Fmulder007/Karat-3.5/Photo/image002.jpg

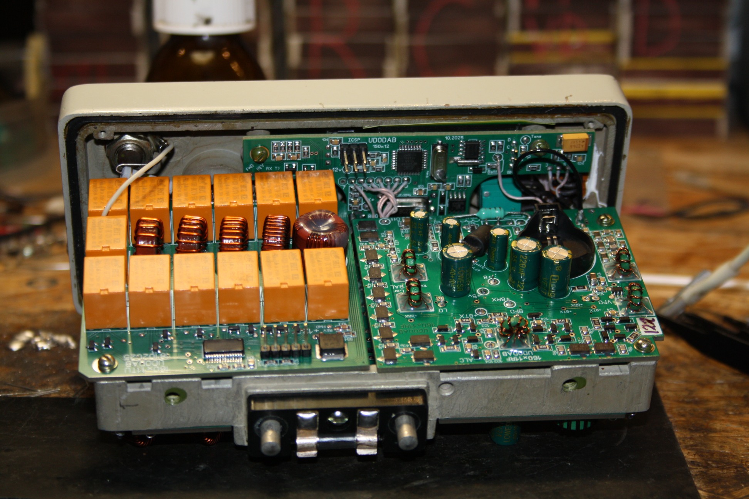
Photo/image002.jpg
