Fmulder007/Karat-3.5/Photo/2025-08-27_00-19-41.jpg

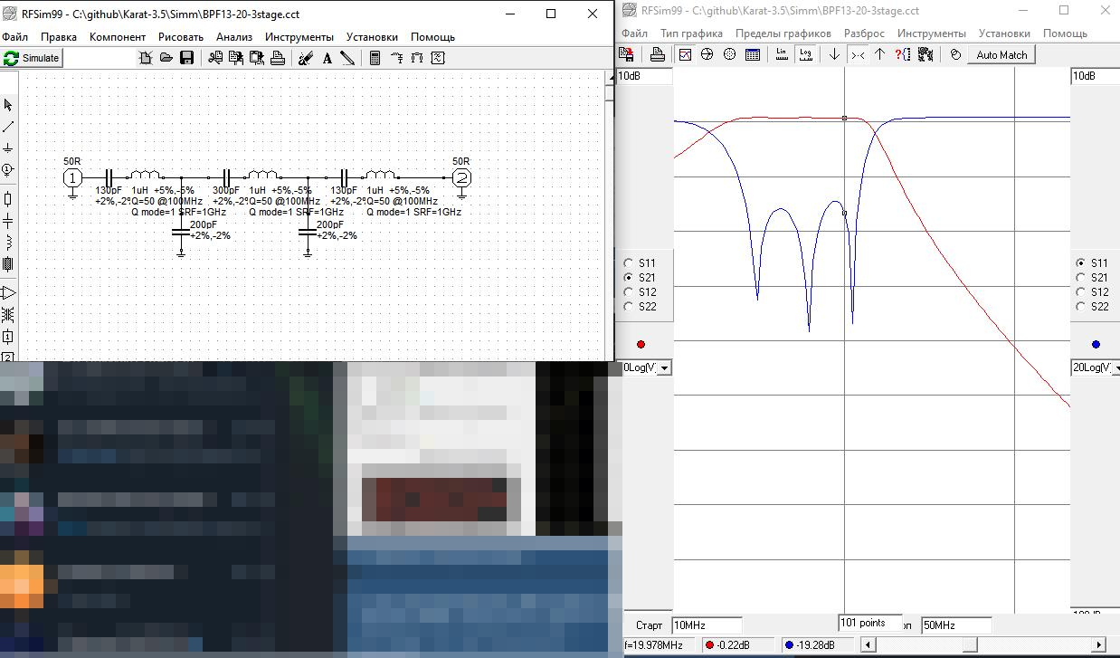
Photo/2025-08-27_00-19-41.jpg
