Fmulder007/Karat-3.5/Man/test.tex

\documentclass[12pt]{article}
% Эта строка — комментарий, она не будет показана в выходном файле
\usepackage{ucs}
\usepackage[utf8x]{inputenc} % Включаем поддержку UTF8
\usepackage[russian]{babel}  % Включаем пакет для поддержки русского языка
\title{\LaTeX}
\date{}
\author{}

\begin{document}
  %\maketitle
  \LaTeX{} "--- это своего рода препроцессор текста для \TeX{} "---
  программы компьютерной вёрстки. \LaTeX{} является программируемым и
  расширяемым, что позволяет автоматизировать большую часть аспектов
  набора, включая нумерацию, перекрёстные ссылки, таблицы и изображения
  (их размещение и подписи к ним), общий вид страницы, библиографию и
  многое-многое другое. \LaTeX{} был первоначально написан Лэсли Лампортом
  в 1984-м году и стал наиболее популярным способом использования \TeX{}а;
  очень мало людей сегодня пишут на оригинальном \TeX{}е. Текущей
  версией является \LaTeXe.
  \newline
  \begin{eqnarray}
    E &=& mc^2\\
    m &=& \frac{m_0}{\sqrt{1-\frac{v^2}{c^2}}}
  \end{eqnarray}
\end{document}
