Fmulder007/Karat-3.5/3D/Front_Panel.pdf

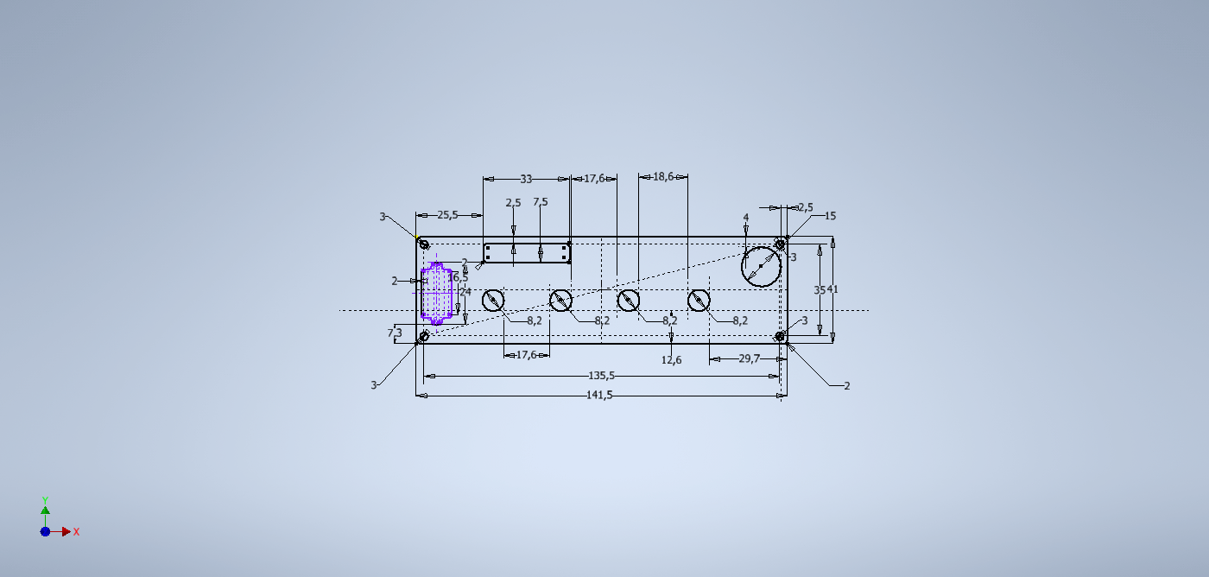
[picture p10: page 1]
