Fmulder007/Karat-3.5/Code/160x03/Карта меню.pdf

0 | Главный экран | Блок, если №100 = "Yes"
Быстрое меню:
1 | Канал | Блок, если №22 = "0"
2 | Шаг настройки | Блок, если №100 = "Yes"
3 | Полоса LSB/USB | Блок, если №100 = "Yes"
Пользовательское меню:
20 | Нижняя граница настройки(Канала) | Блок, если №100 = "Yes"
21 | Верхняя граница настройки(Канала) | Блок, если №100 = "Yes"
22 | Количество каналов | Блок, если №100 = "Yes"
23 | Часы
24 | Минуты
25 | CW Задержка
26 | CW тон
27 | Делитель энкодера | Блок, если №100 = "Yes"
28 | Реверс энкодера | Блок, если №100 = "Yes"
Инженерное меню | Вход Knob+PWR
100 | Канальный режим вкл/выкл
101 | Калибровка вольтметра
102 | Калибровка термометра
103 | Частота кварца синтезатора
104 | Частота 2пч RX LSB
105 | Частота 2пч TX LSB
106 | Частота 2пч RX USB
107 | Частота 2пч TX USB
108 | Коррекция 1пч
109 | Pulse Mode Yes/No
110 | ФНЧ передатчика
