Fmulder007/Karat-3.5/3D/Front_Panel.tiff

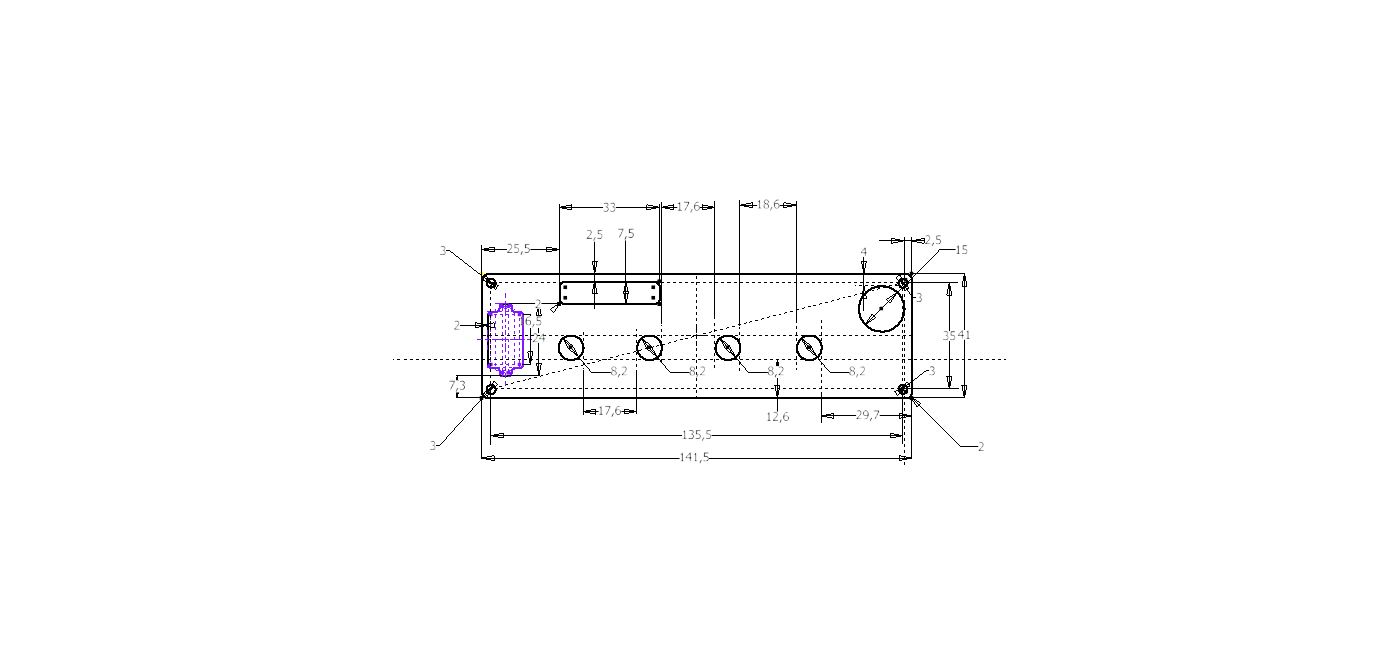
3D/Front_Panel.tiff
