Fmulder007/Karat-3.5/AFC/101-13M.jpg

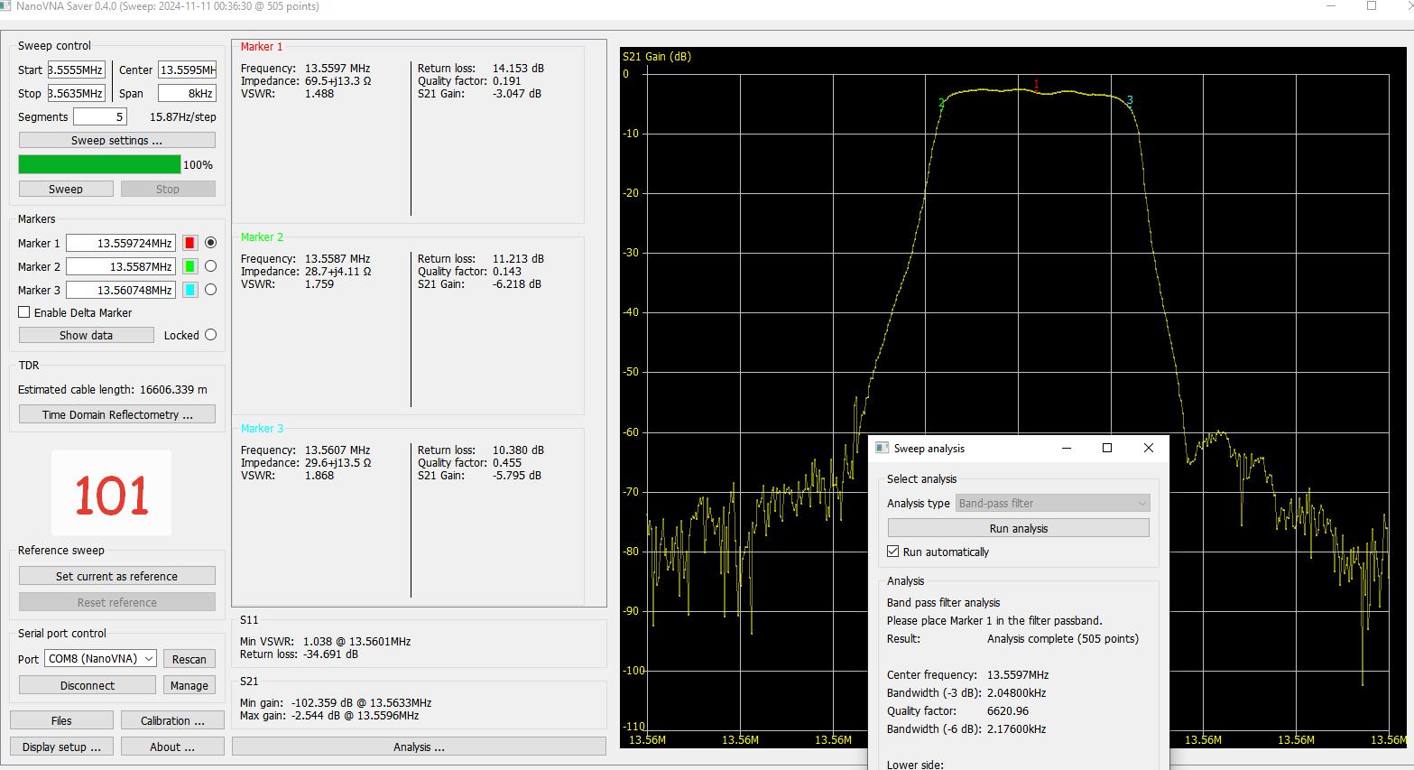
AFC/101-13M.jpg
