Fmulder007/Karat-3.5/AFC/101-48M.jpg

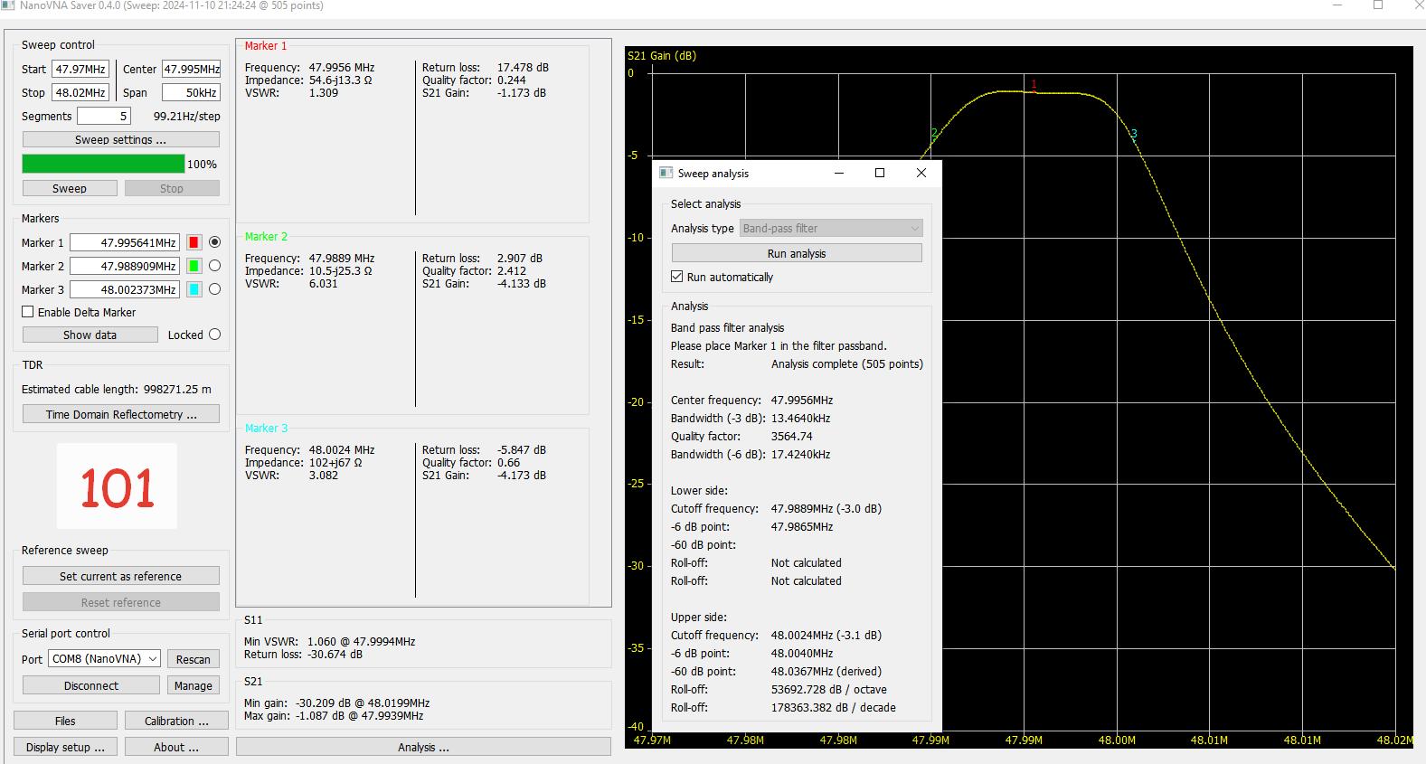
AFC/101-48M.jpg
