Fmulder007/Karat-3.5/AFC/101-LPF.jpg

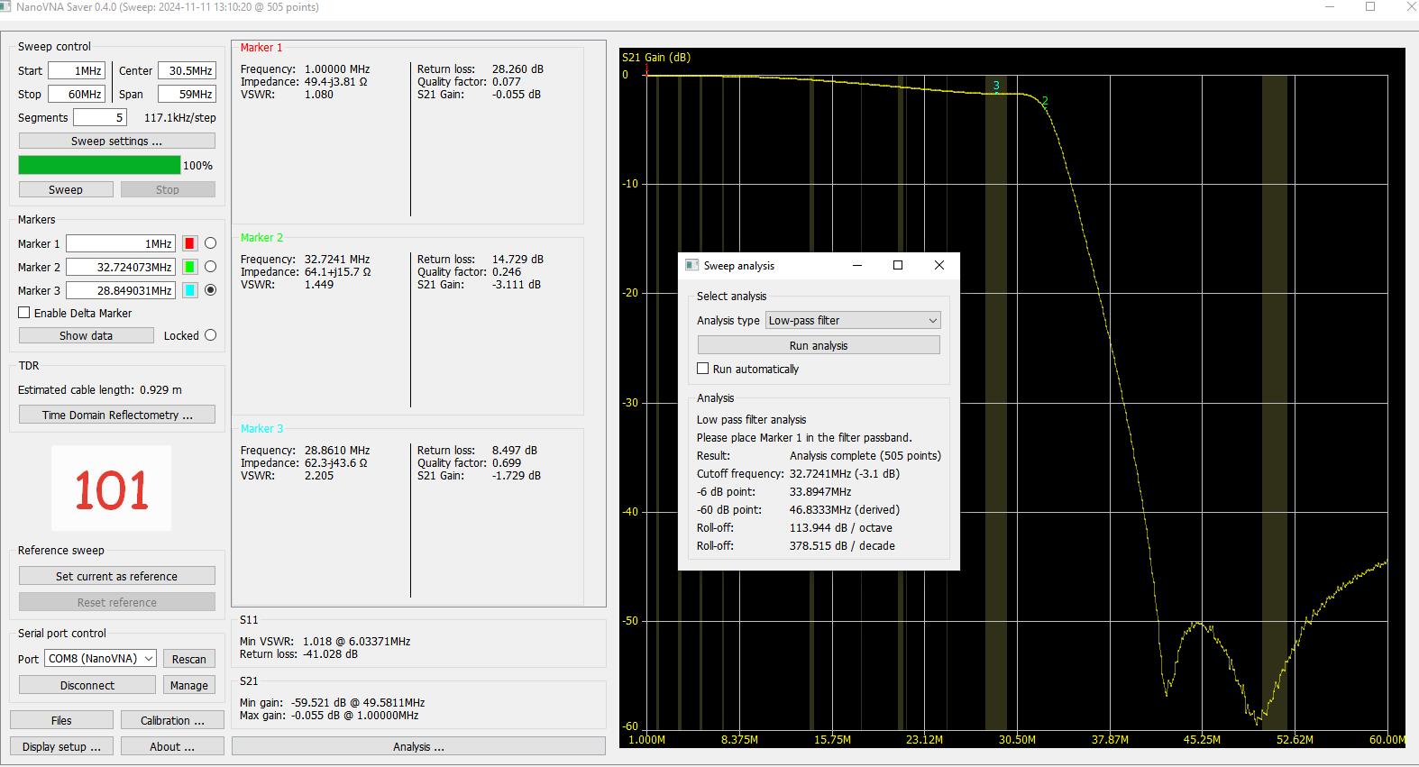
AFC/101-LPF.jpg
