Fmulder007/Karat-3.5/AFC/102-13M.jpg

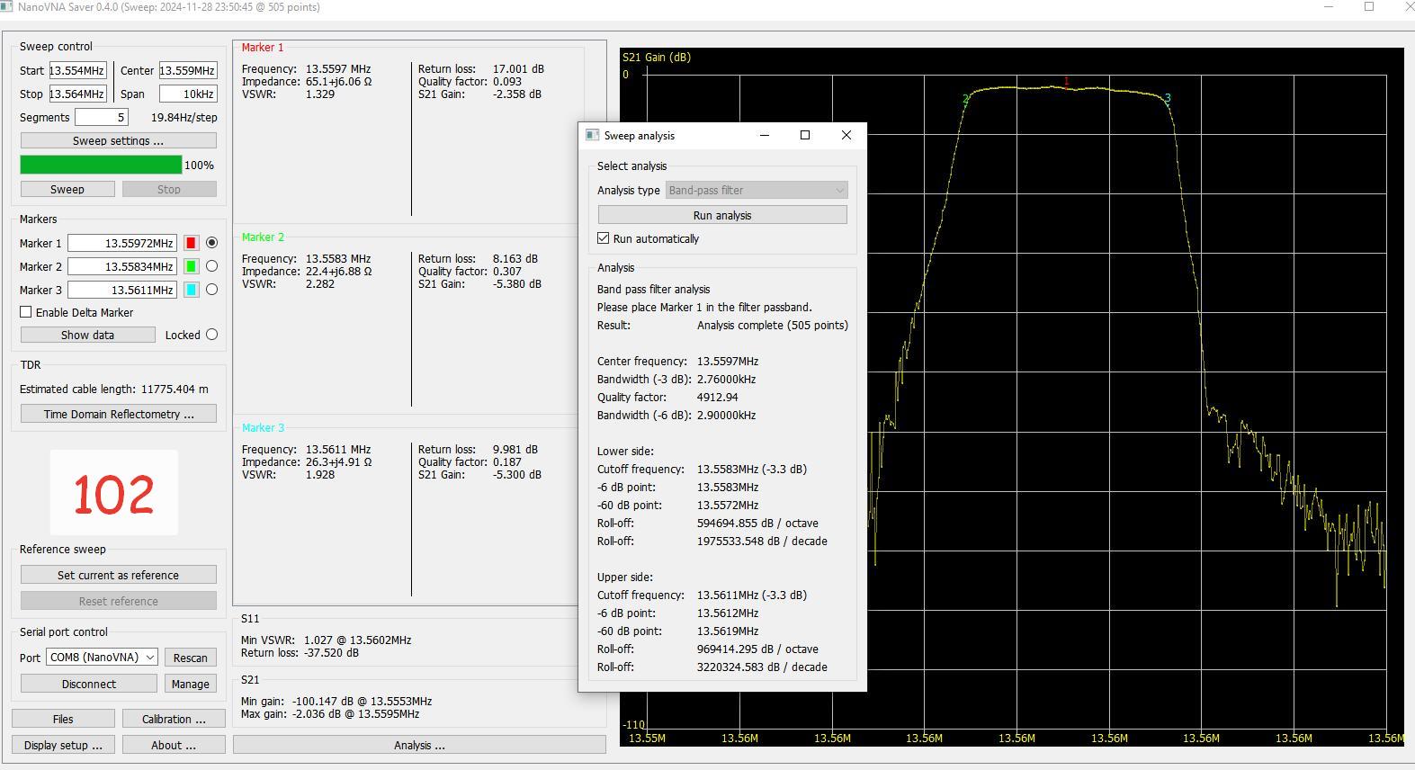
AFC/102-13M.jpg
