Fmulder007/Karat-3.5/AFC/102-48M.jpg

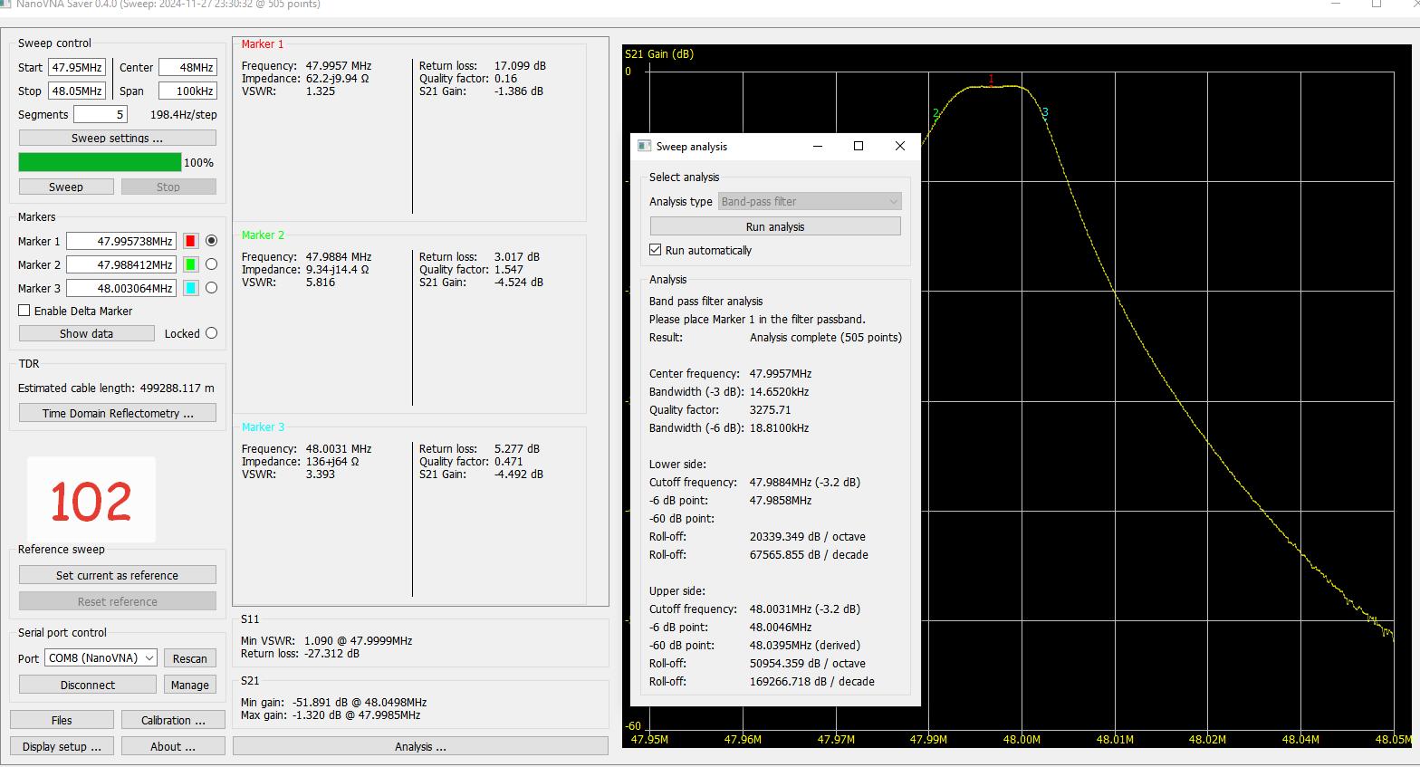
AFC/102-48M.jpg
