Fmulder007/Karat-3.5/AFC/103-13M.jpg

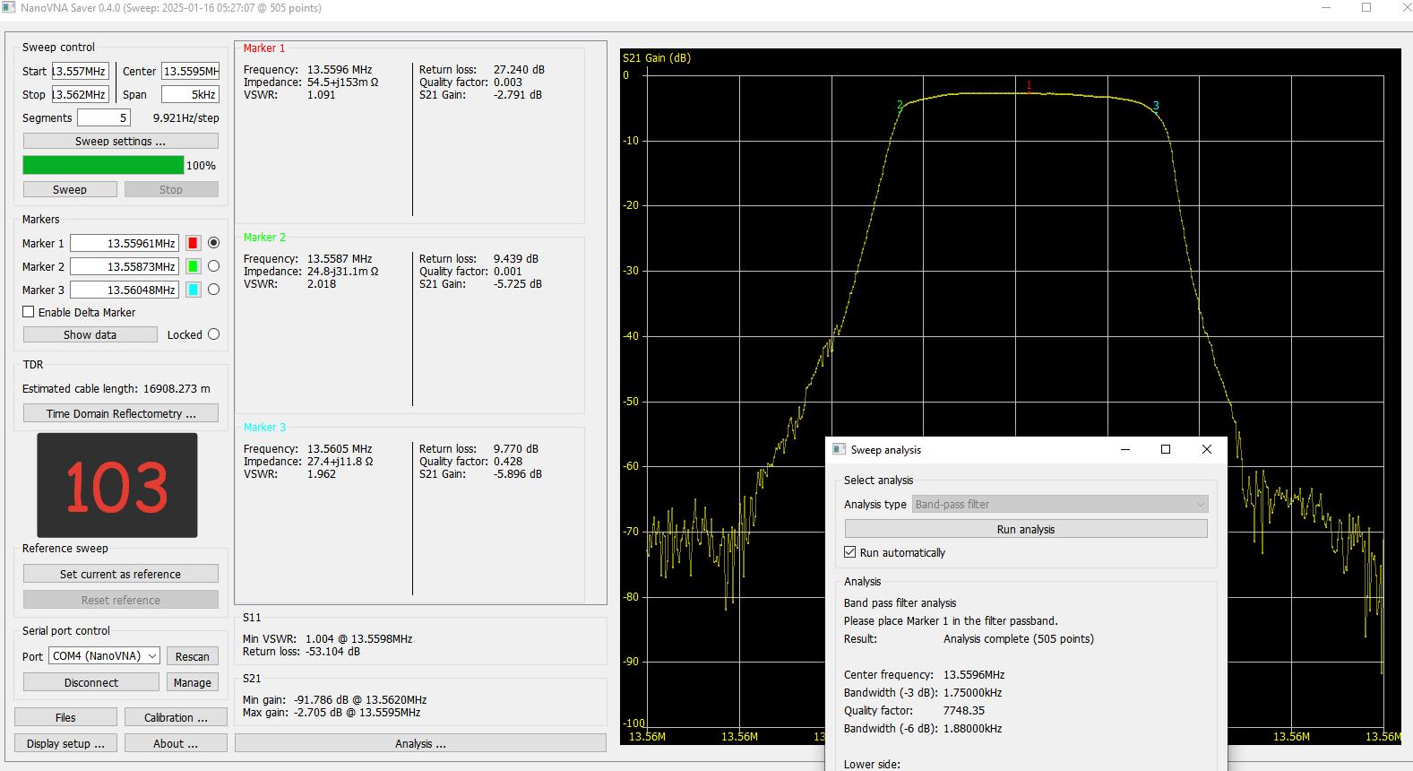
AFC/103-13M.jpg
