Fmulder007/Karat-3.5/AFC/104-13M.jpg

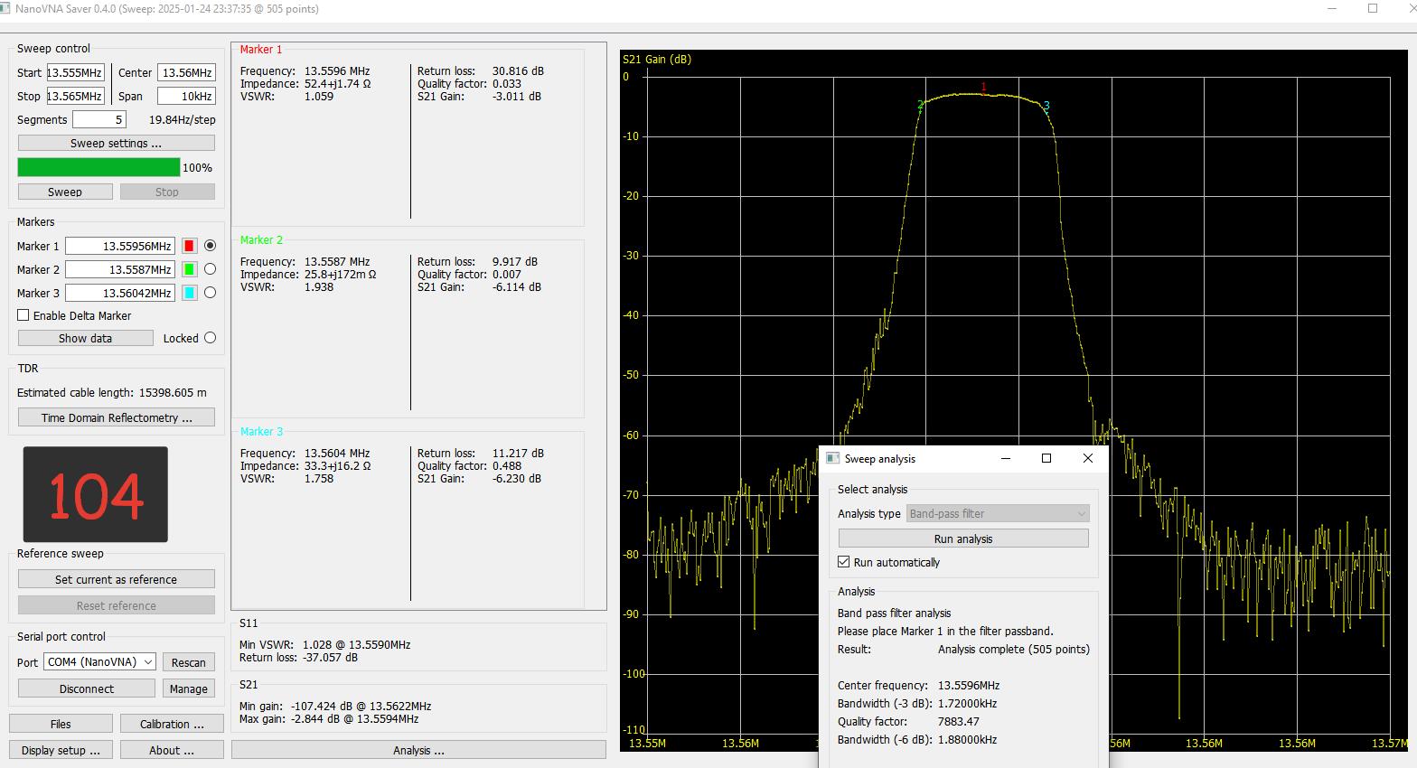
AFC/104-13M.jpg
