Fmulder007/Karat-3.5/AFC/105-13M.jpg

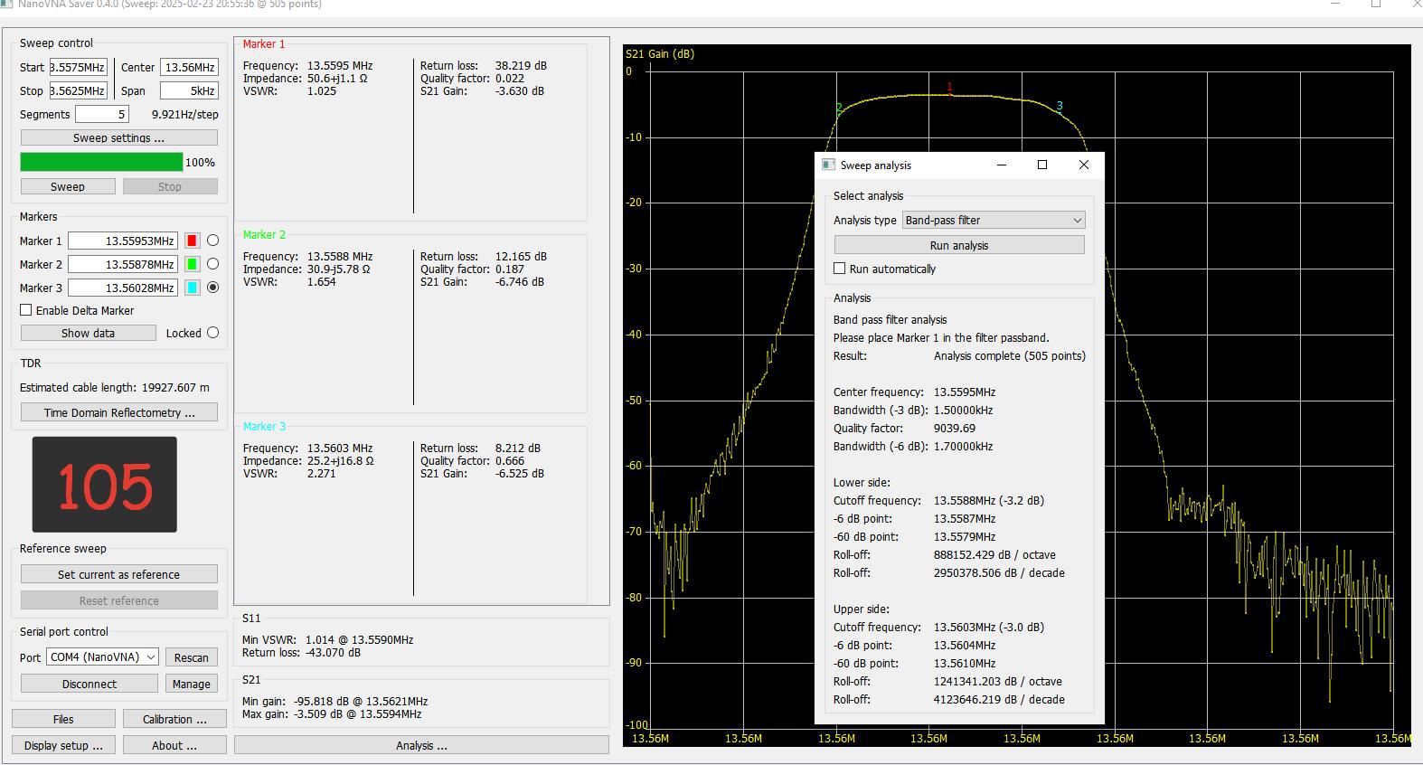
AFC/105-13M.jpg
