Fmulder007/Karat-3.5/AFC/105-LPF.jpg

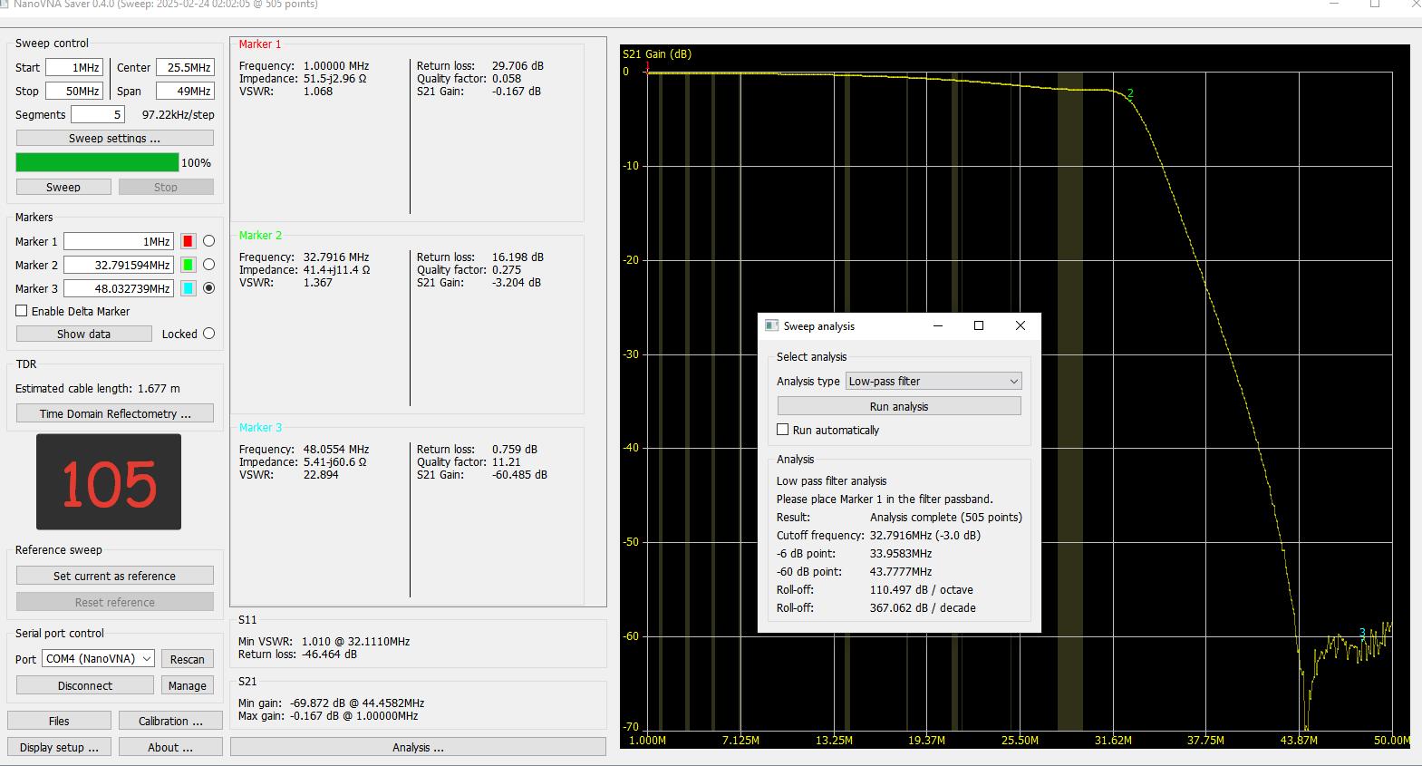
AFC/105-LPF.jpg
