Fmulder007/Karat-3.5/AFC/106-13M.jpg

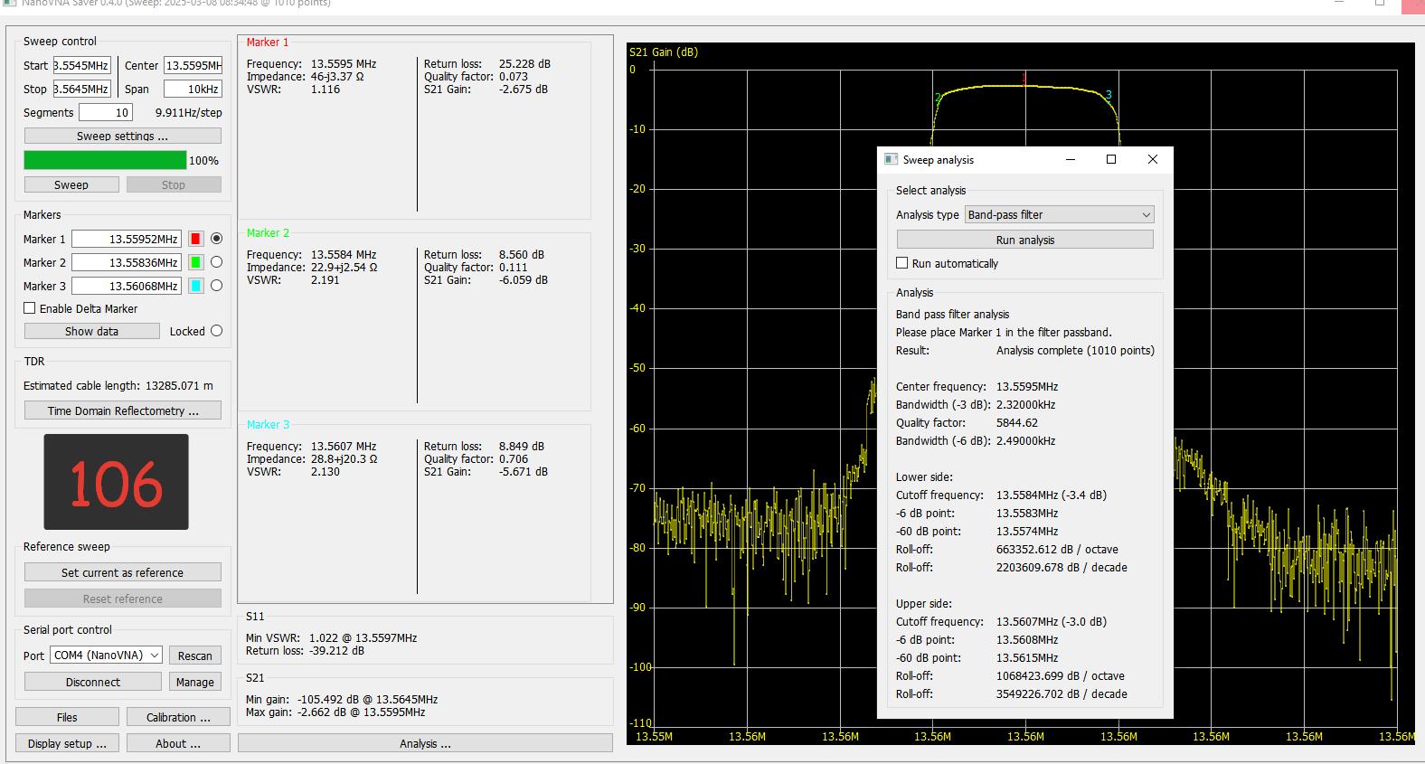
AFC/106-13M.jpg
