Fmulder007/Karat-3.5/AFC/106-LPF.jpg

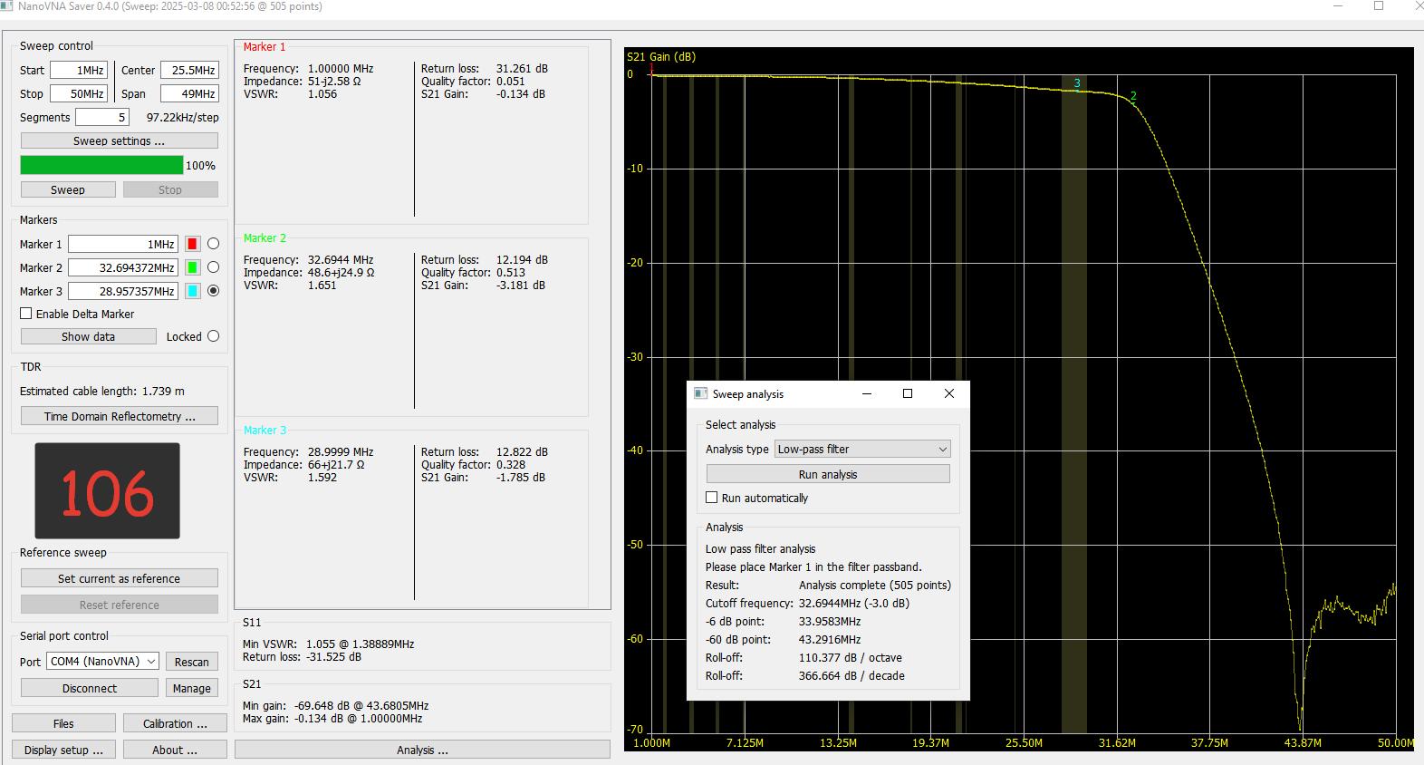
AFC/106-LPF.jpg
