Fmulder007/Karat-3.5/AFC/107-48M.jpg

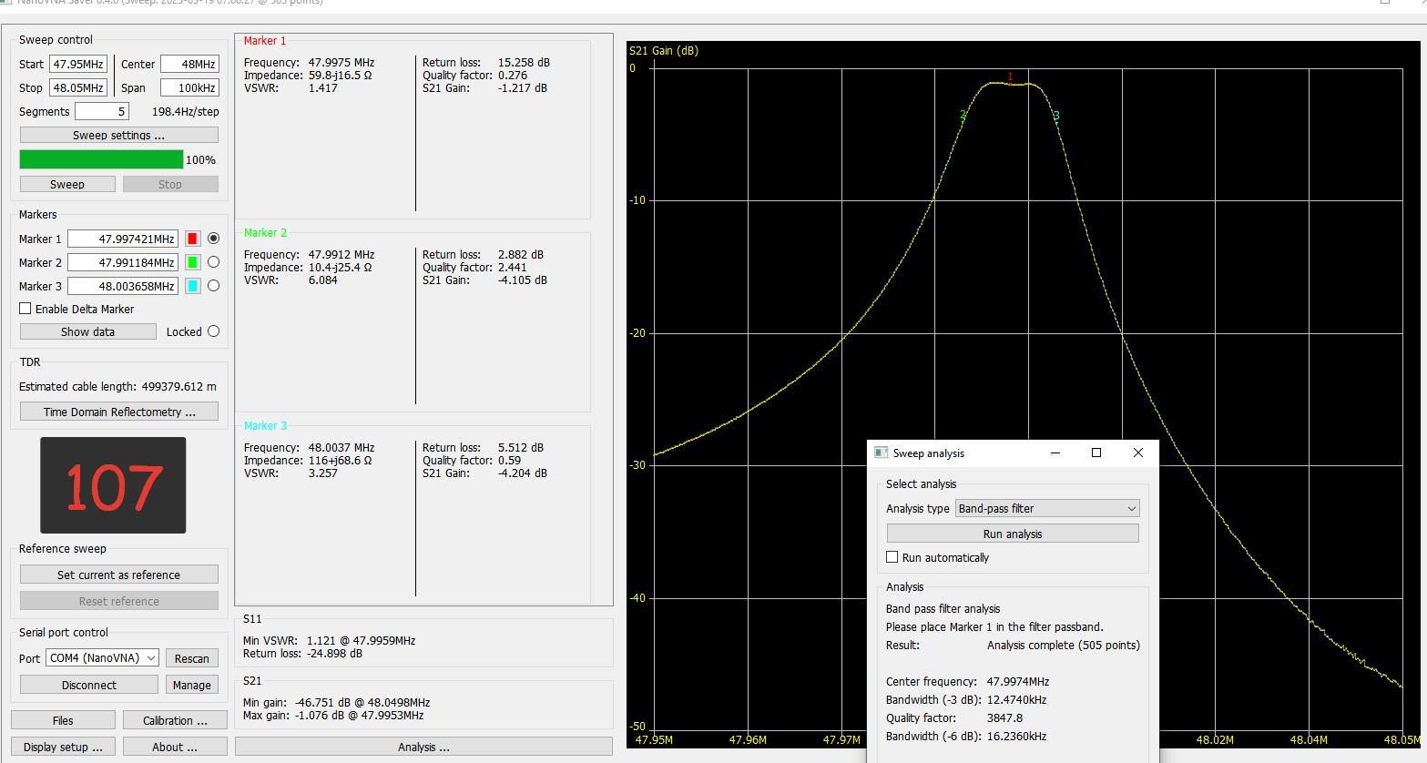
AFC/107-48M.jpg
