Fmulder007/Karat-3.5/AFC/108-48M.jpg

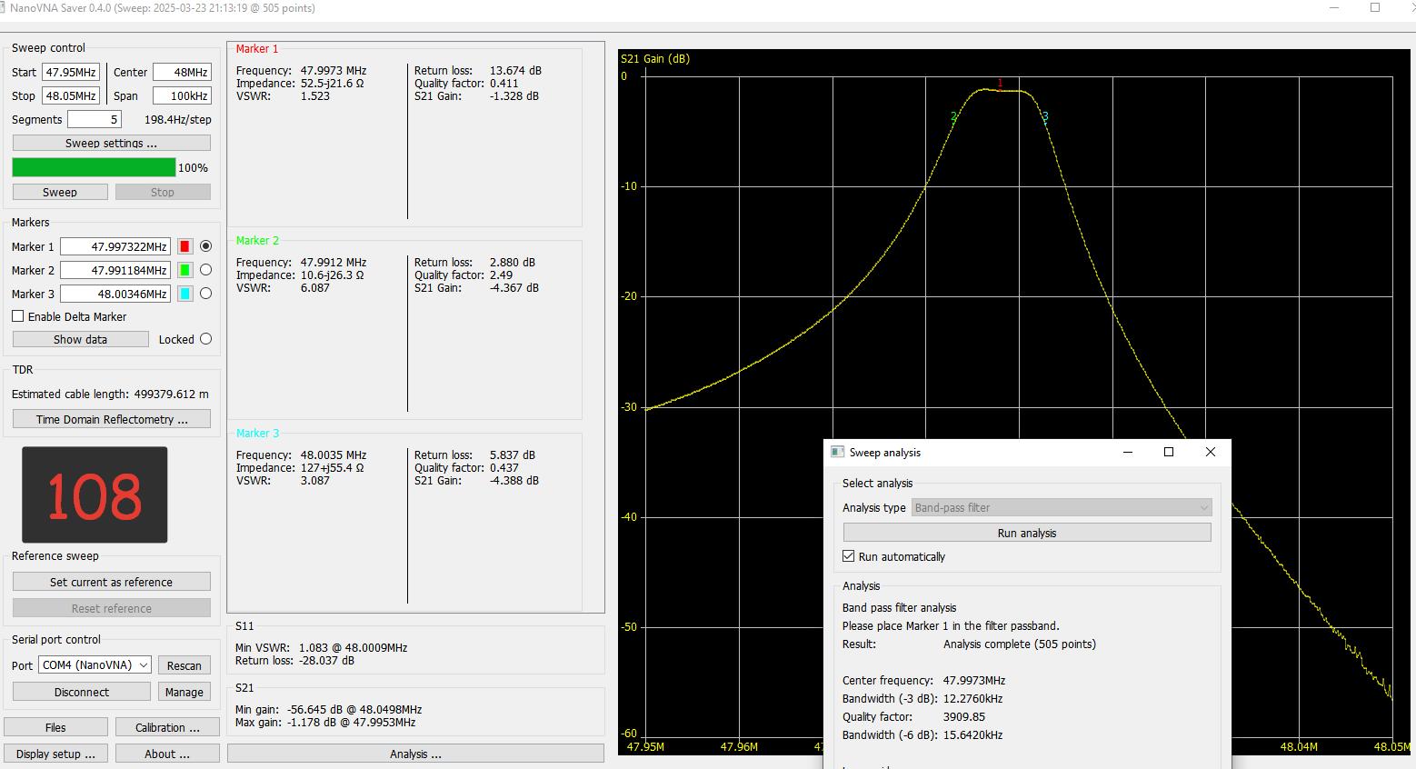
AFC/108-48M.jpg
