Fmulder007/Karat-3.5/AFC/109-13M.jpg

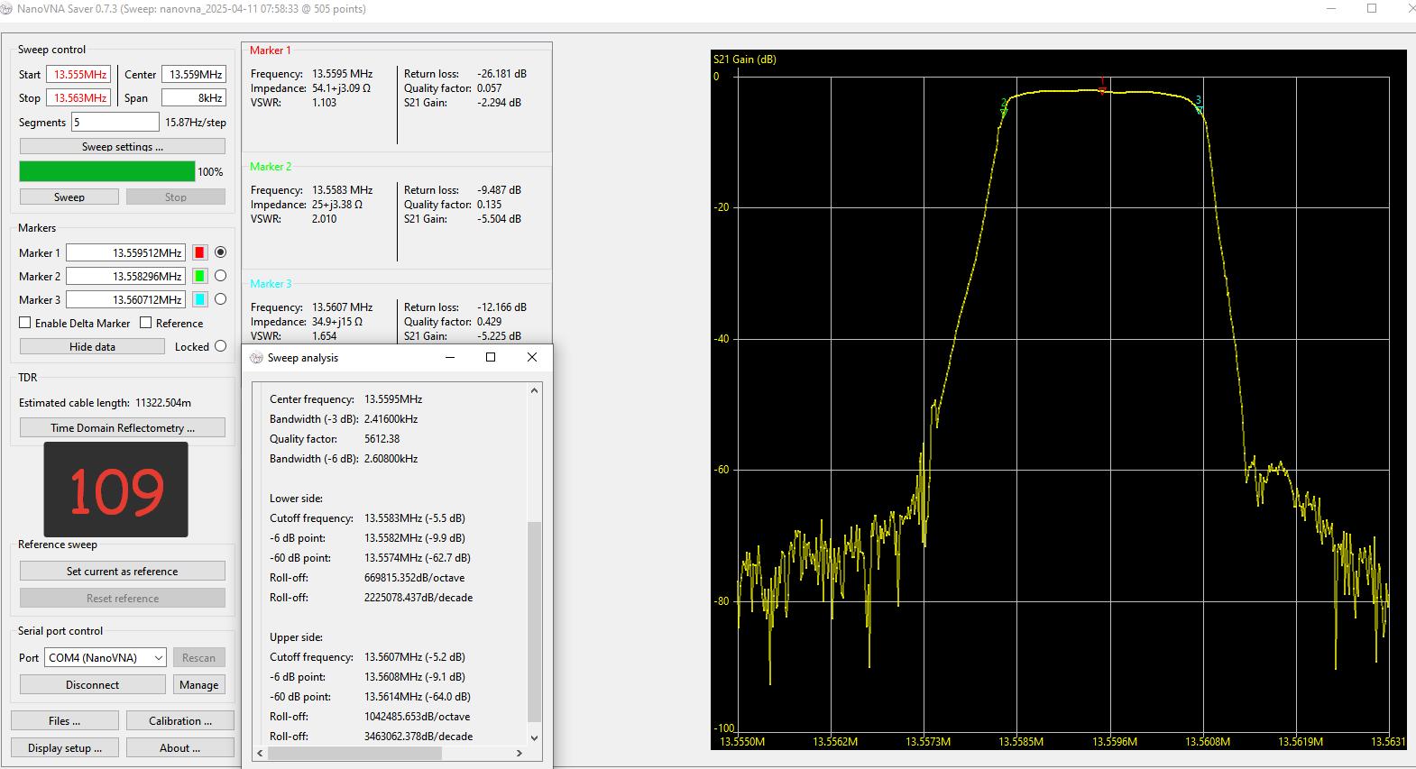
AFC/109-13M.jpg
