Fmulder007/Karat-3.5/AFC/109-48M.jpg

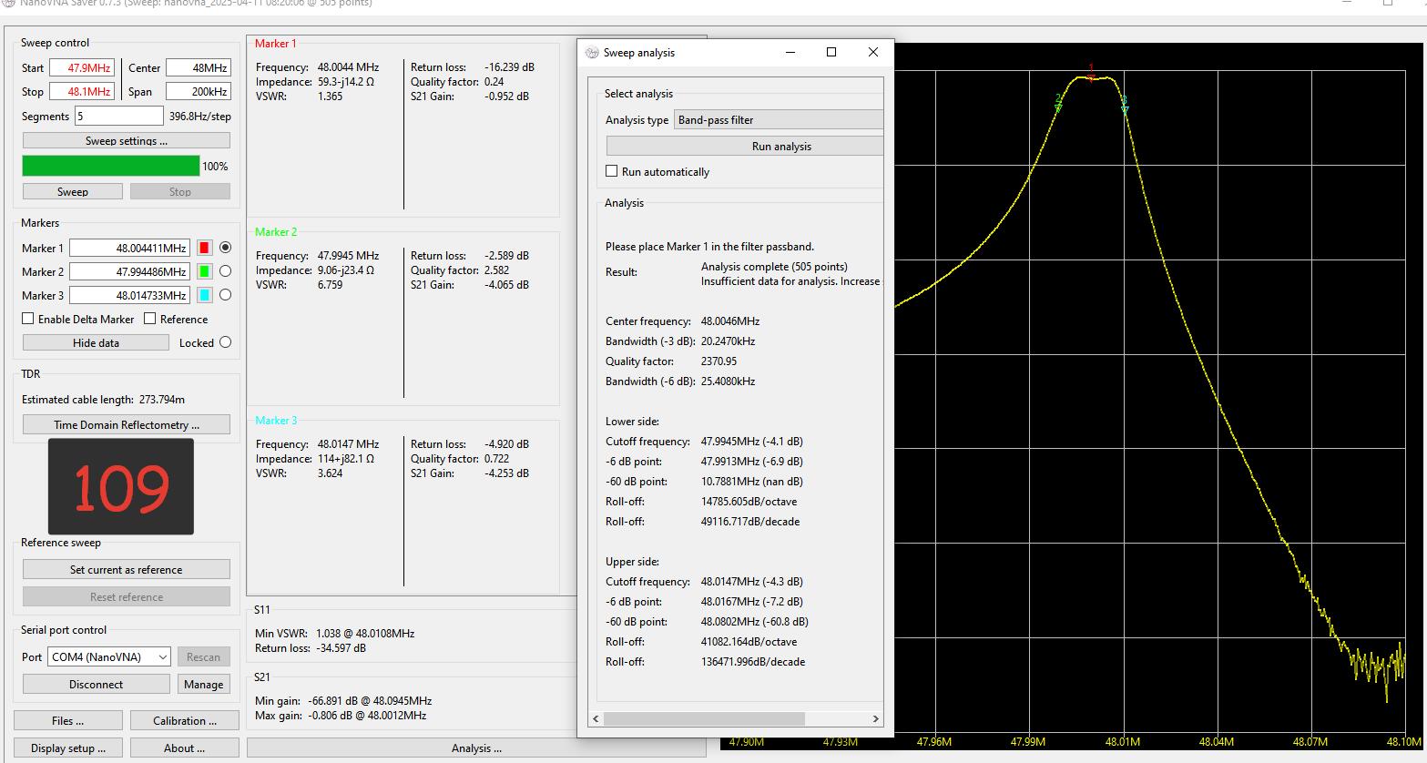
AFC/109-48M.jpg
