Fmulder007/Karat-3.5/AFC/110-13M.jpg

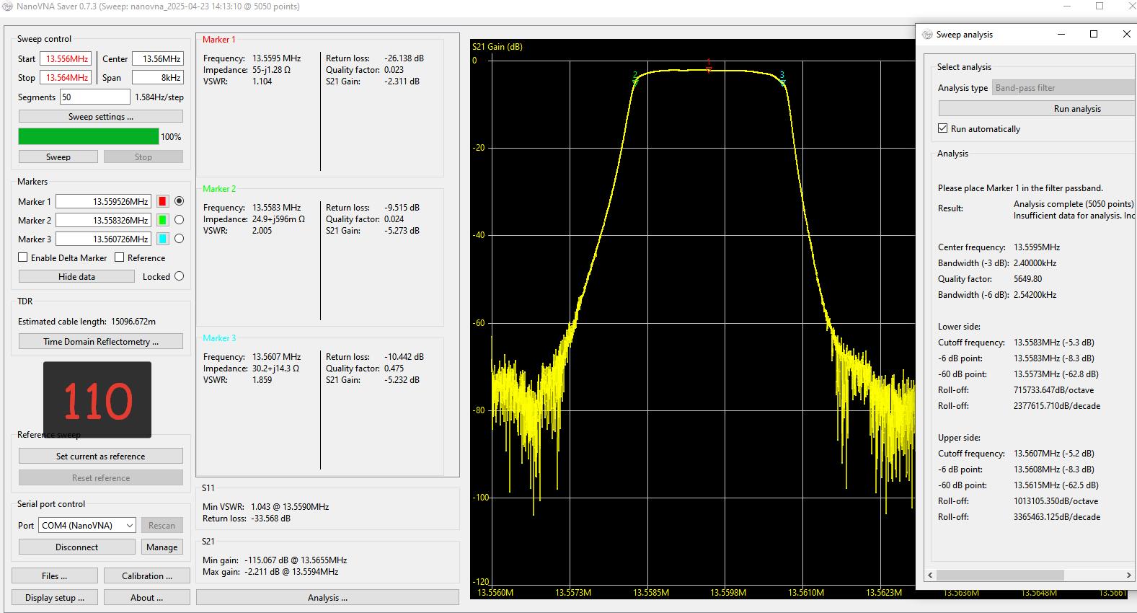
AFC/110-13M.jpg
