Fmulder007/Karat-3.5/AFC/110-48M.jpg

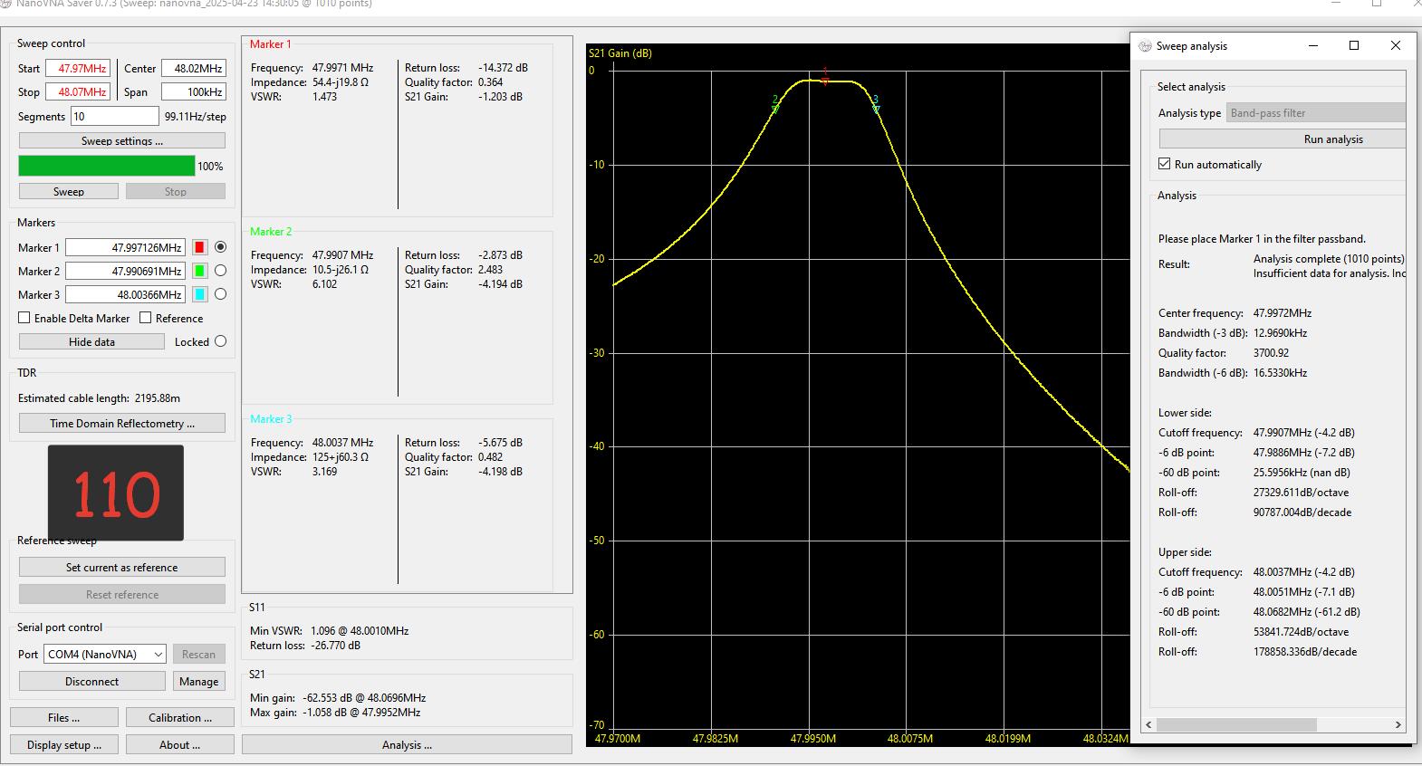
AFC/110-48M.jpg
