Fmulder007/Karat-3.5/AFC/111-13M.jpg

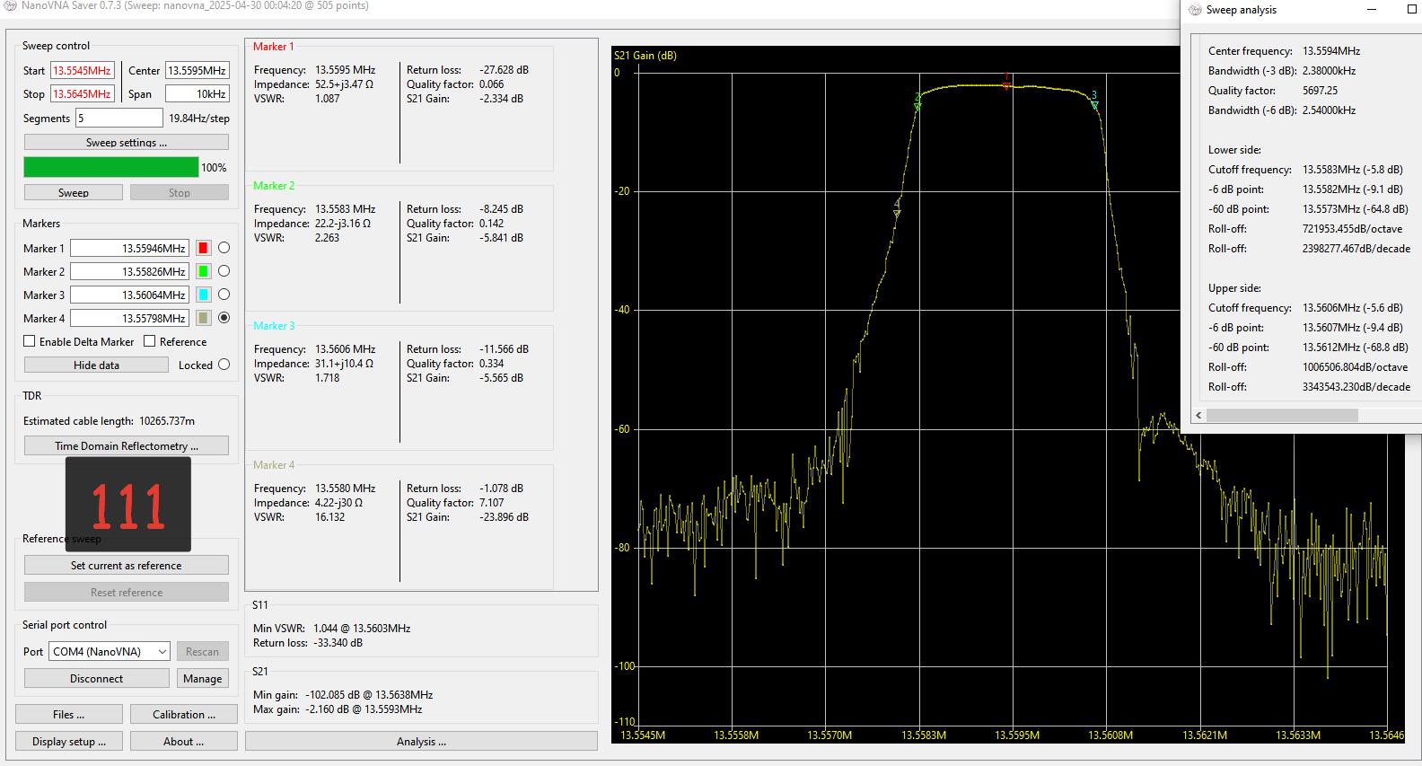
AFC/111-13M.jpg
