Fmulder007/Karat-3.5/AFC/112-13M.jpg

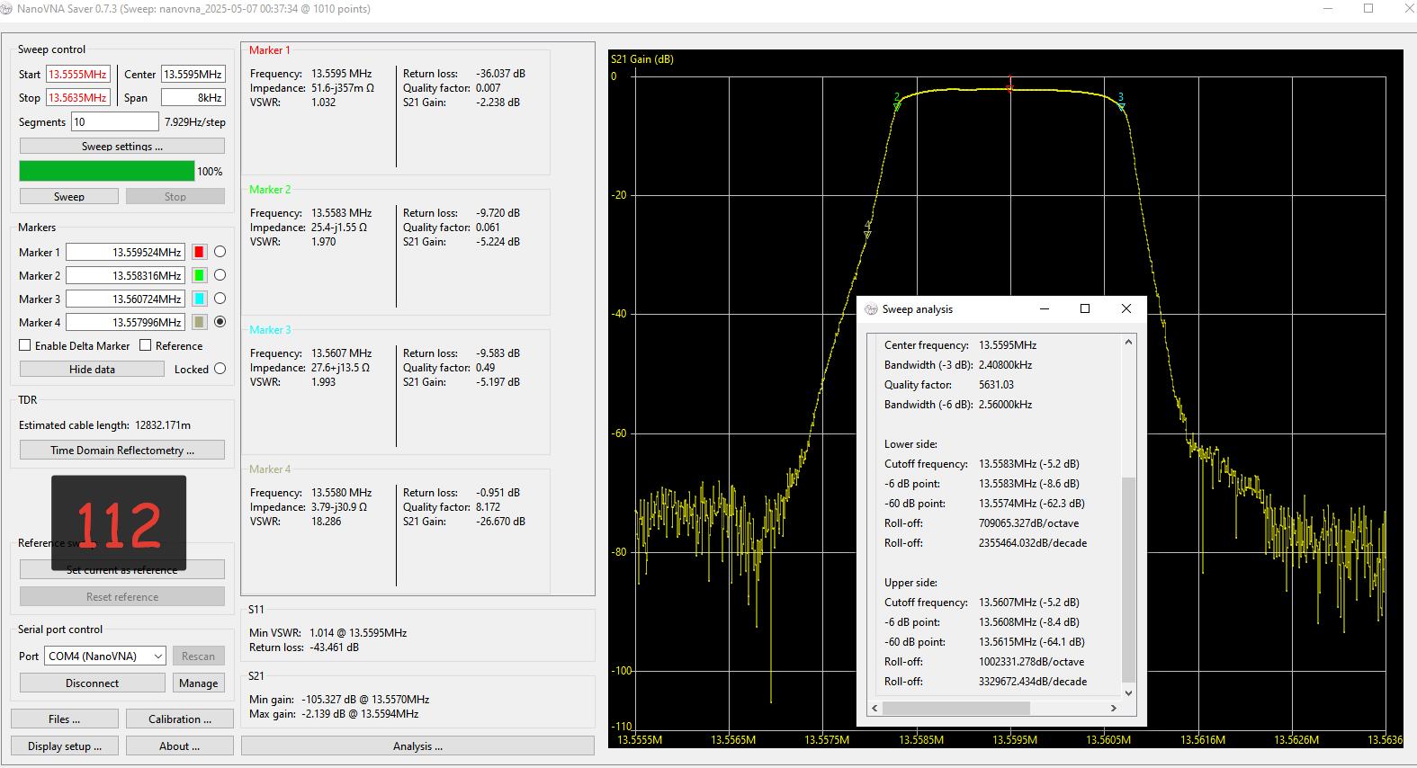
AFC/112-13M.jpg
