Fmulder007/Karat-3.5/AFC/112-48M.jpg

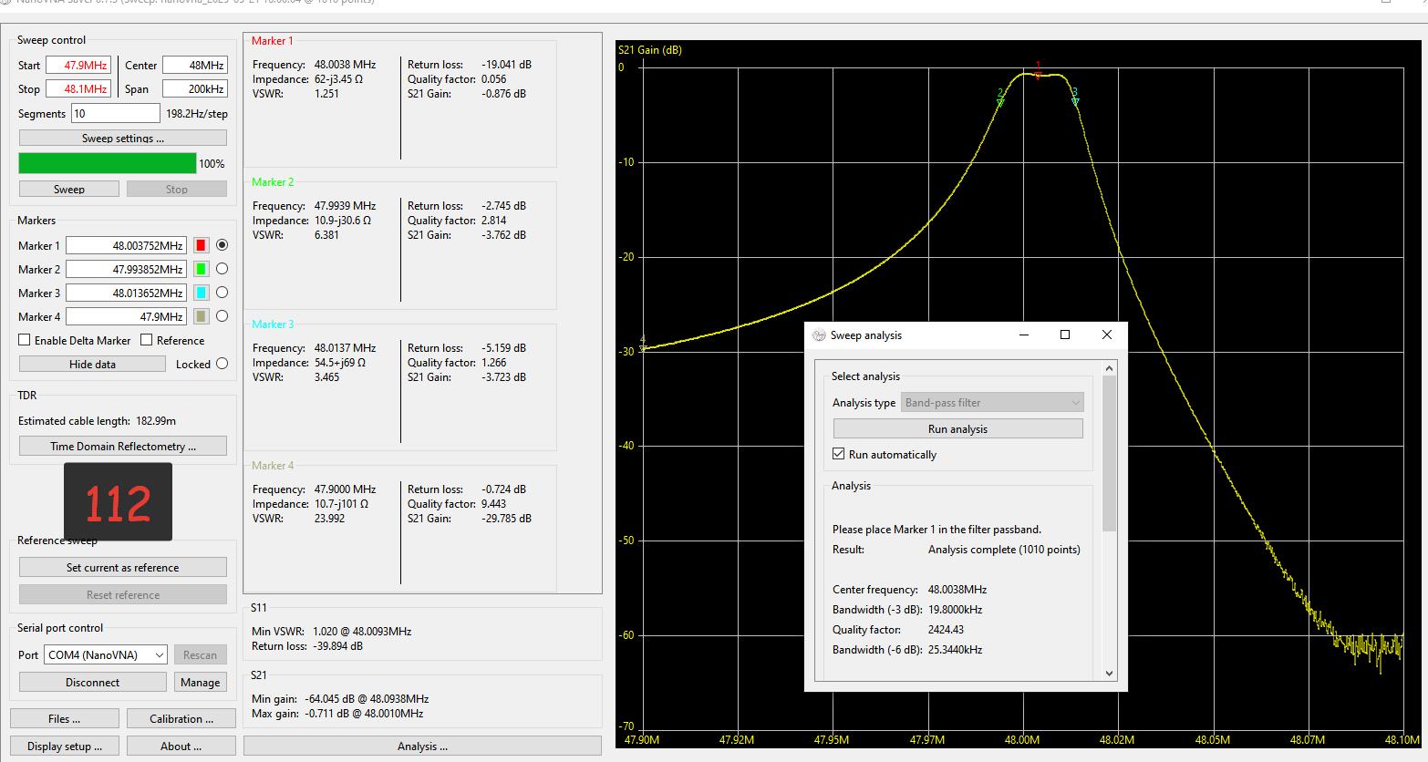
AFC/112-48M.jpg
