Fmulder007/Karat-3.5/AFC/112-LPF.jpg

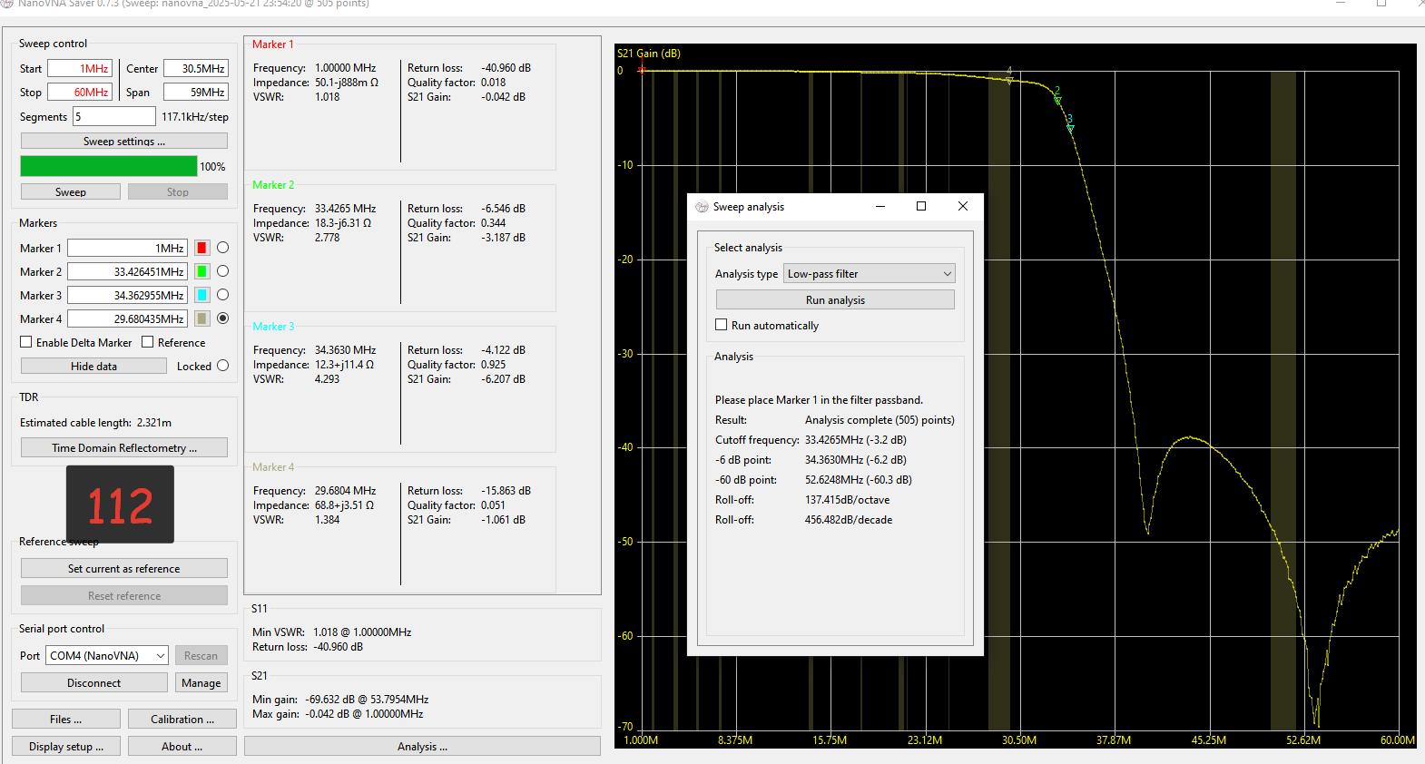
AFC/112-LPF.jpg
