Fmulder007/Karat-3.5/AFC/113-48M.jpg

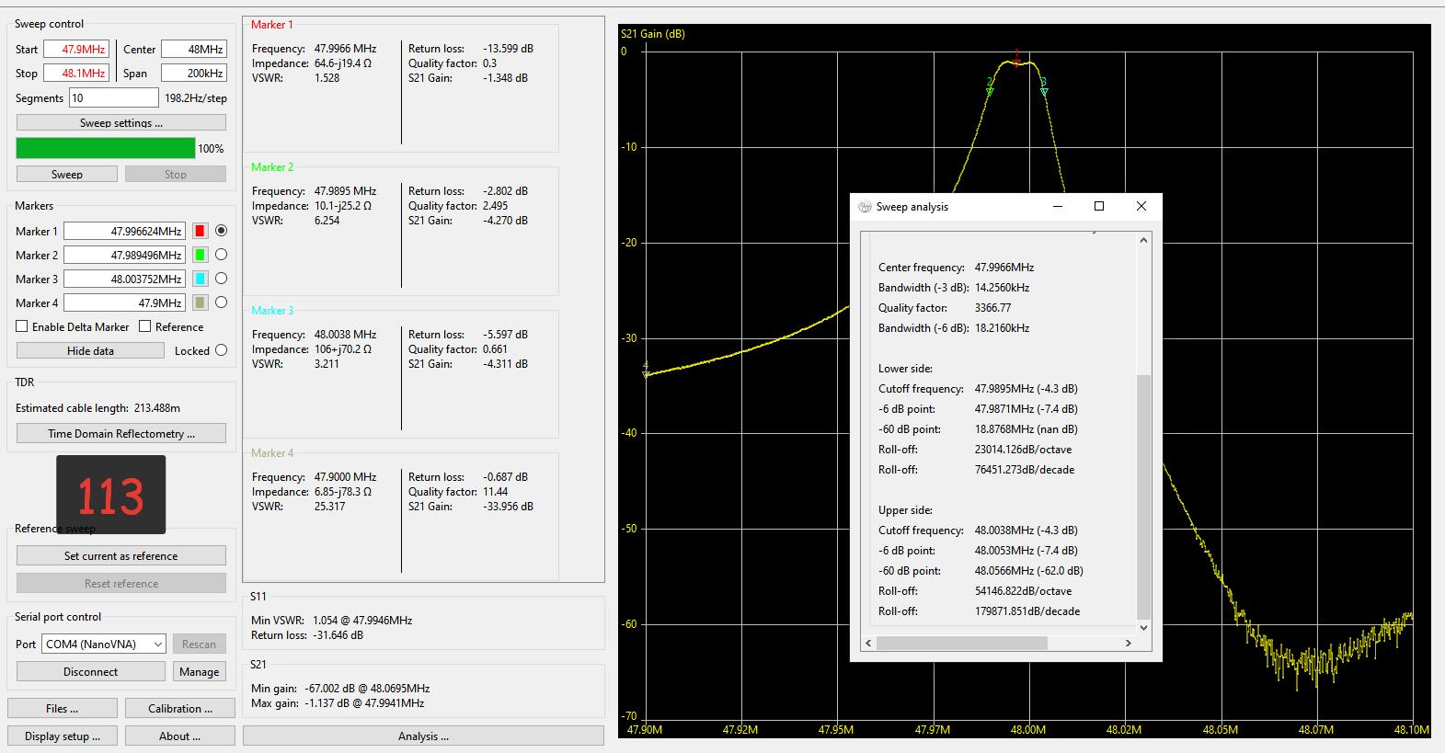
AFC/113-48M.jpg
