Fmulder007/Karat-3.5/AFC/113-LPF.jpg

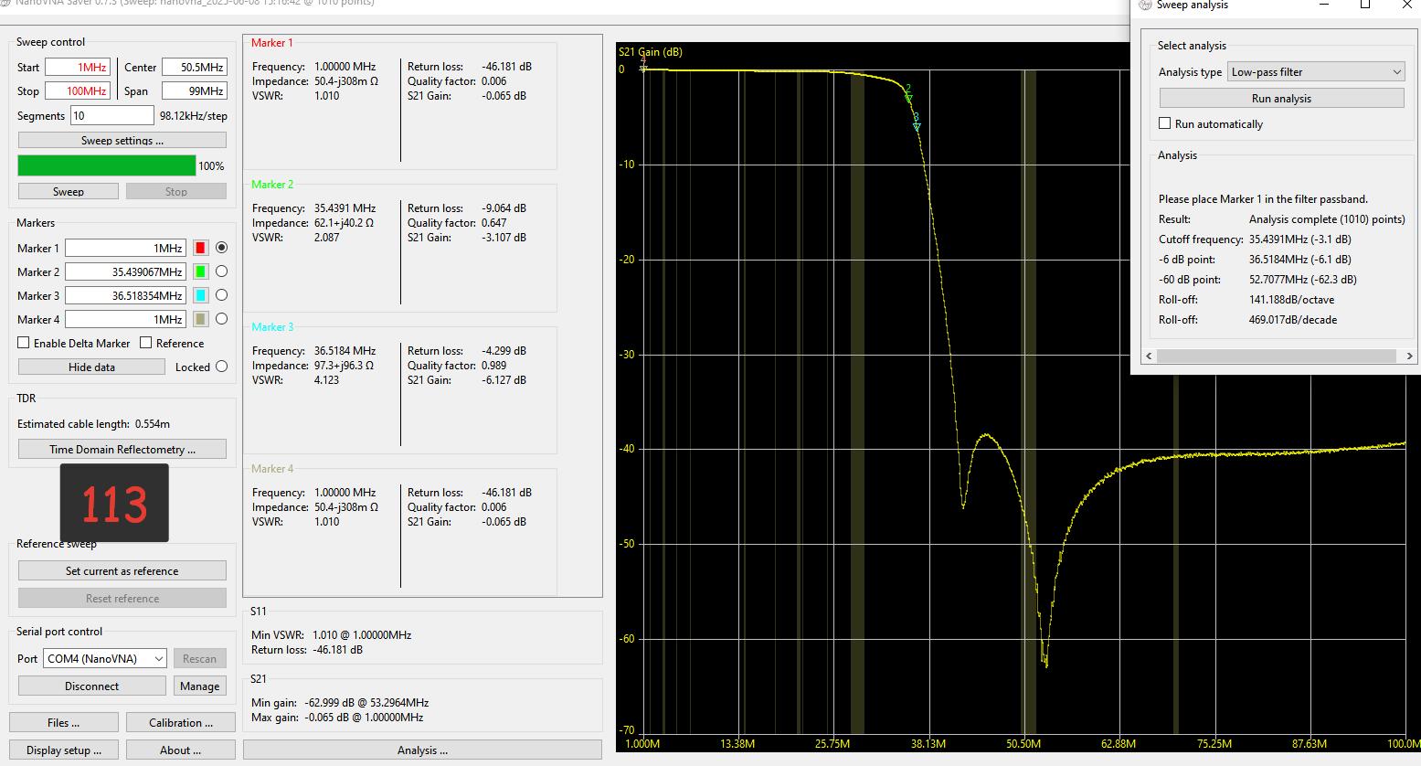
AFC/113-LPF.jpg
