Fmulder007/Karat-3.5/AFC/114-13M.jpg

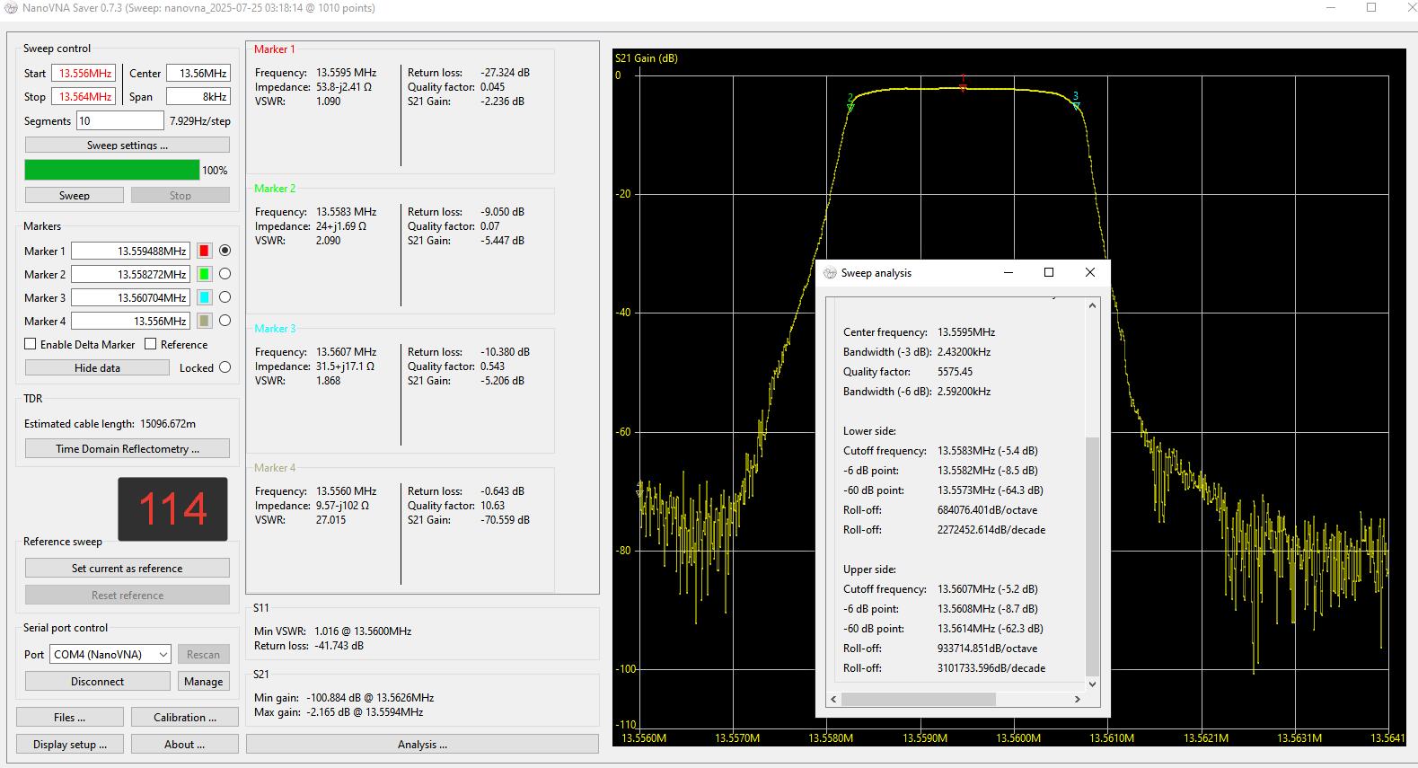
AFC/114-13M.jpg
