Fmulder007/Karat-3.5/AFC/114-48M.jpg

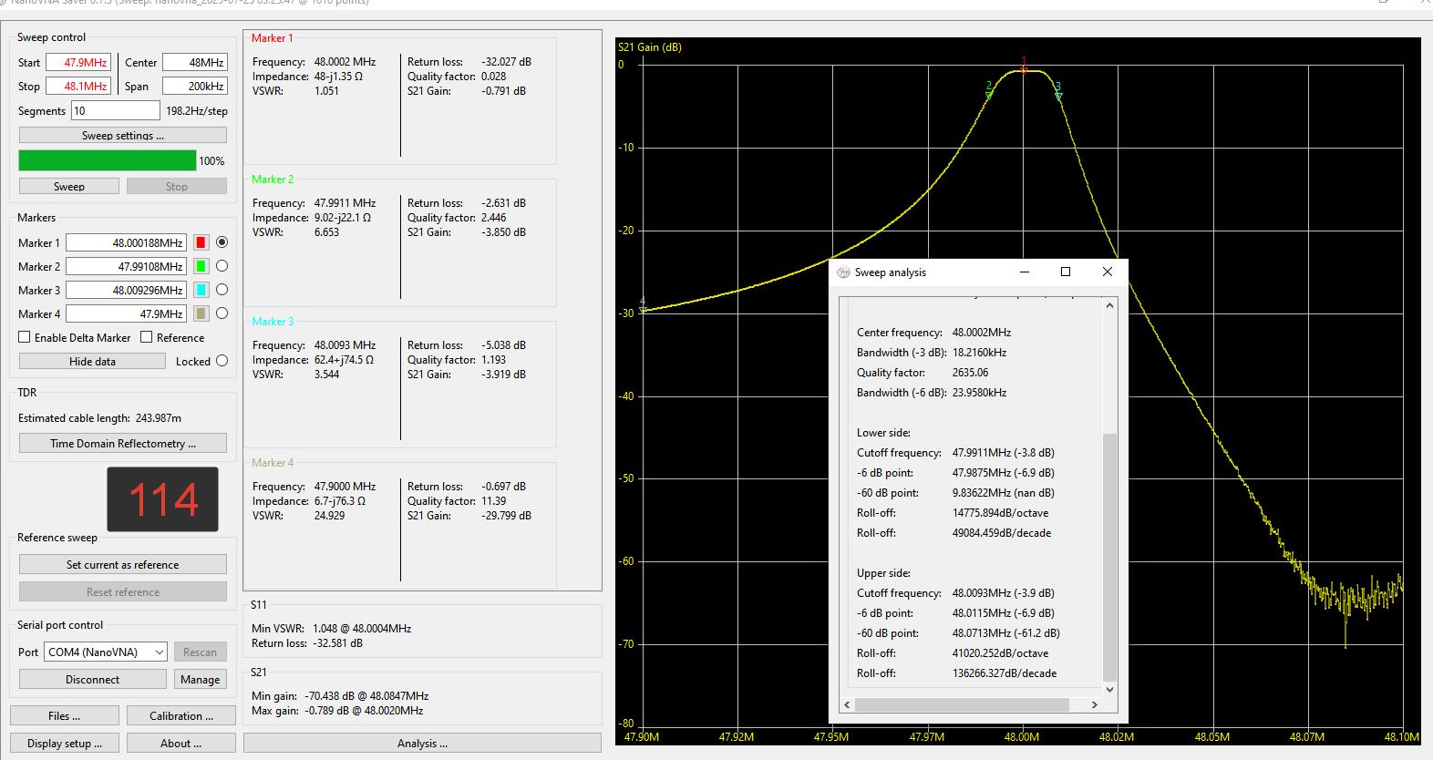
AFC/114-48M.jpg
