Fmulder007/Karat-3.5/AFC/114-LPF.jpg

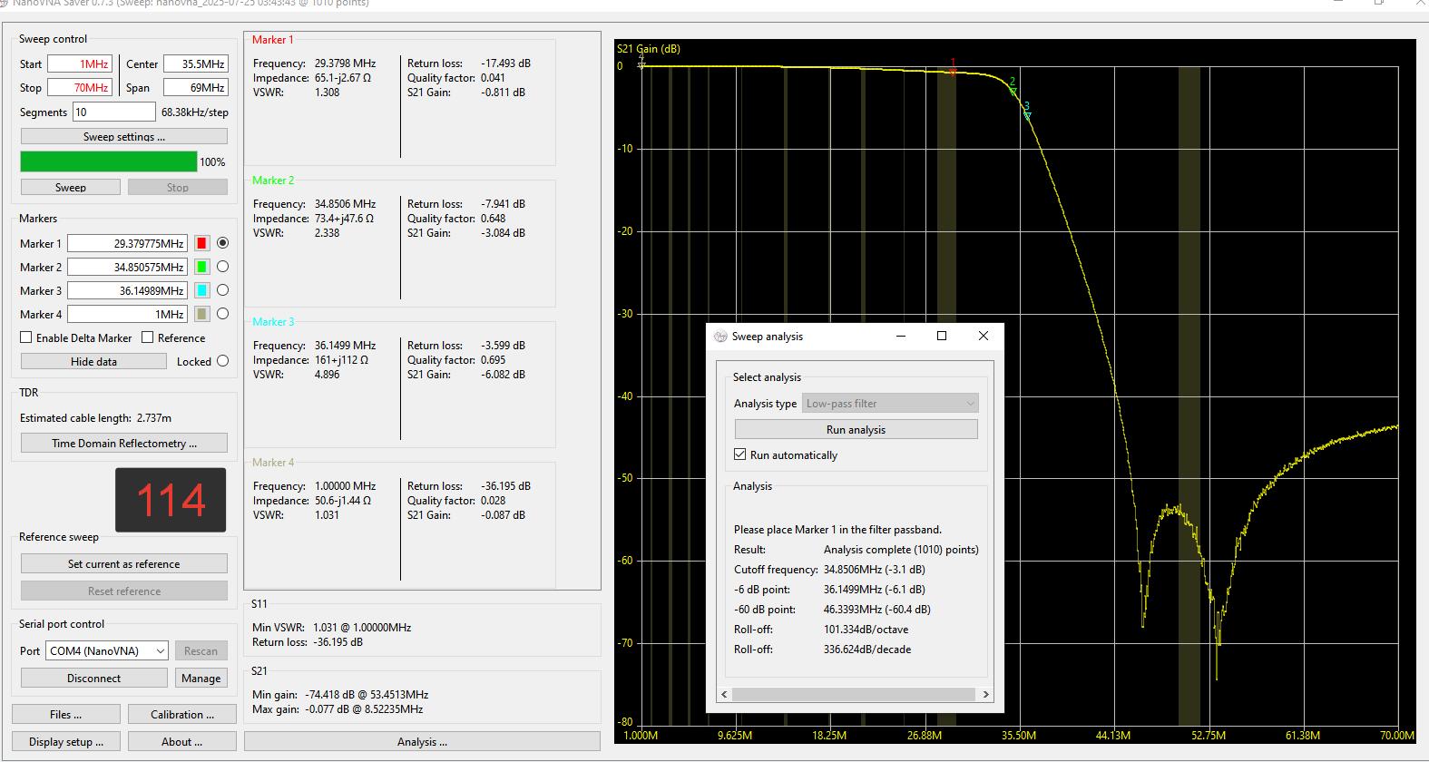
AFC/114-LPF.jpg
