Fmulder007/Karat-3.5/AFC/115-48M.jpg

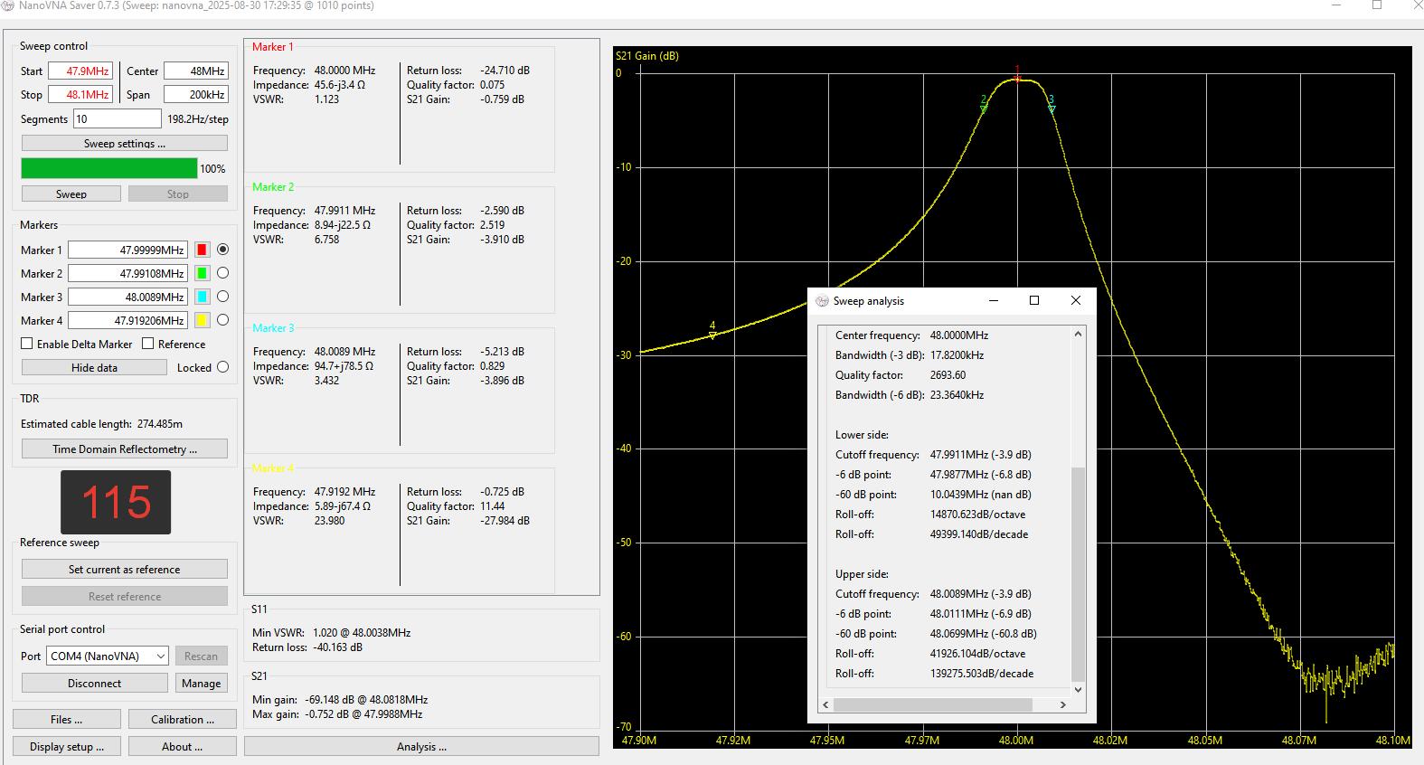
AFC/115-48M.jpg
