Fmulder007/Karat-3.5/AFC/116-13M.jpg

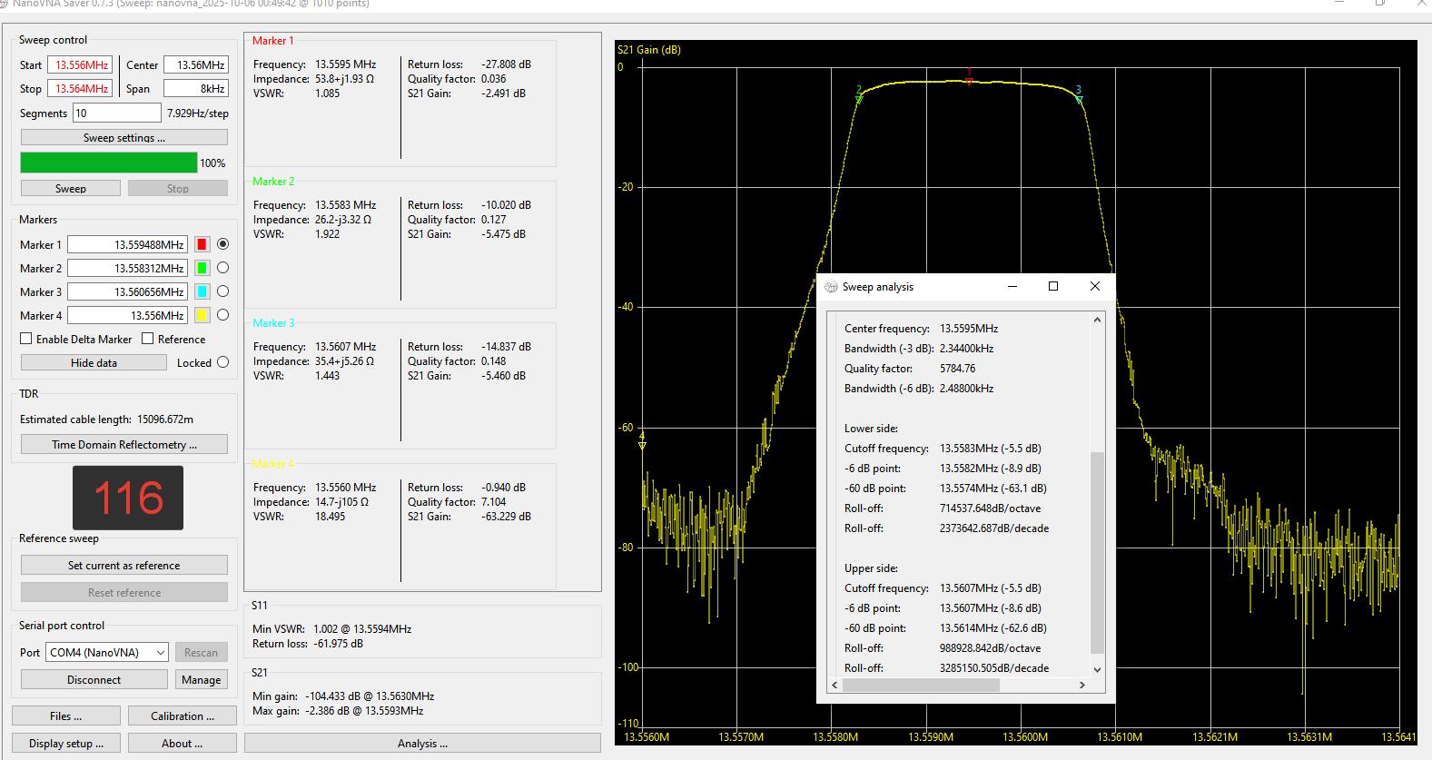
AFC/116-13M.jpg
