Fmulder007/Karat-3.5/AFC/117-48M.jpg

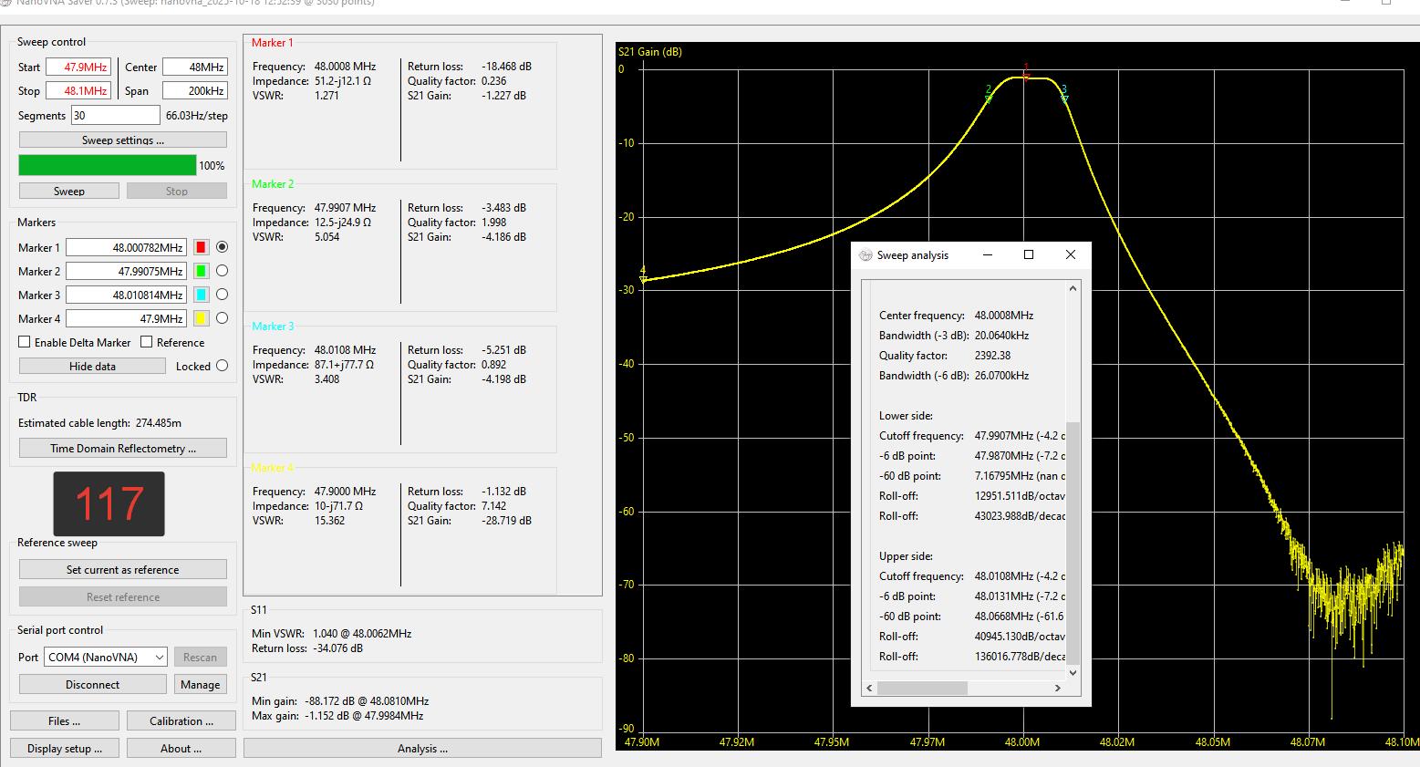
AFC/117-48M.jpg
