Fmulder007/Karat-3.5/AFC/117-LPF.jpg

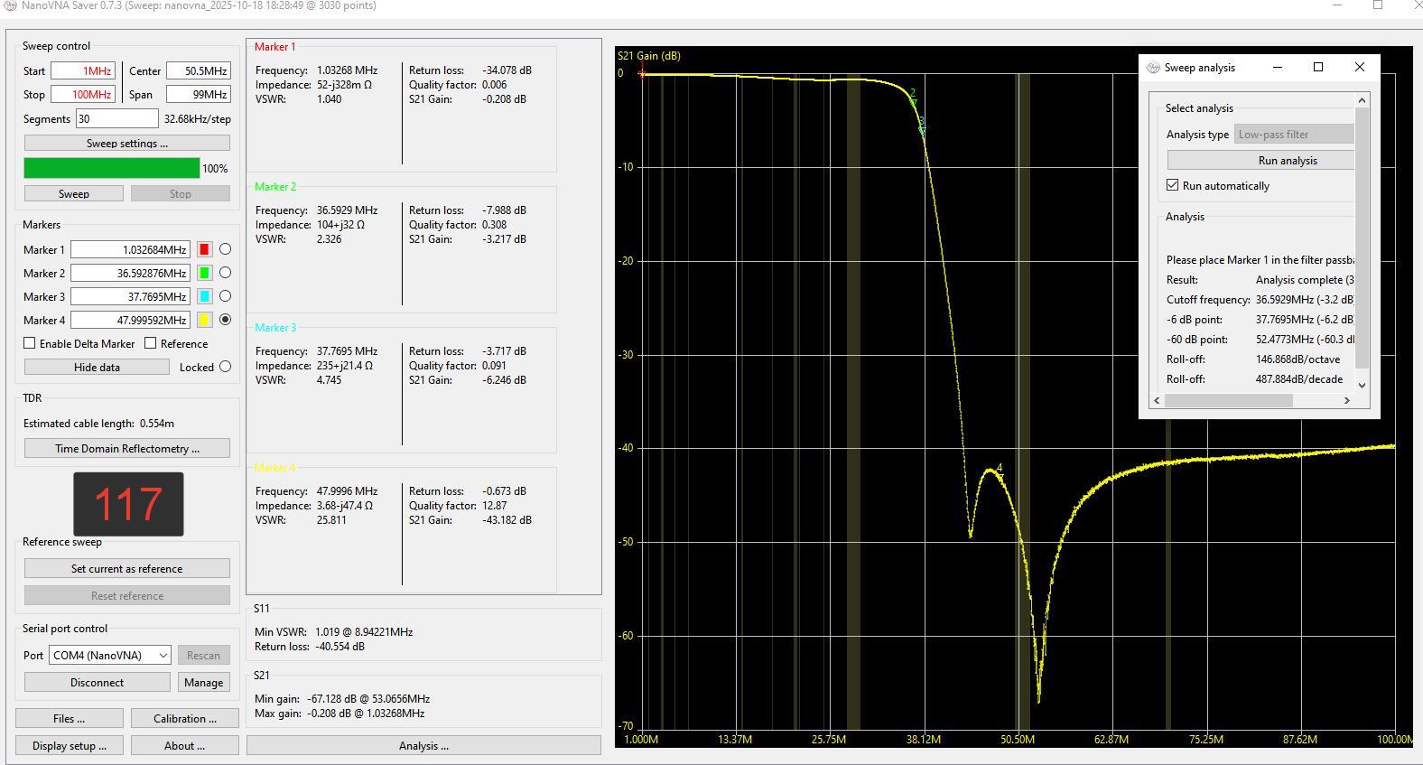
AFC/117-LPF.jpg
