Fmulder007/Karat-3.5/AFC/118-13M.jpg

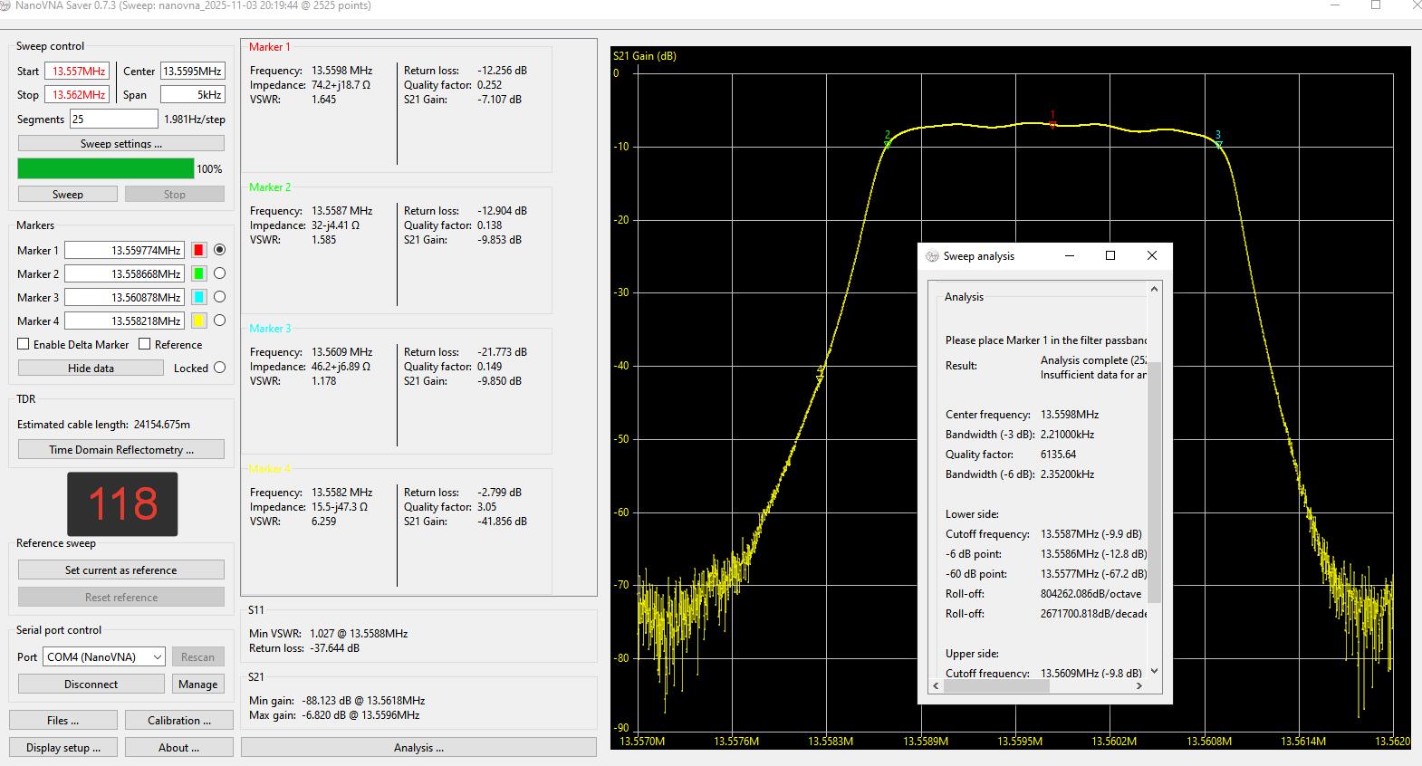
AFC/118-13M.jpg
