Fmulder007/Karat-3.5/AFC/118-48M.jpg

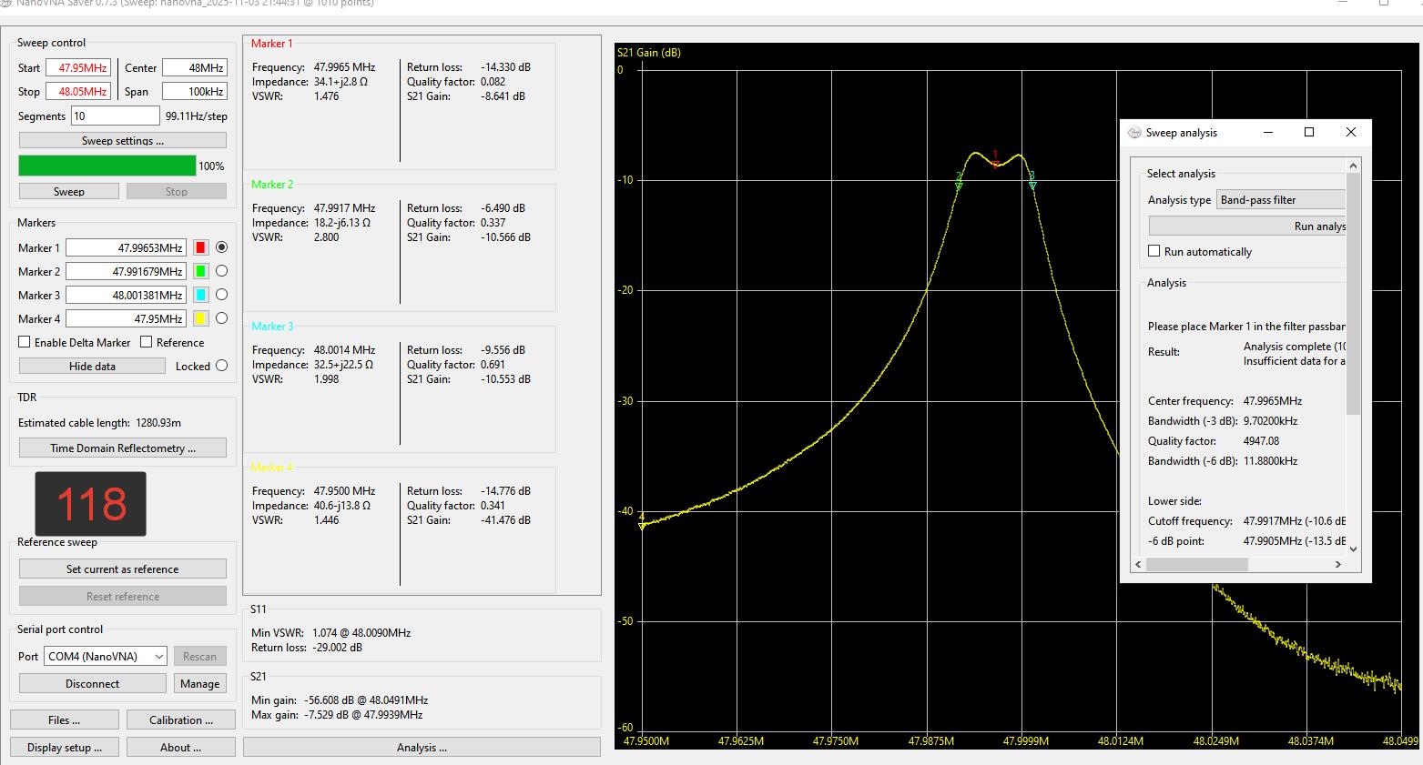
AFC/118-48M.jpg
