Fmulder007/Karat-3.5/AFC/118-LPF.jpg

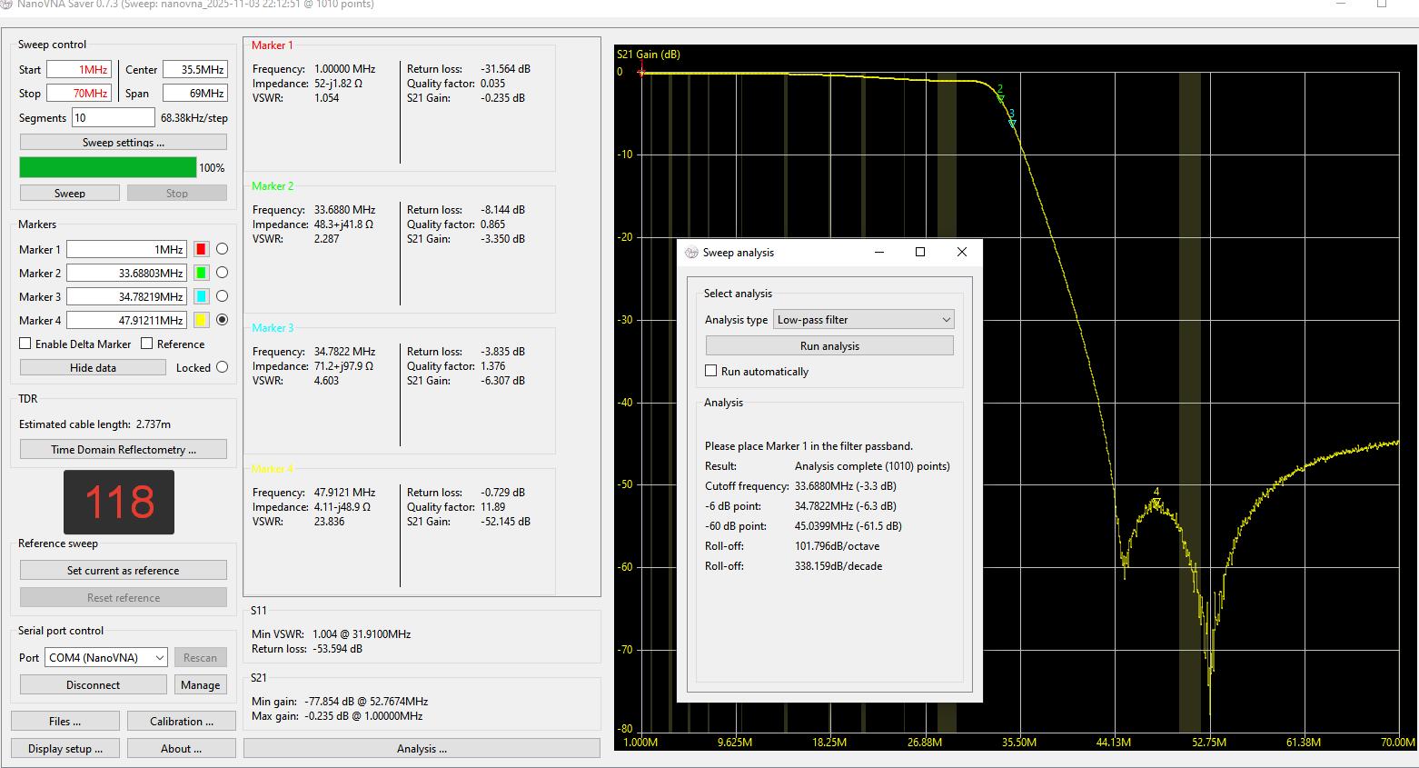
AFC/118-LPF.jpg
