Fmulder007/Karat-3.5/AFC/119-13M.jpg

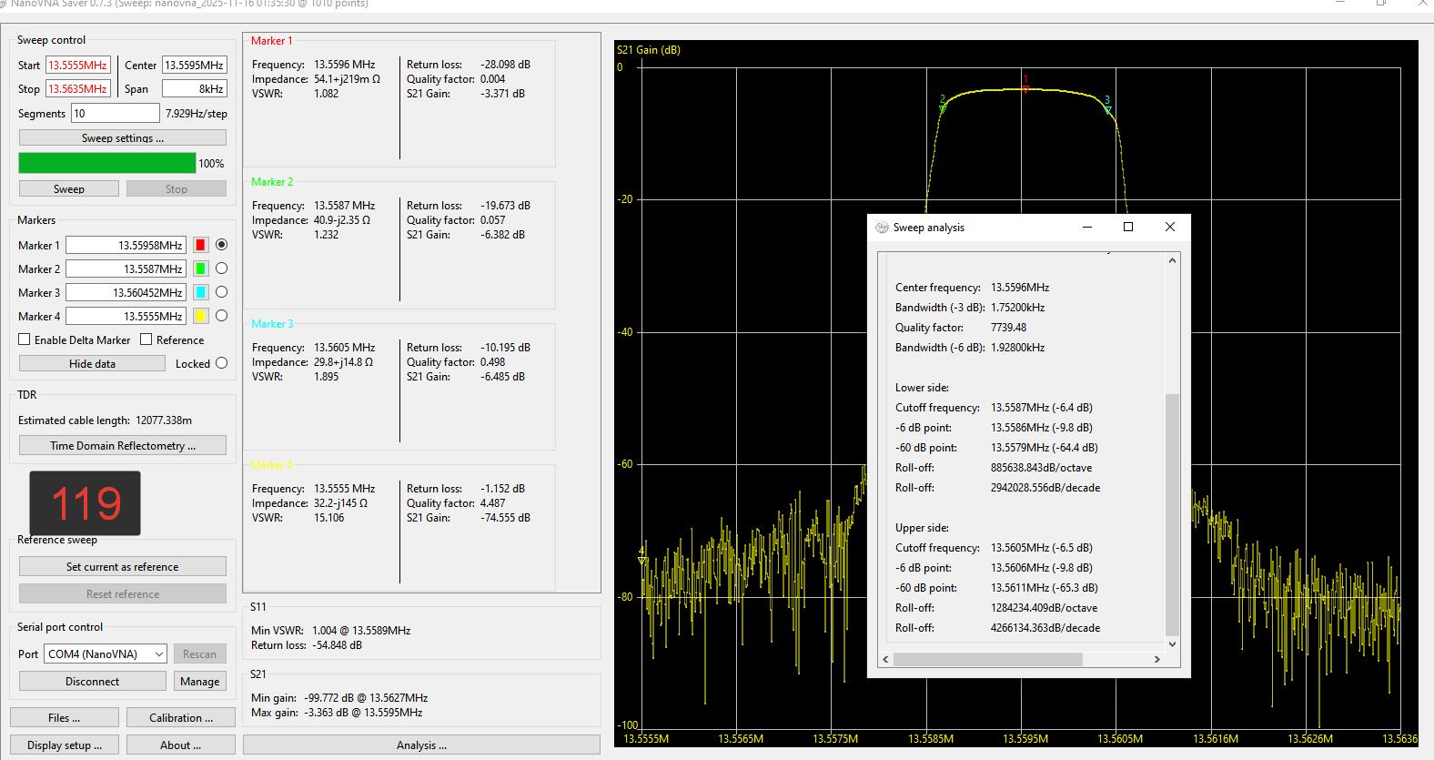
AFC/119-13M.jpg
