Fmulder007/Karat-3.5/AFC/119-LPF.jpg

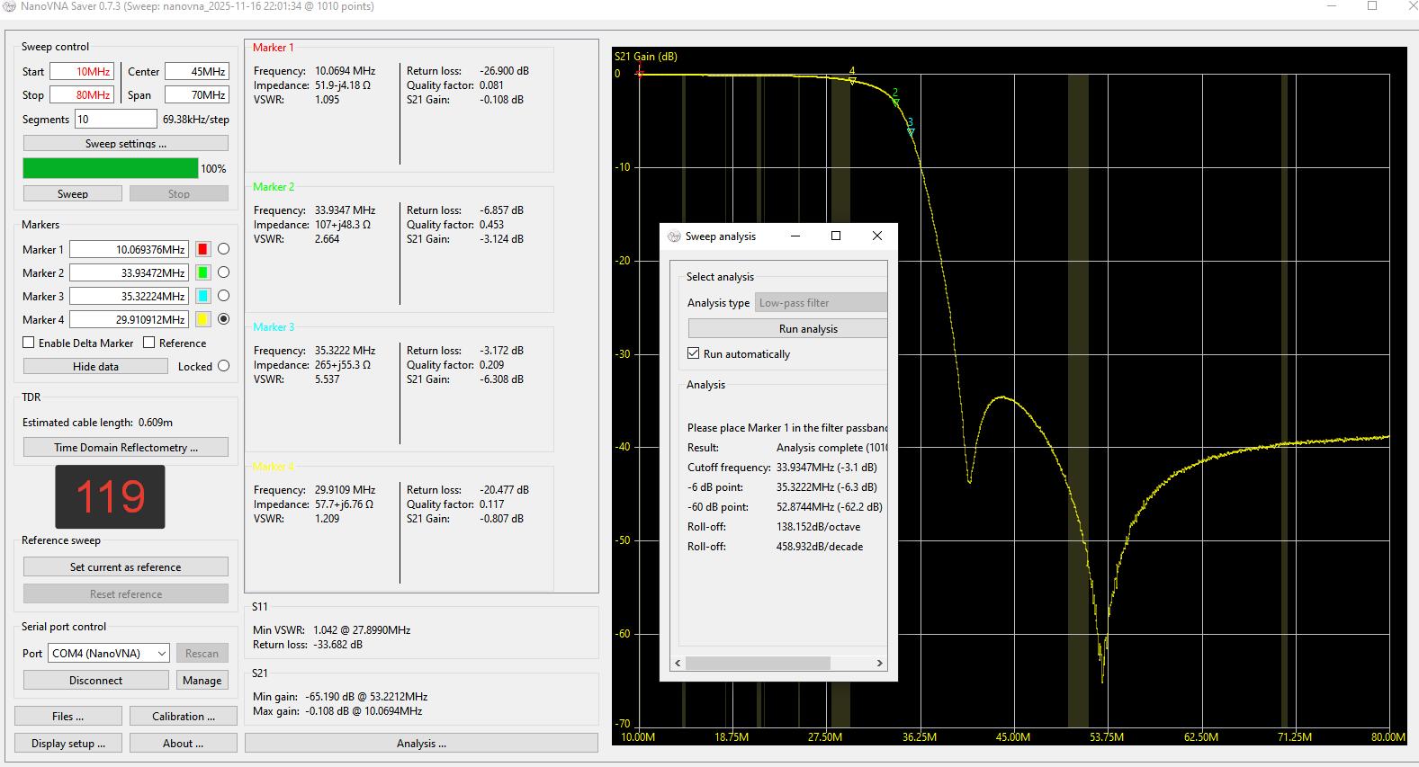
AFC/119-LPF.jpg
