Fmulder007/Karat-3.5/AFC/120-13M.jpg

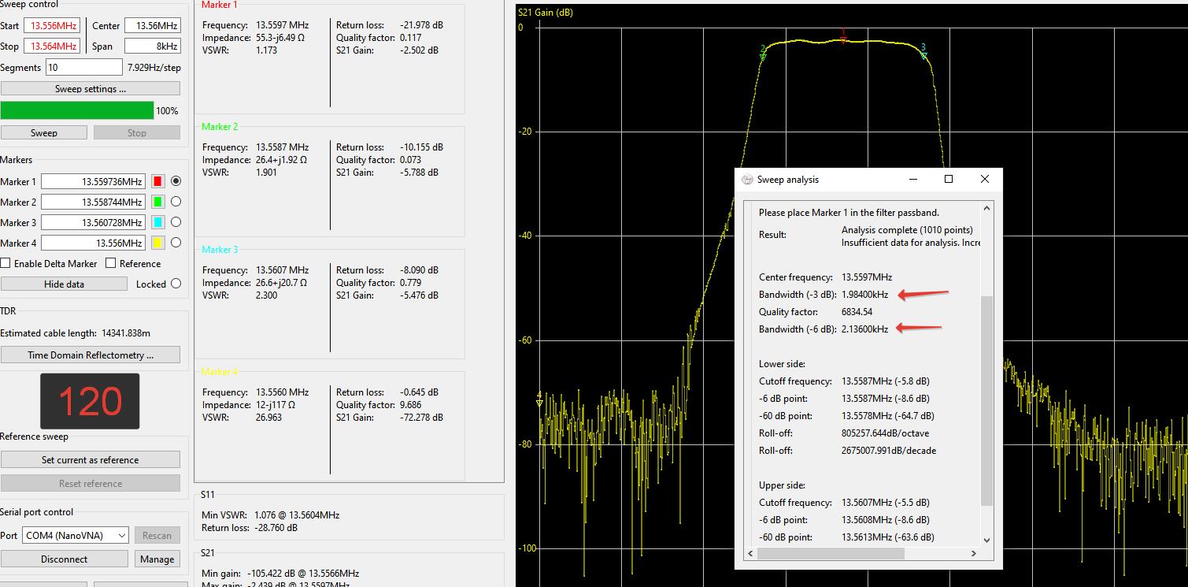
AFC/120-13M.jpg
