Fmulder007/Karat-3.5/AFC/121-LPF.jpg

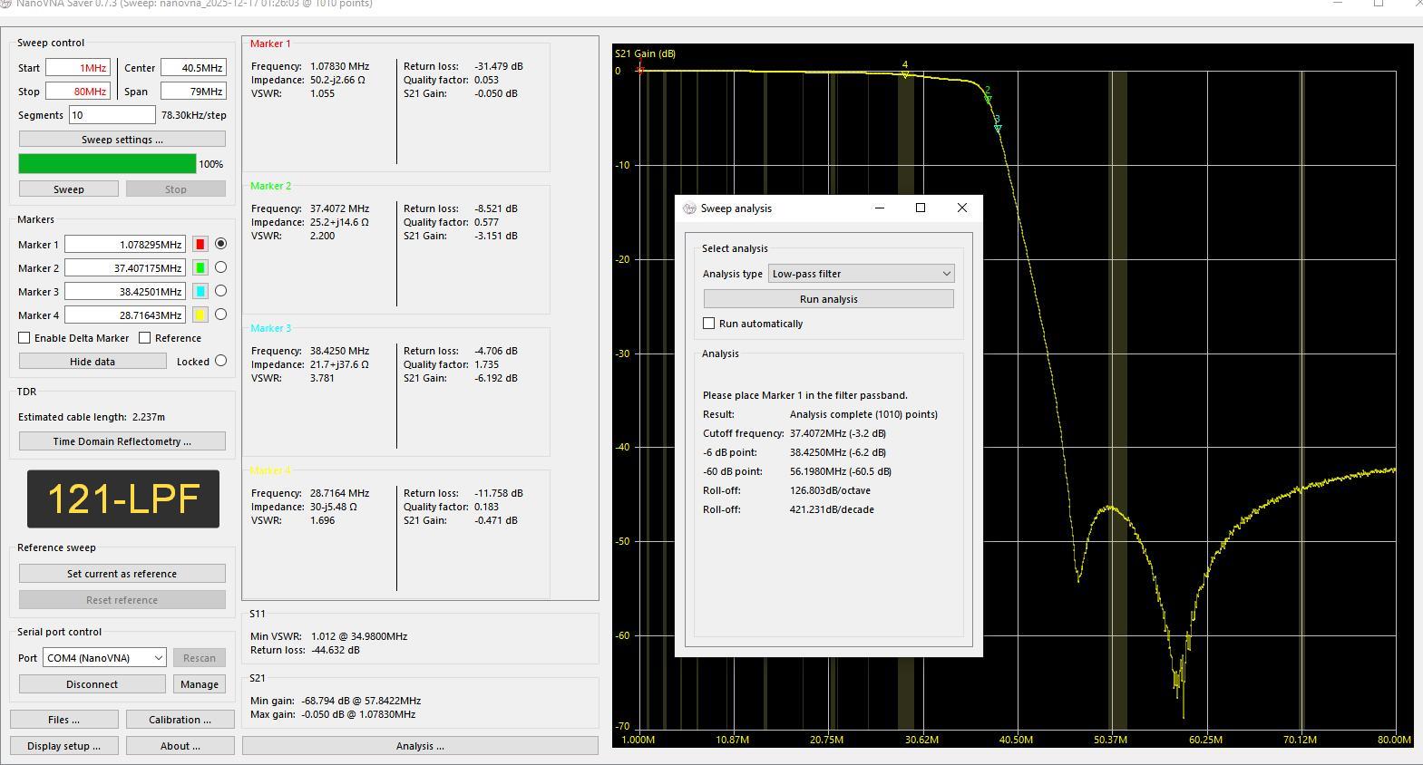
AFC/121-LPF.jpg
