Fmulder007/Karat-3.5/AFC/122-13M.jpg

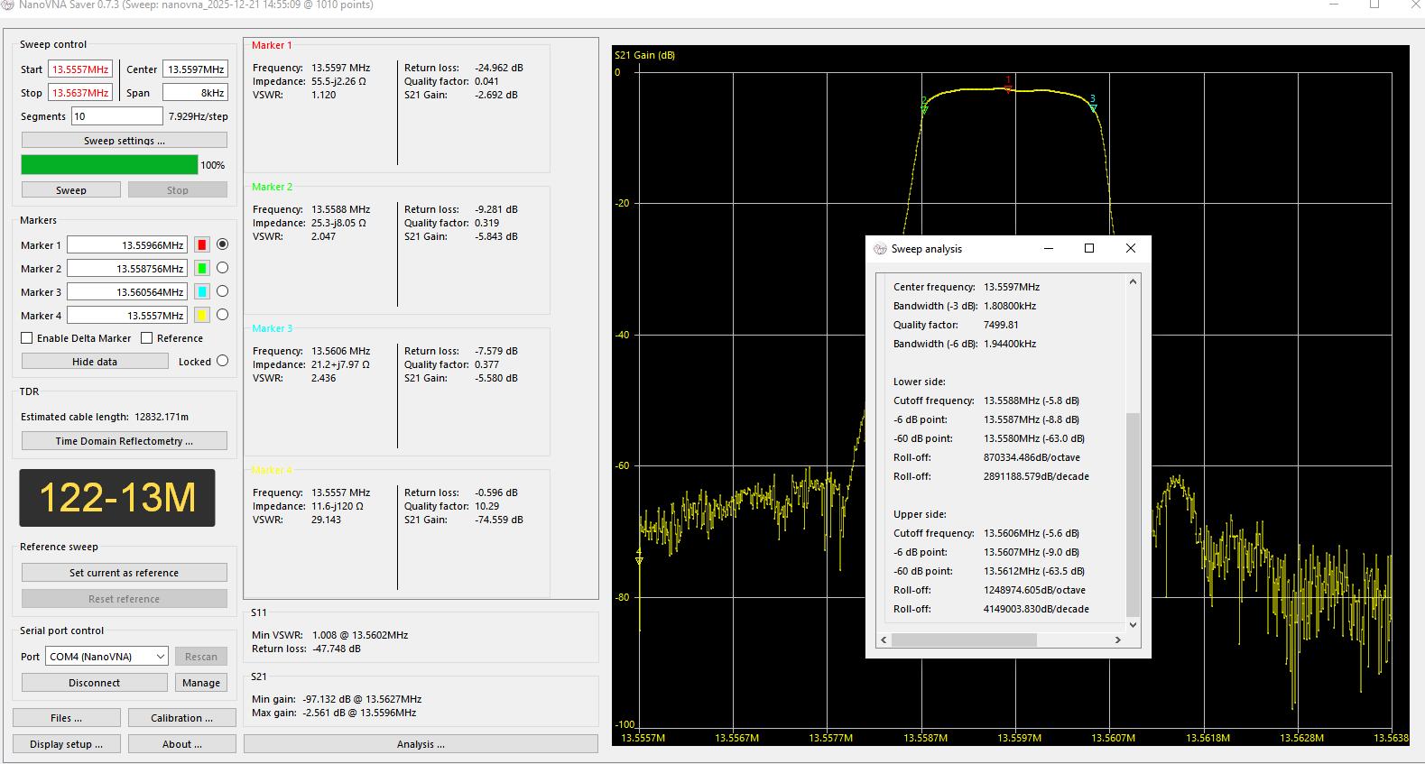
AFC/122-13M.jpg
