Fmulder007/Karat-3.5/AFC/124-48M.jpg

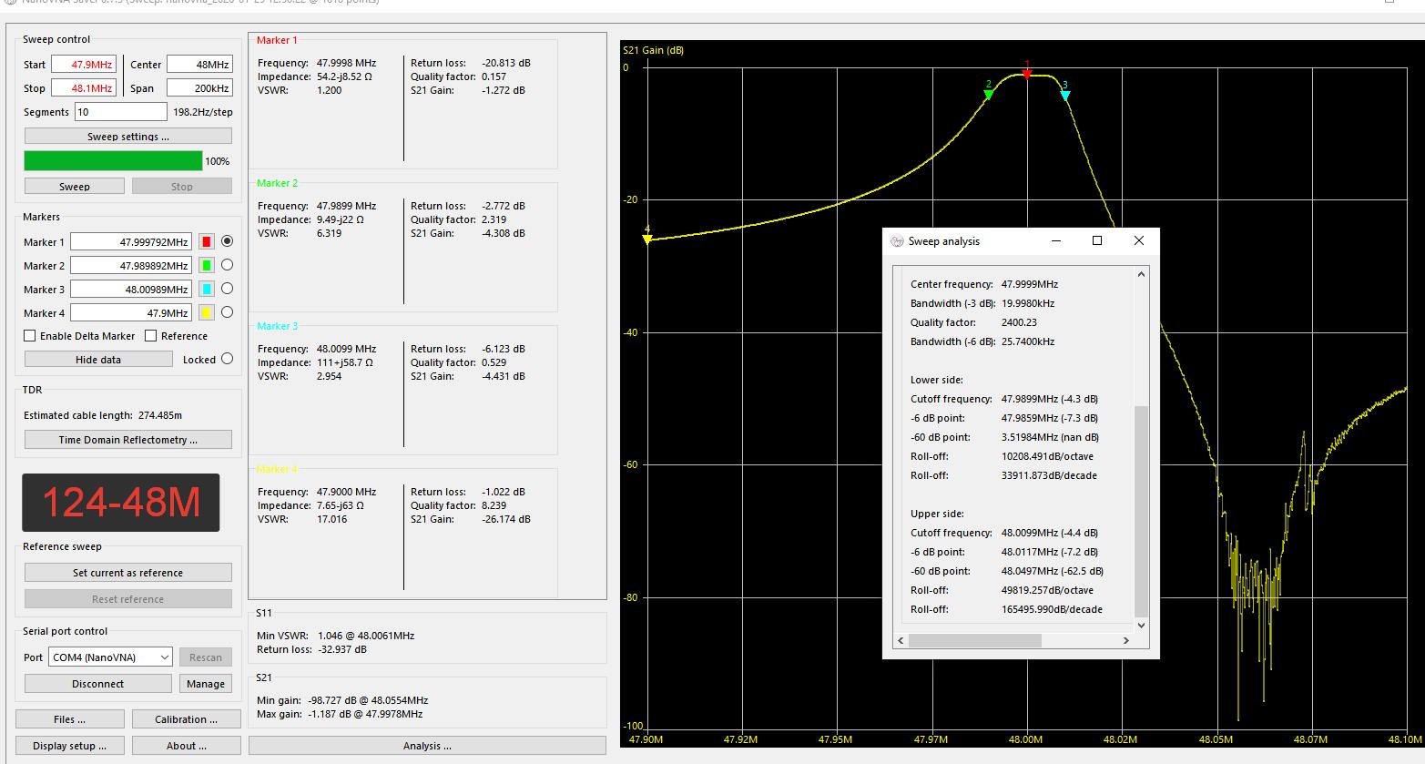
AFC/124-48M.jpg
