Fmulder007/Karat-3.5/AFC/124-LPF.jpg

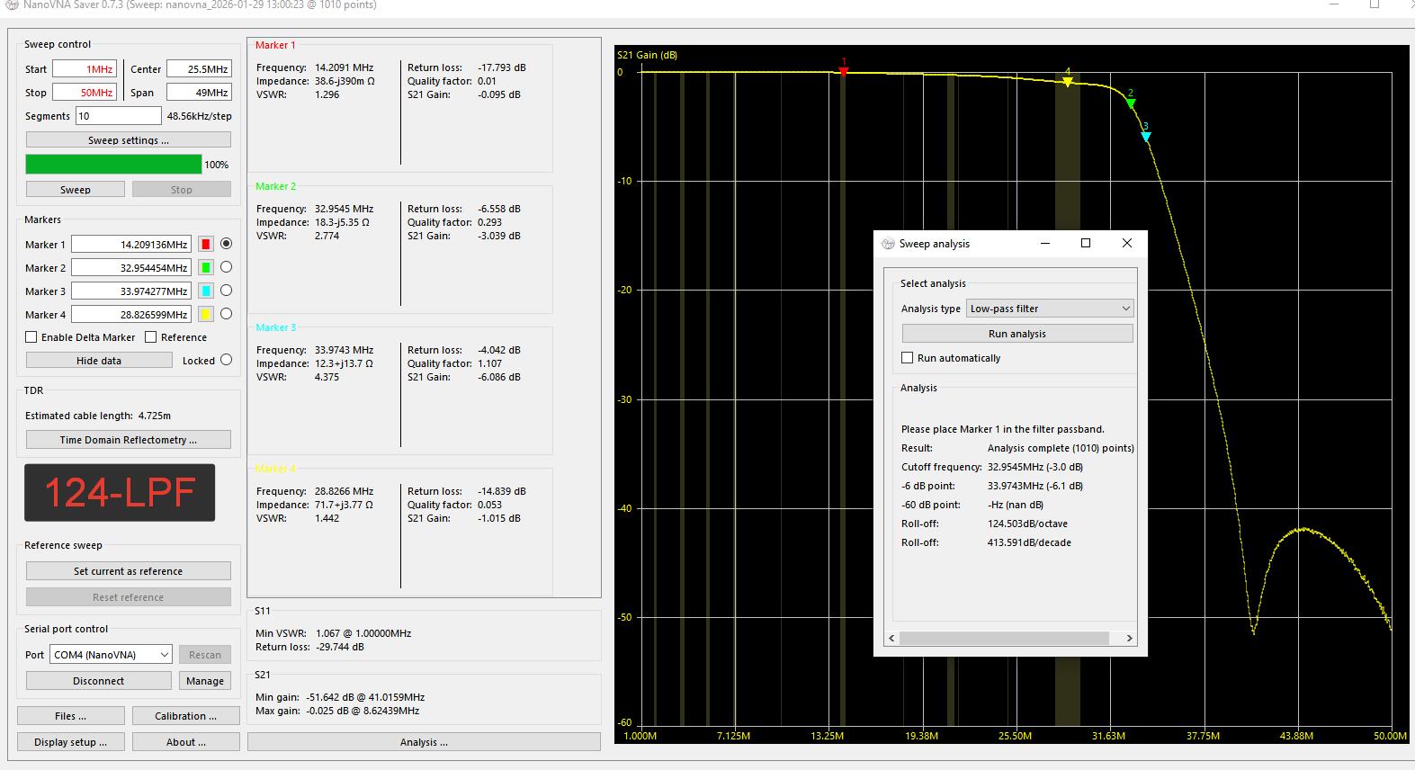
AFC/124-LPF.jpg
