Fmulder007/Karat-3.5/AFC/127-48M.jpg

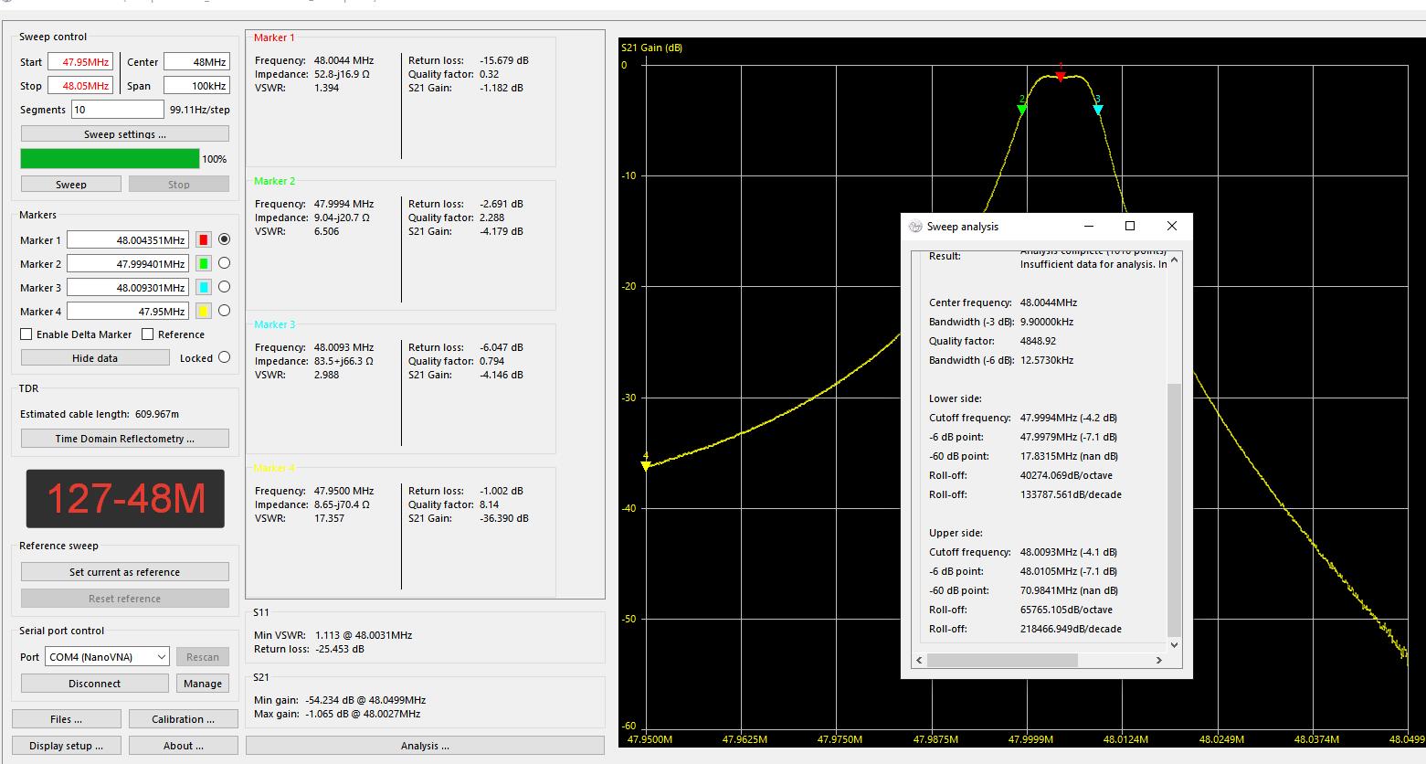
AFC/127-48M.jpg
