Fmulder007/Karat-3.5/AFC/127-LPF.jpg

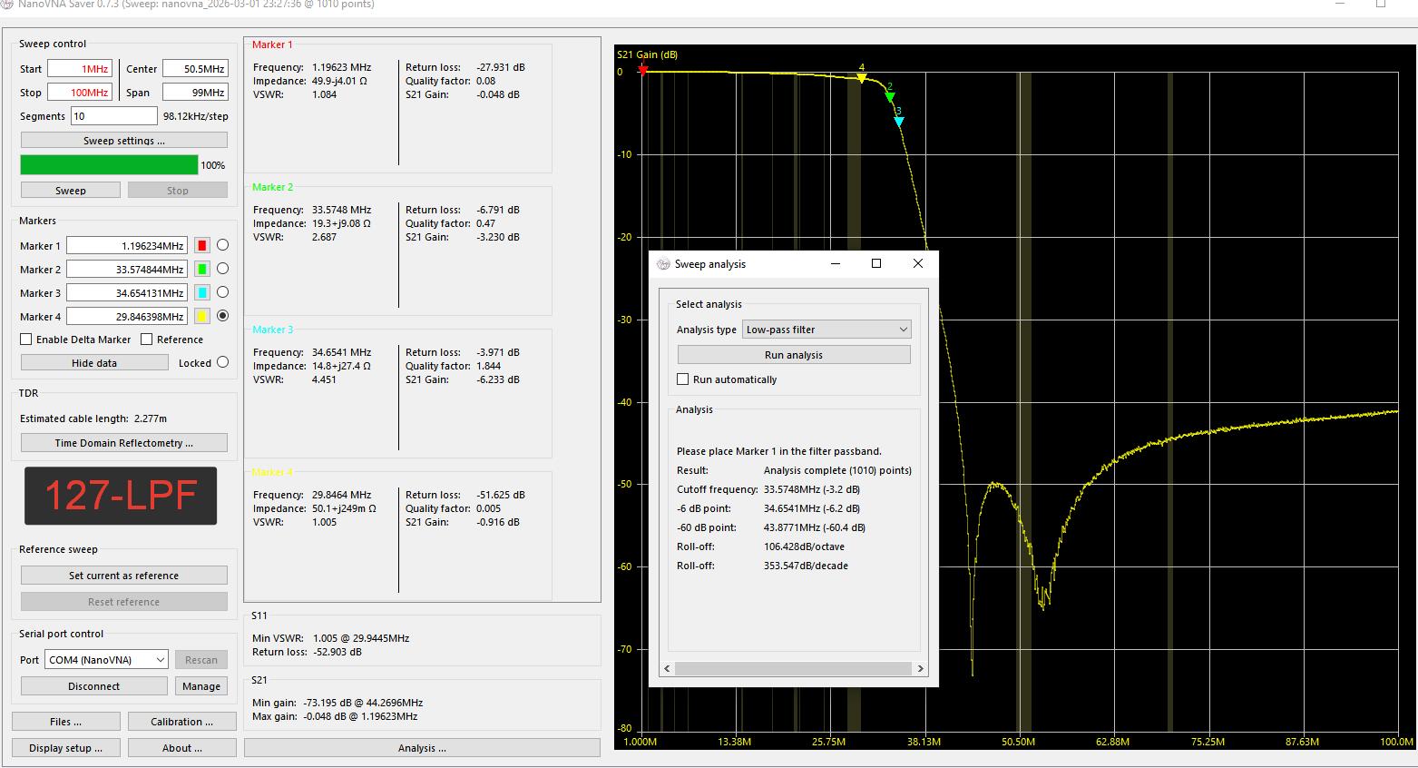
AFC/127-LPF.jpg
