Fmulder007/Karat-3.5/AFC/128-48M.jpg

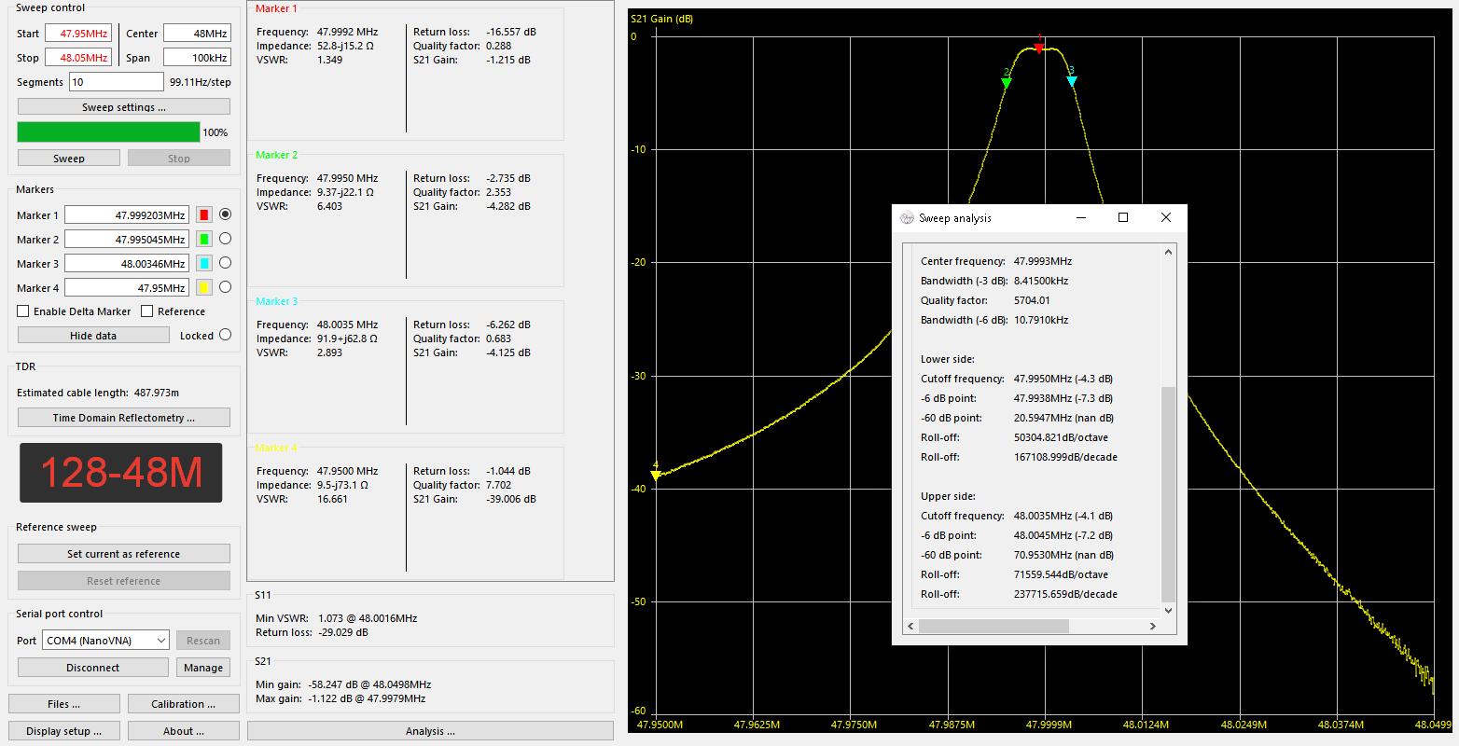
AFC/128-48M.jpg
