Fmulder007/Karat-3.5/AFC/129-LPF.jpg

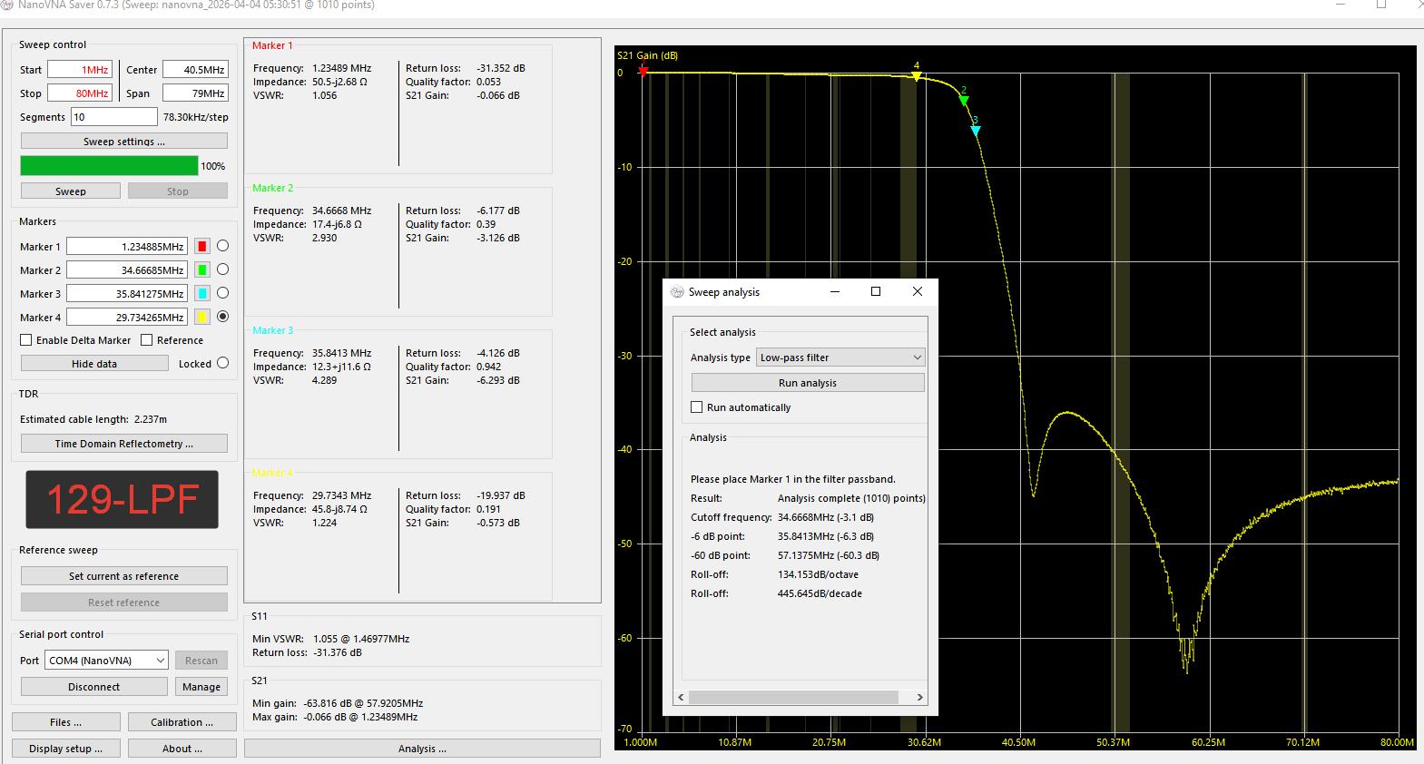
AFC/129-LPF.jpg
