Fmulder007/Karat-3.5/AFC/130-13M.jpg

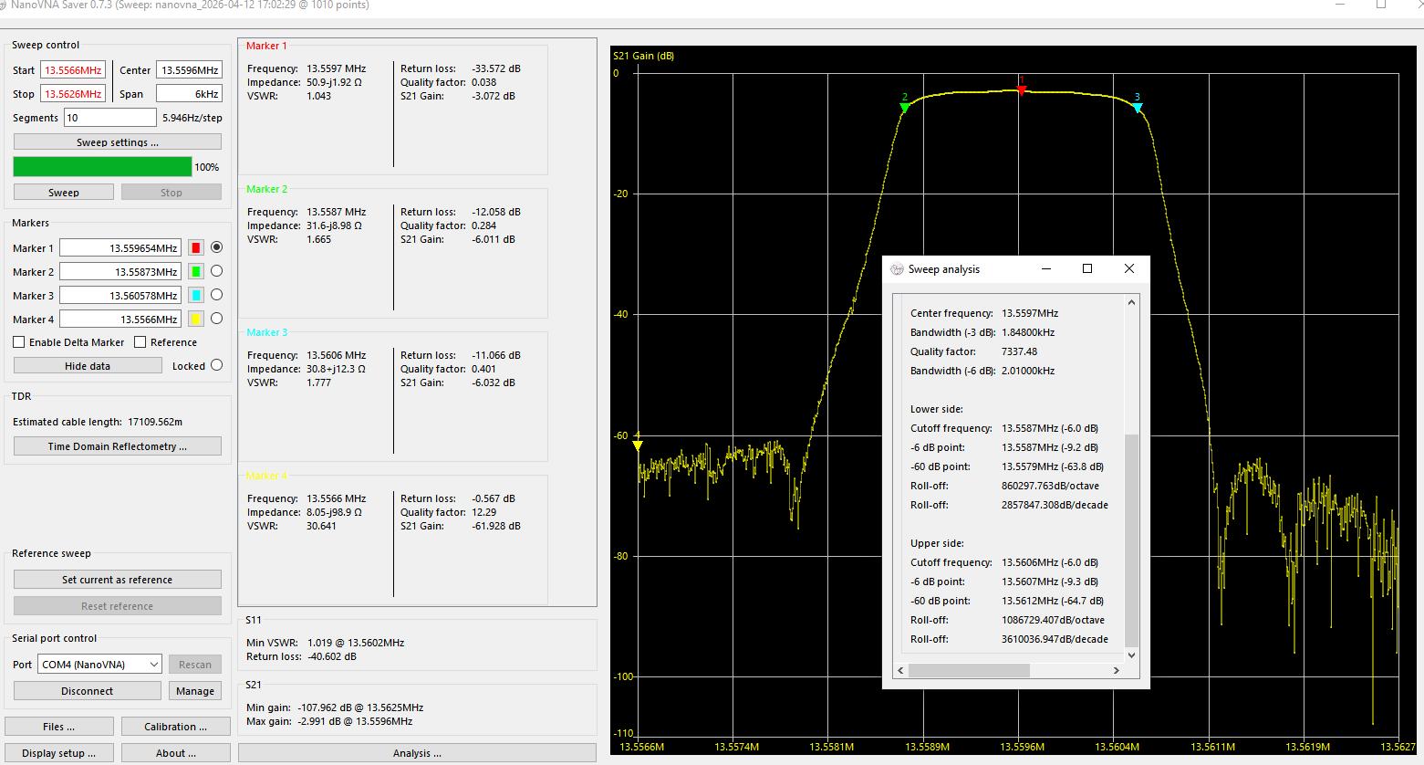
AFC/130-13M.jpg
