Fmulder007/Karat-3.5/AFC/130-LPF.jpg

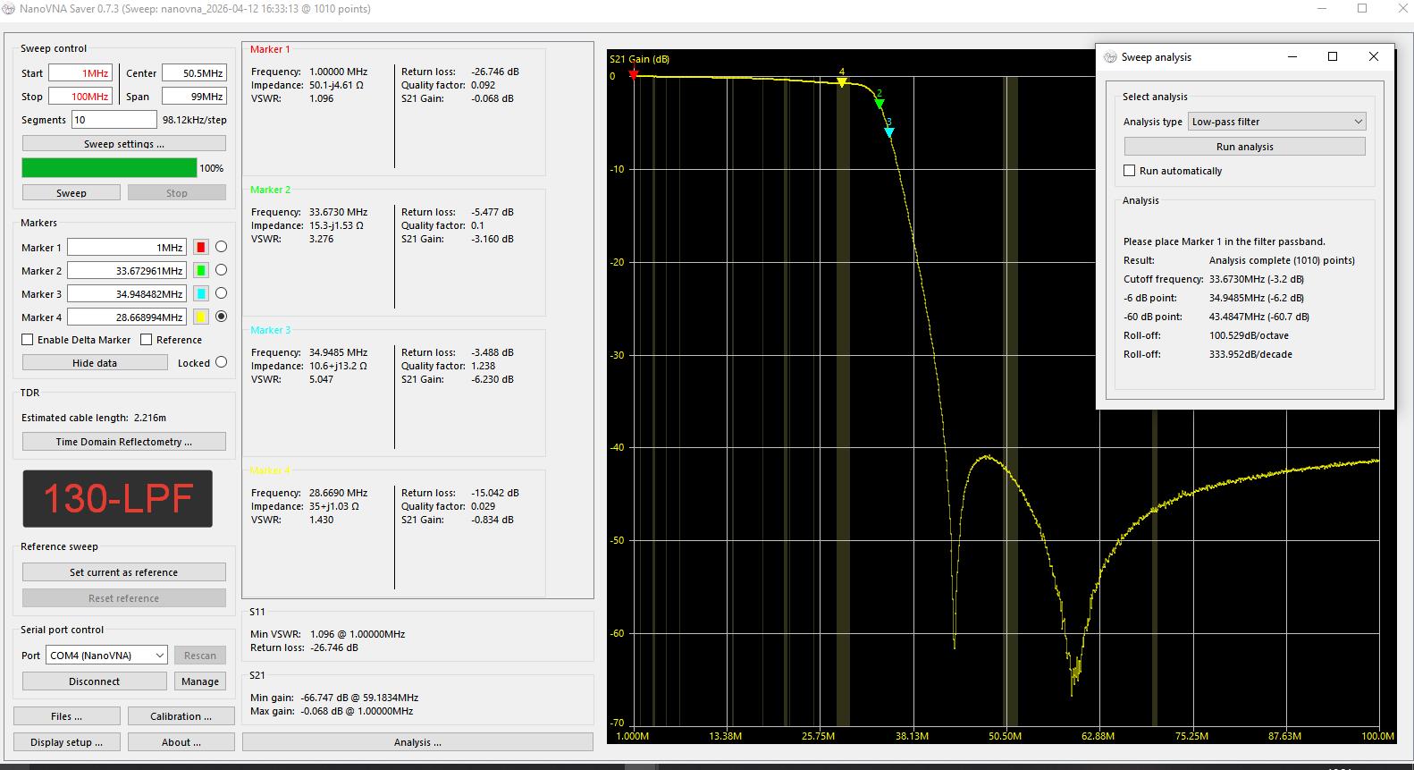
AFC/130-LPF.jpg
