Fmulder007/Karat-3.5/AFC/133-13M.jpg

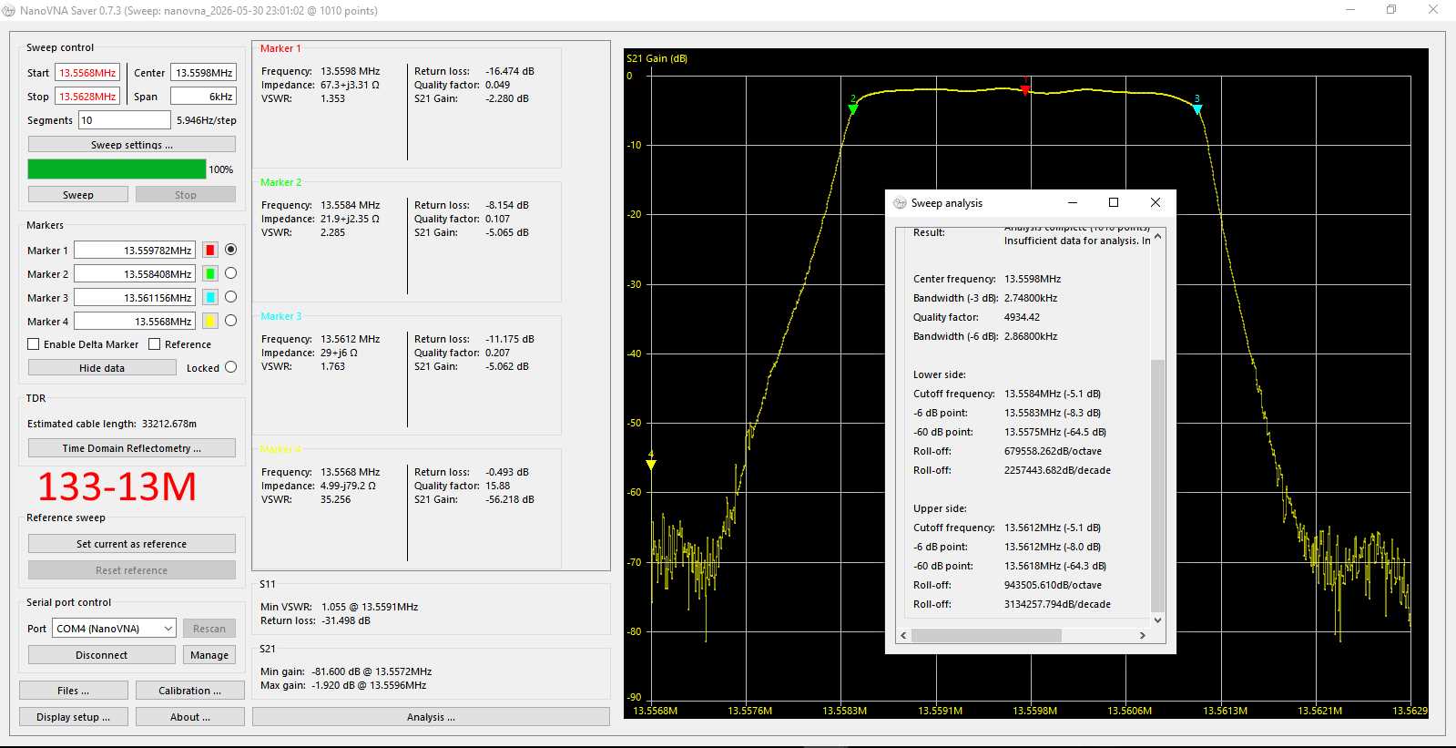
AFC/133-13M.jpg
