Fmulder007/Karat-3.5/AFC/133-LPF.jpg

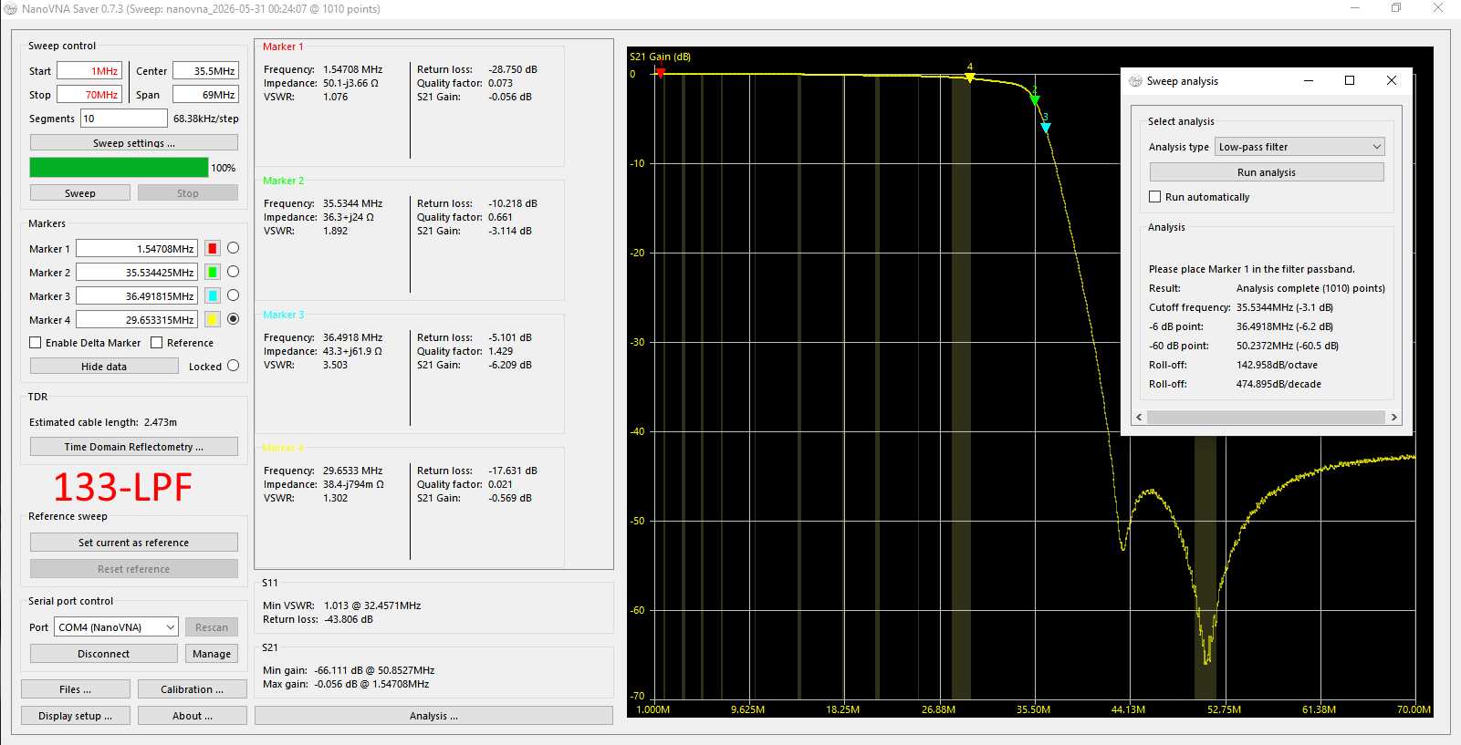
AFC/133-LPF.jpg
