Fmulder007/Karat-3.5/AFC/134-48M.jpg

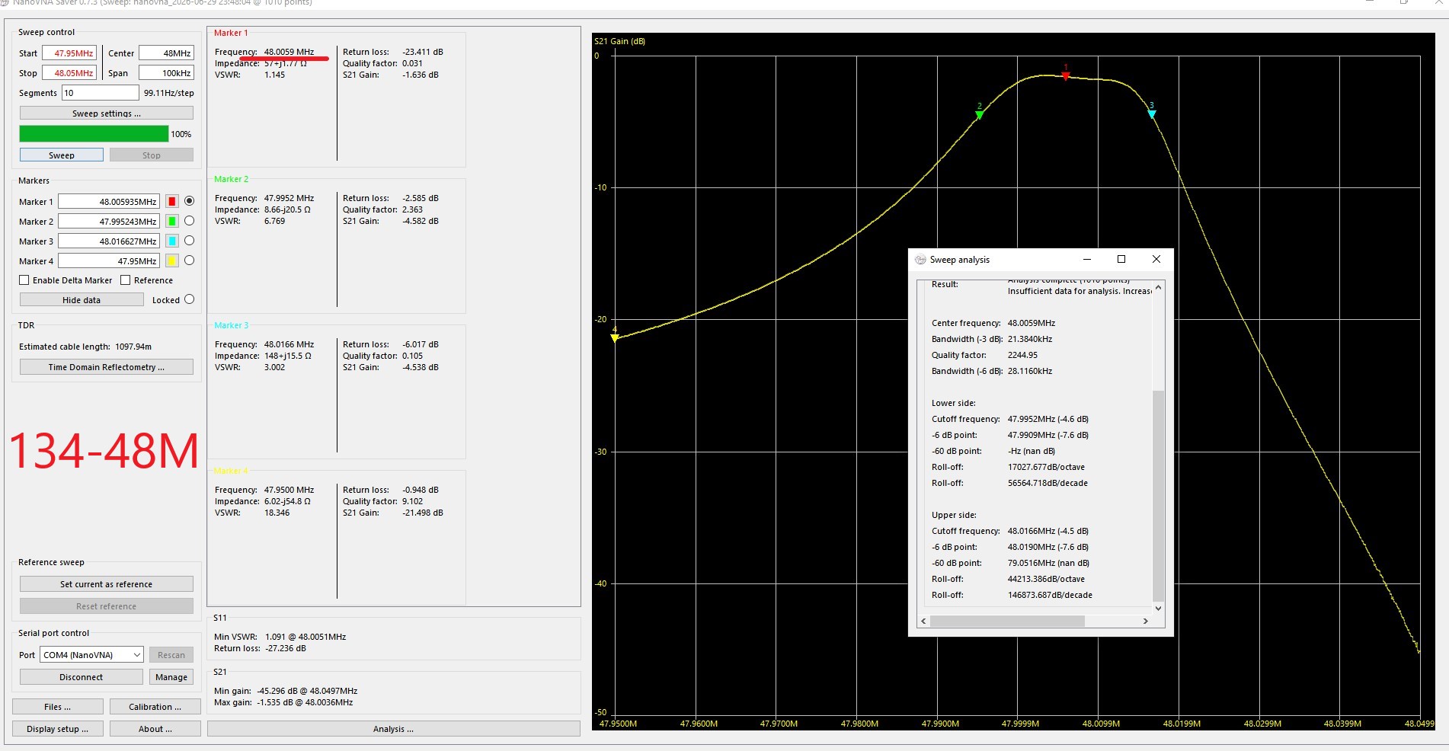
AFC/134-48M.jpg
