Fmulder007/Karat-3.5/AFC/134-LPF.jpg

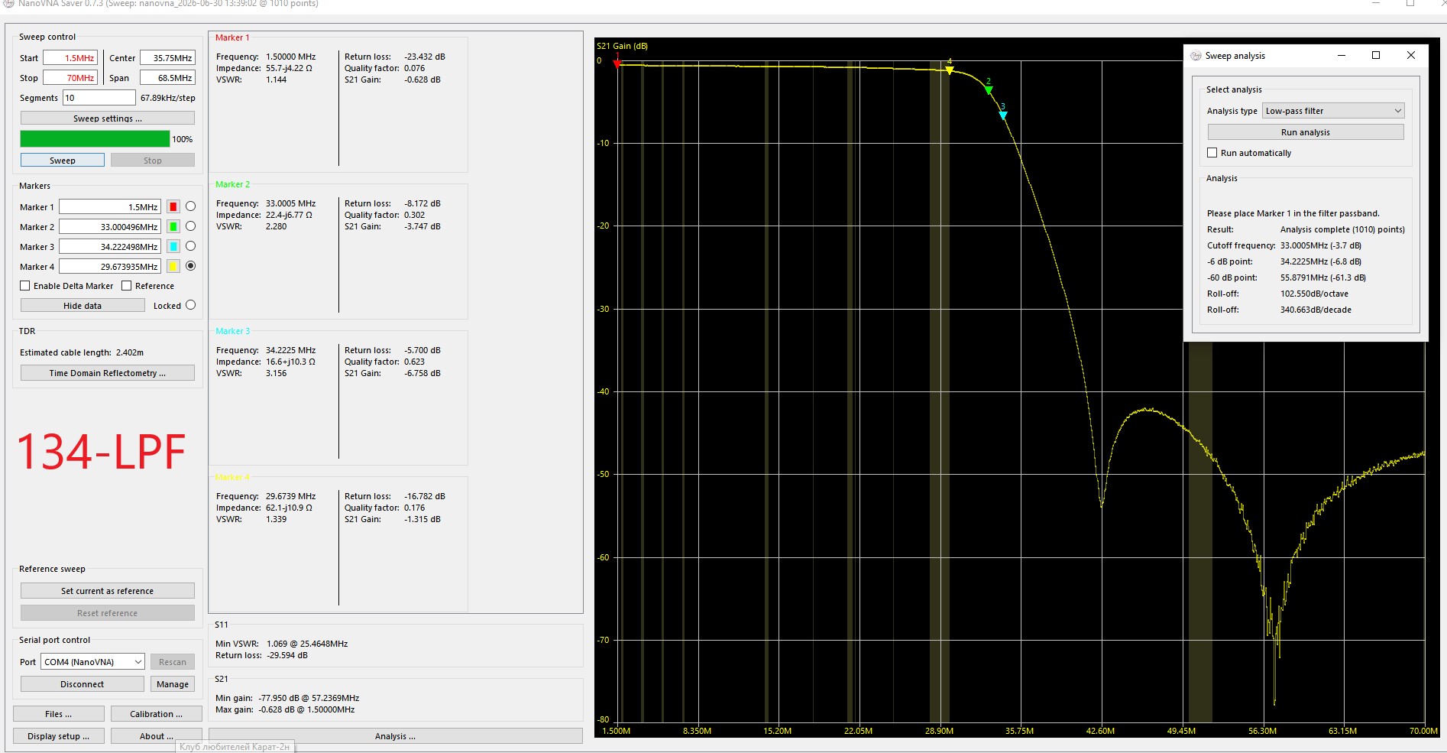
AFC/134-LPF.jpg
