Fmulder007/Karat-3.5/AFC/135-13M.jpg

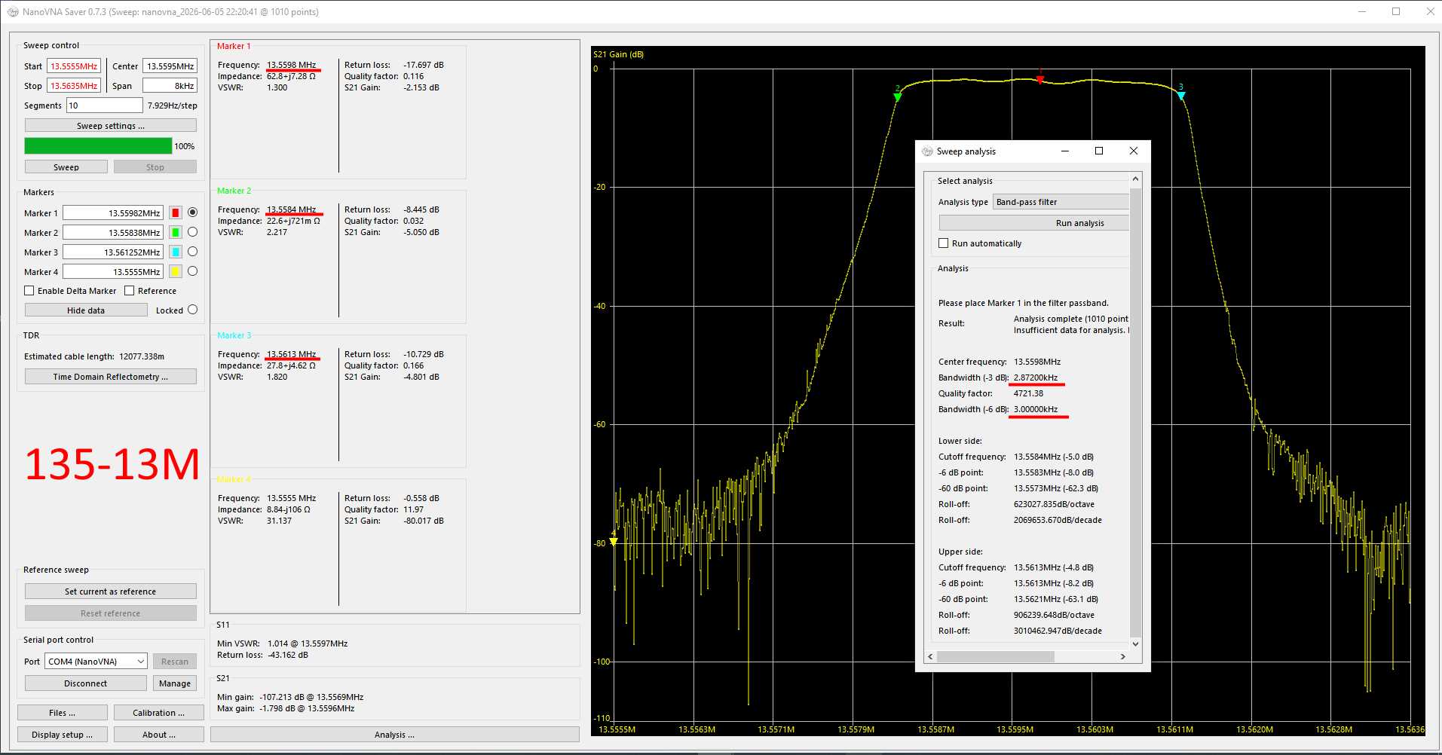
AFC/135-13M.jpg
