Fmulder007/Karat-3.5/AFC/135-48M.jpg

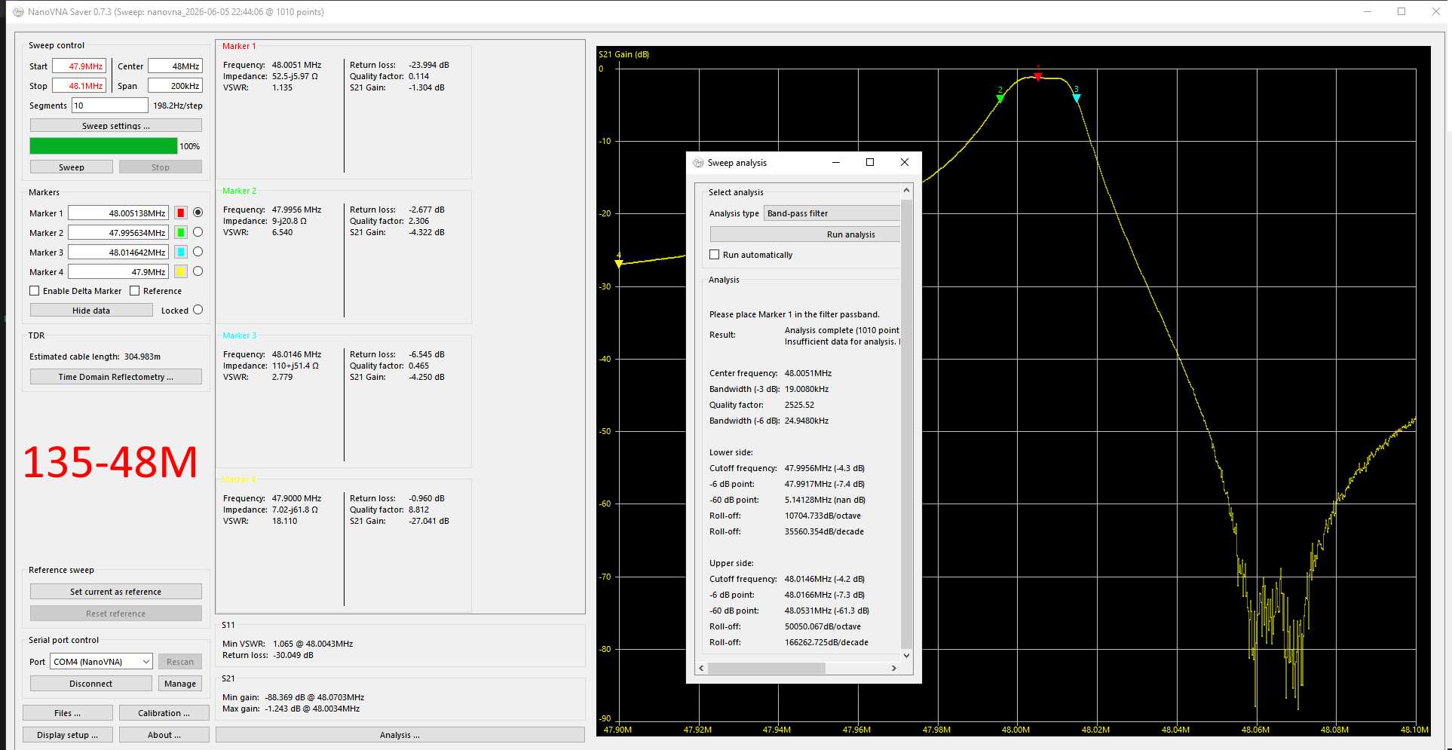
AFC/135-48M.jpg
