Fmulder007/Karat-3.5/AFC/135-LPF.jpg

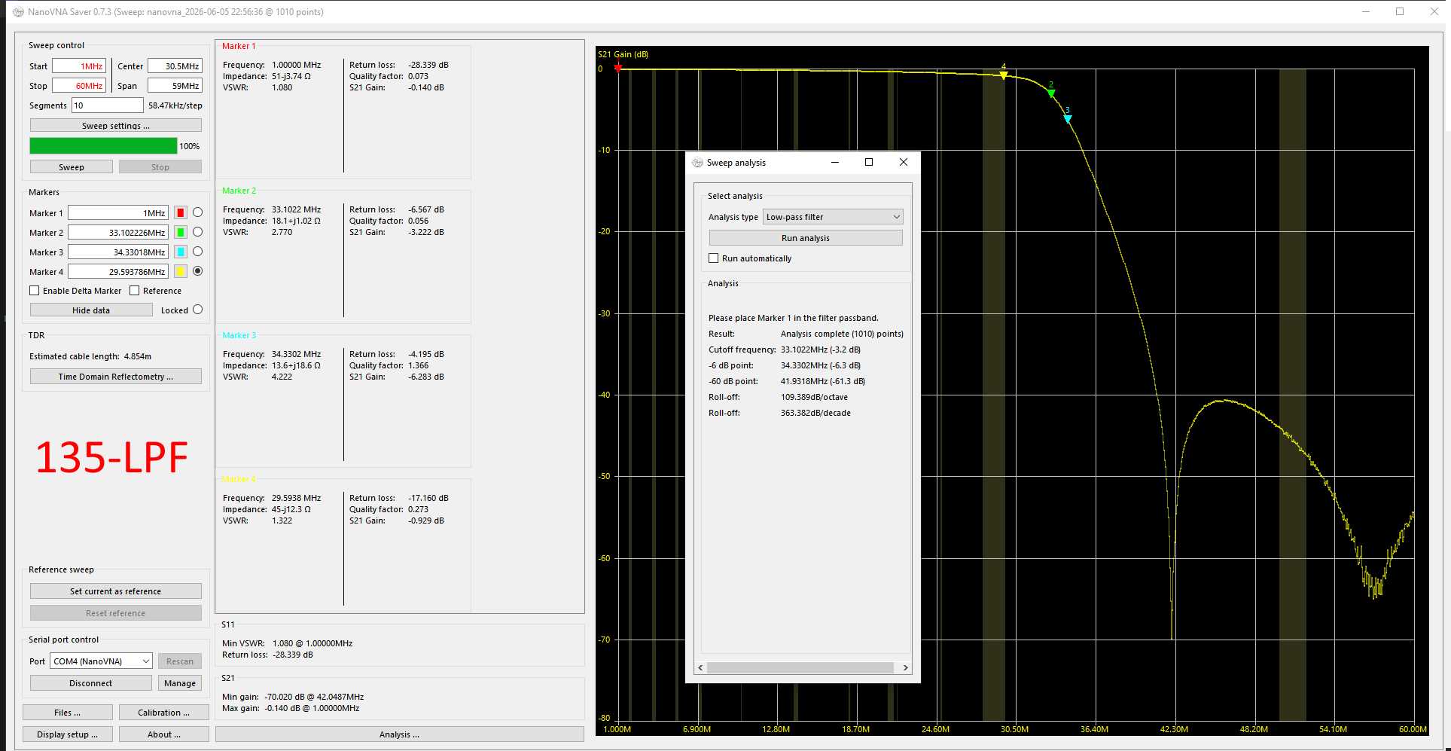
AFC/135-LPF.jpg
