Fmulder007/Karat-3.5/AFC/136-48M.JPG

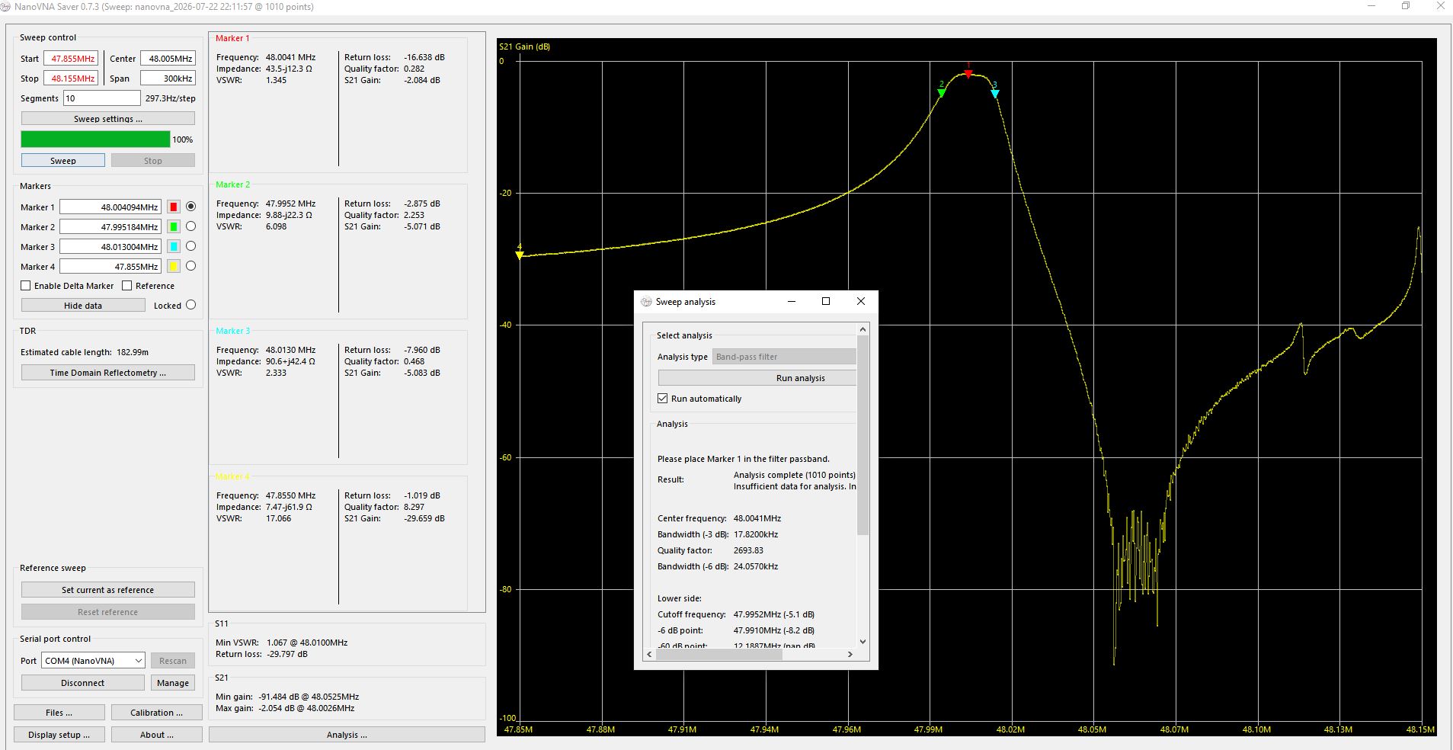
AFC/136-48M.JPG
