Fmulder007/Karat-3.5/AFC/136-LPF.JPG

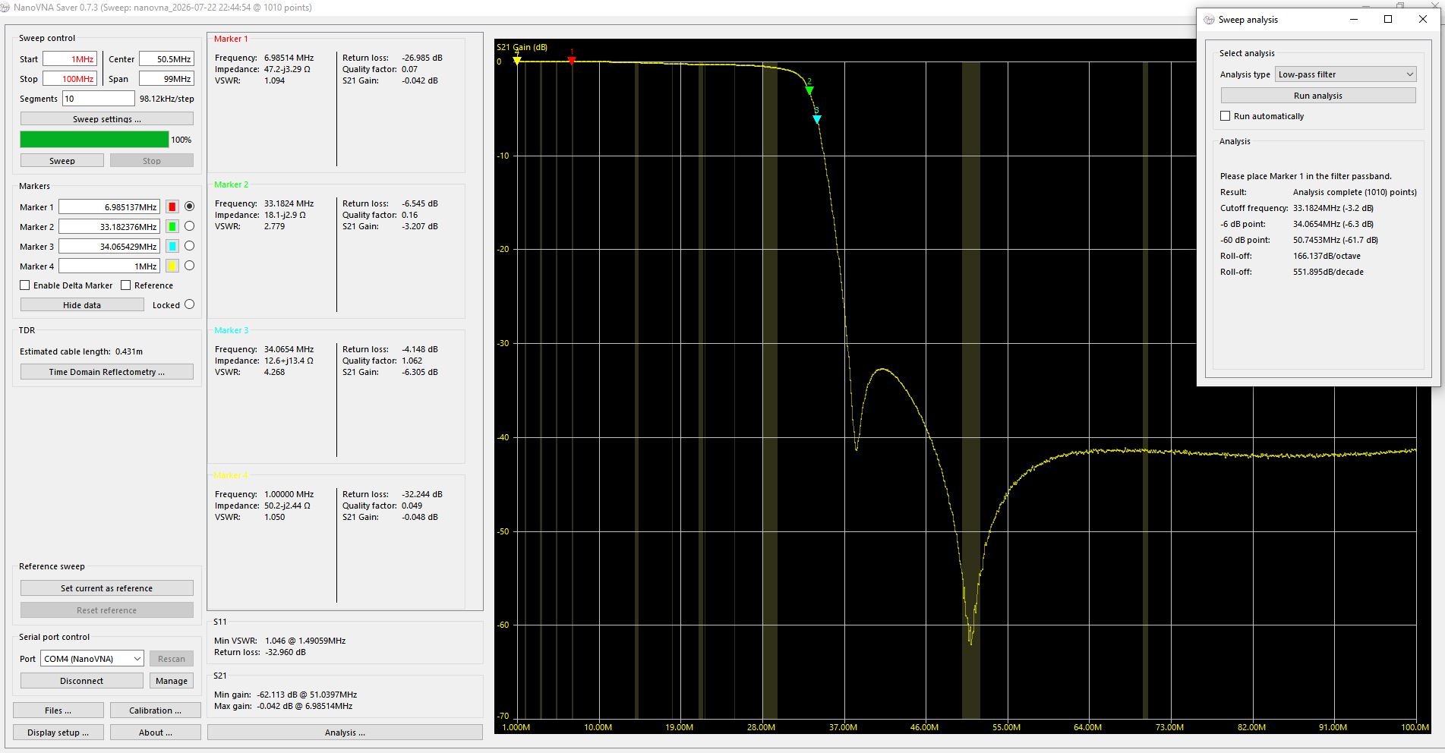
AFC/136-LPF.JPG
