Fmulder007/Karat-3.5/AFC/137-13M.jpg

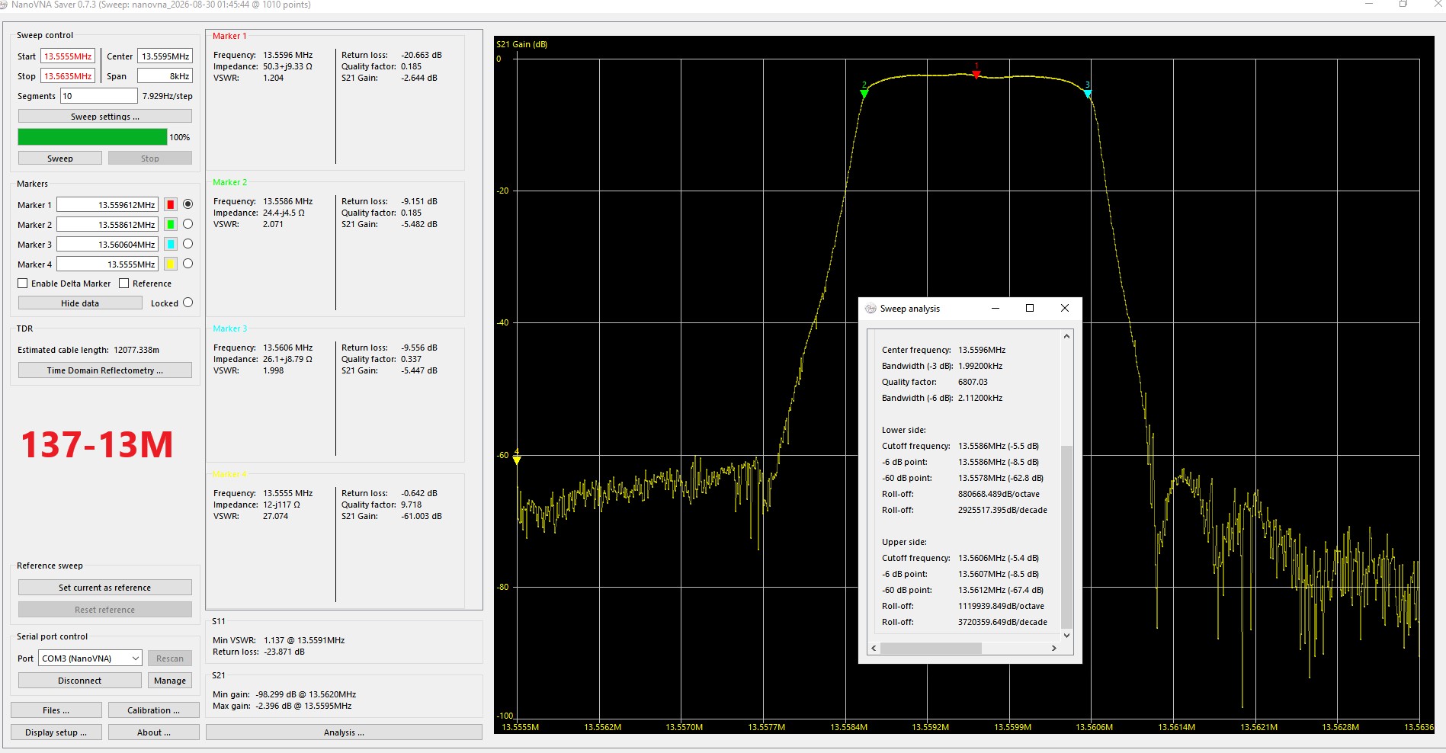
AFC/137-13M.jpg
