Fmulder007/Karat-3.5/AFC/137-LPF.jpg

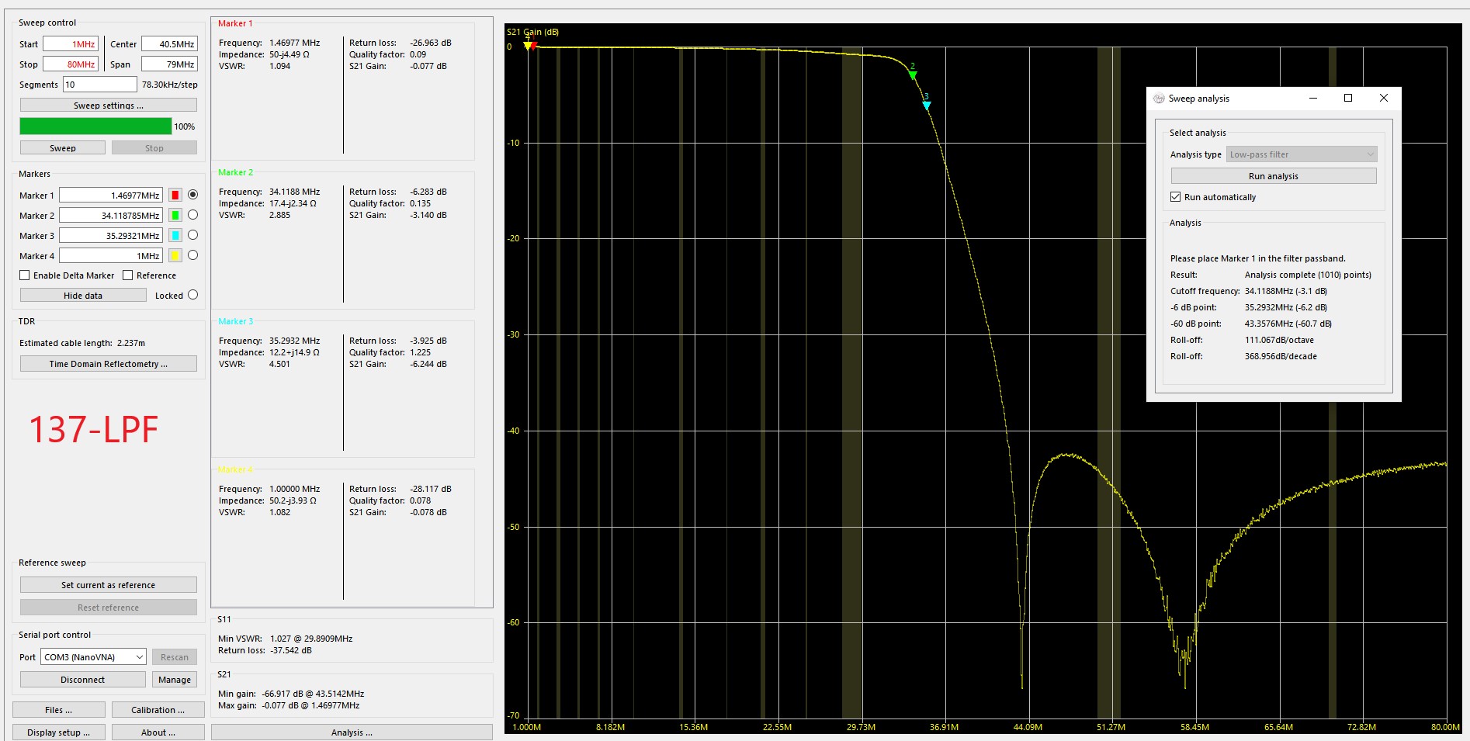
AFC/137-LPF.jpg
