Fmulder007/Karat-3.5/AFC/763-13M.jpg

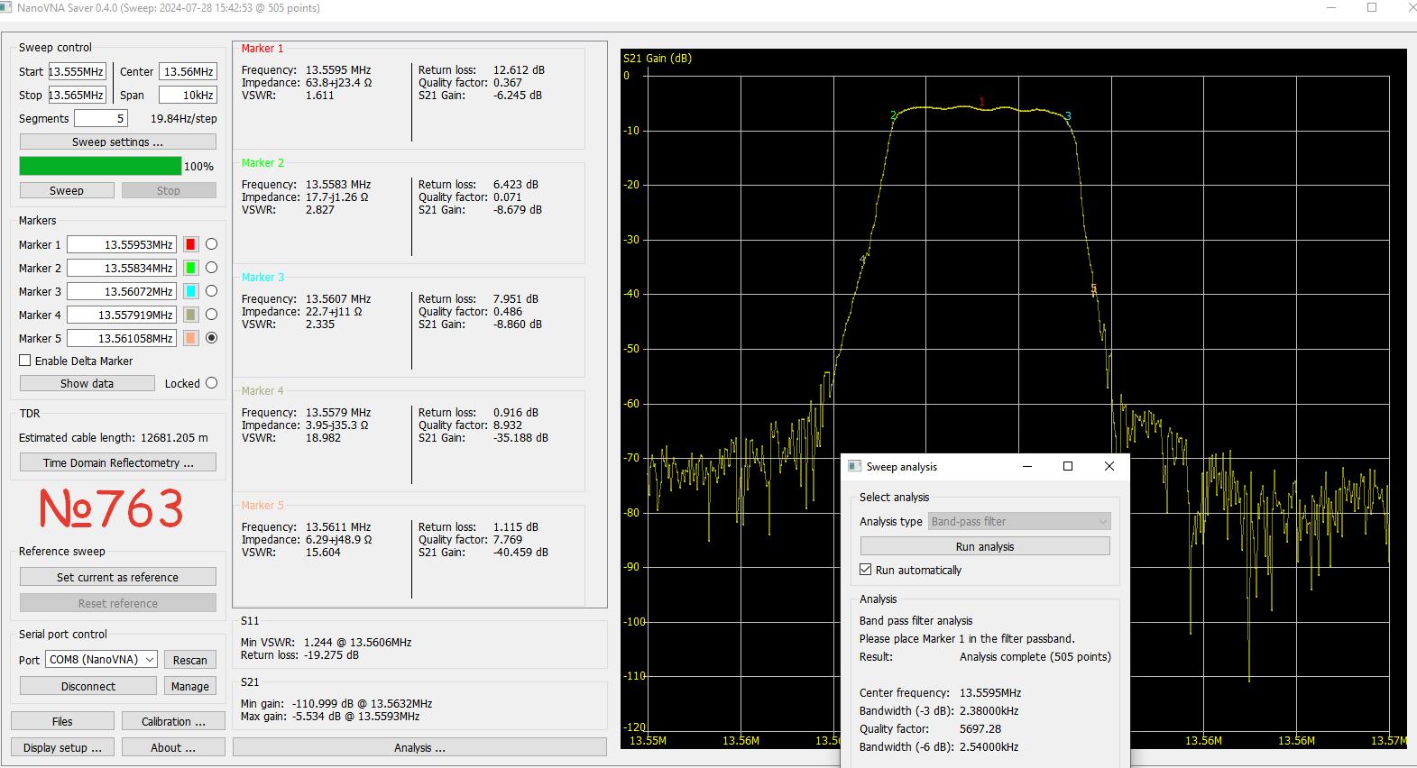
AFC/763-13M.jpg
