Fmulder007/Karat-3.5/AFC/778-48M.jpg

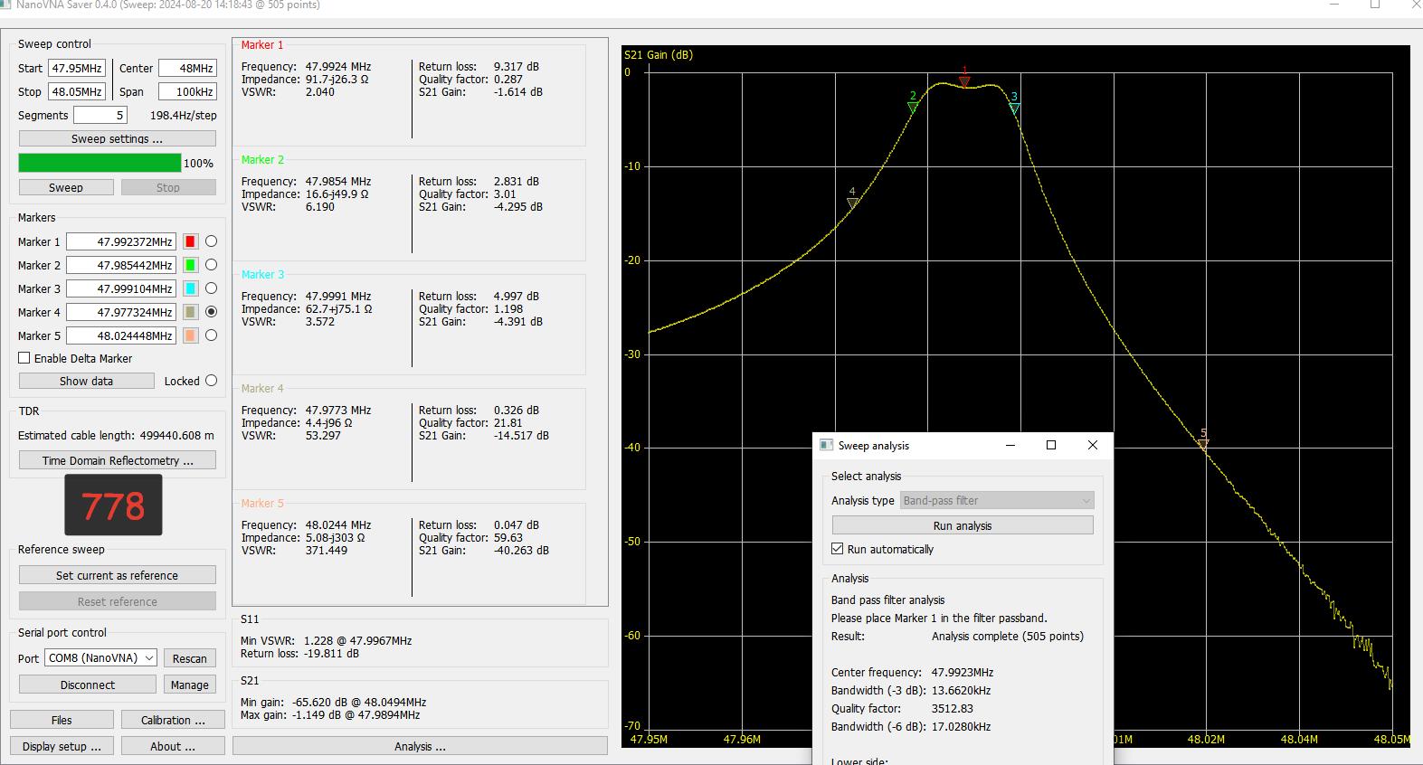
AFC/778-48M.jpg
