Fmulder007/Karat-3.5/AFC/778-LPF.jpg

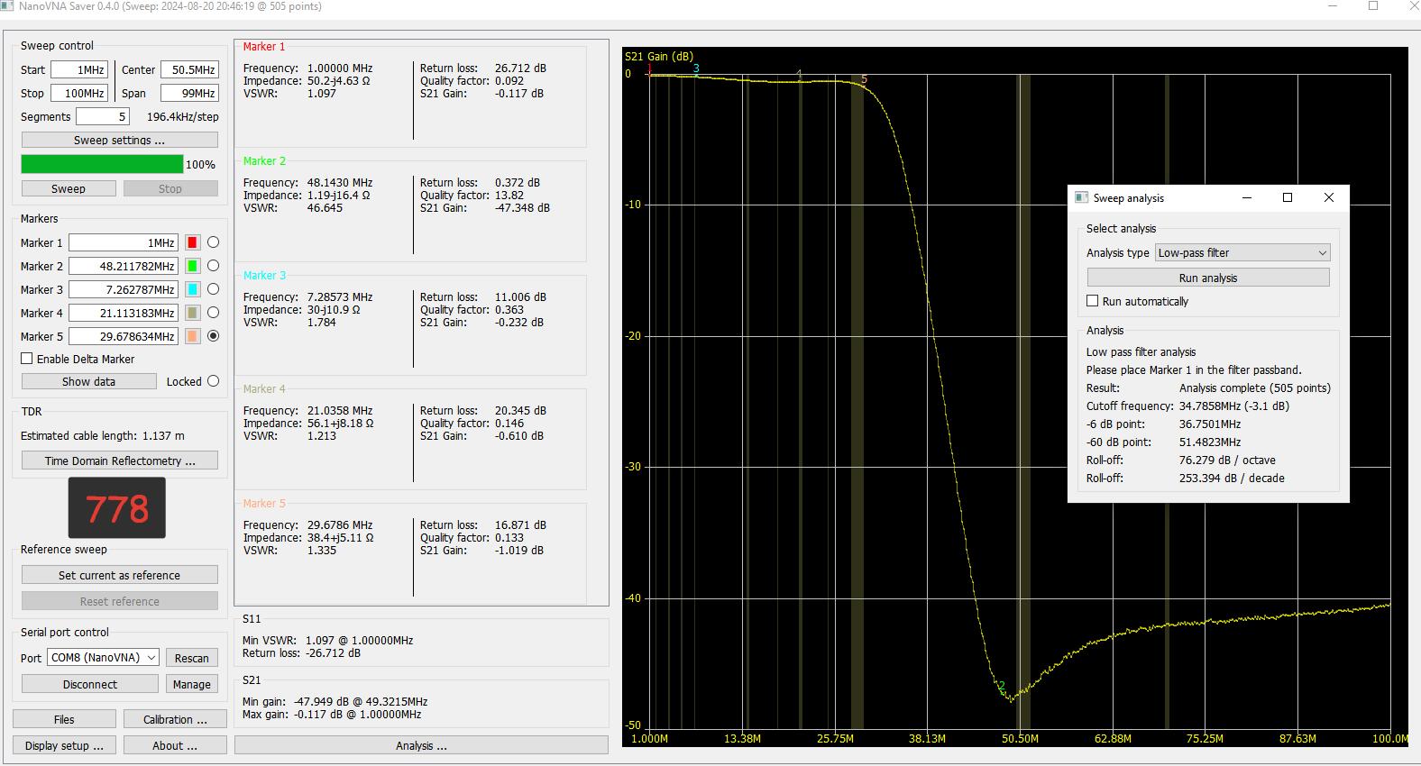
AFC/778-LPF.jpg
