Fmulder007/Karat-3.5/AFC/782-13M.jpg

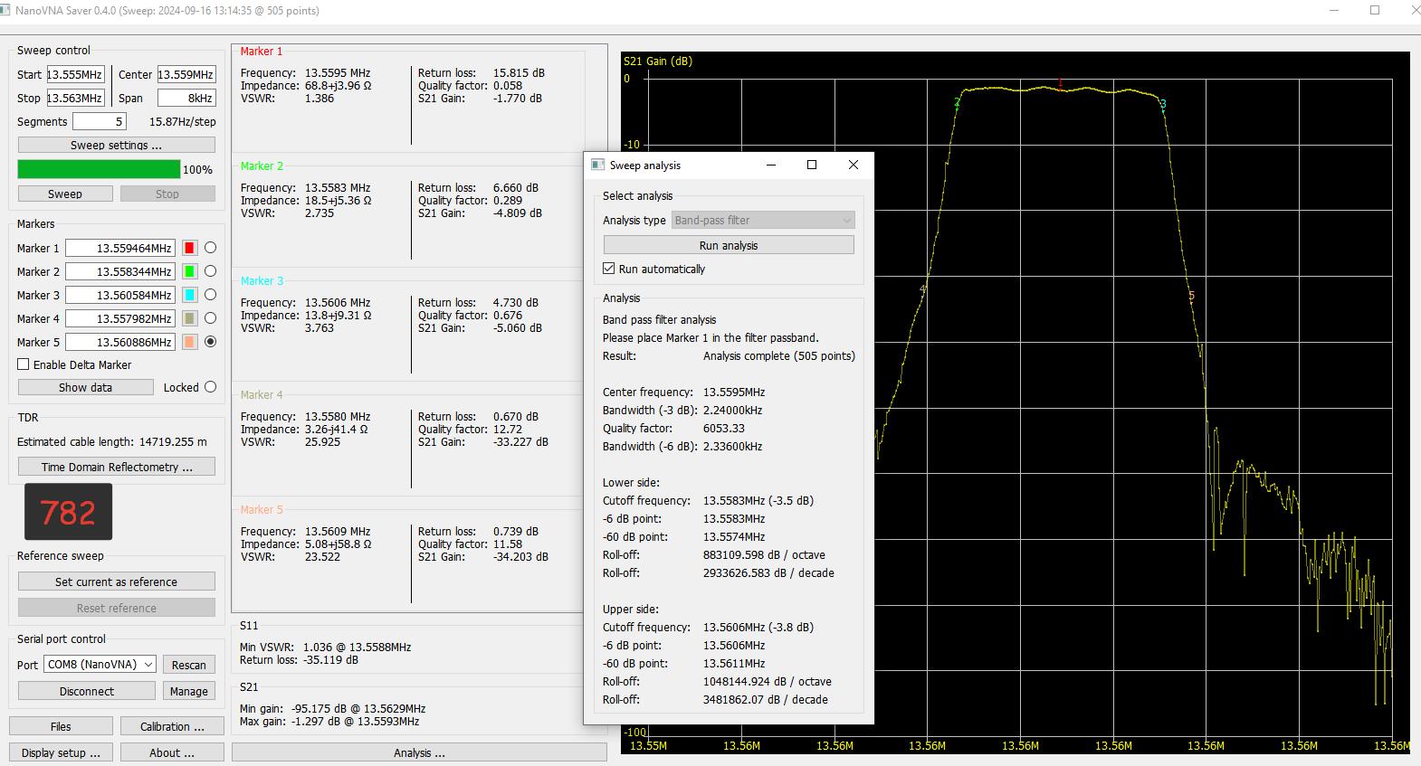
AFC/782-13M.jpg
