Fmulder007/Karat-3.5/AFC/782-48M.jpg

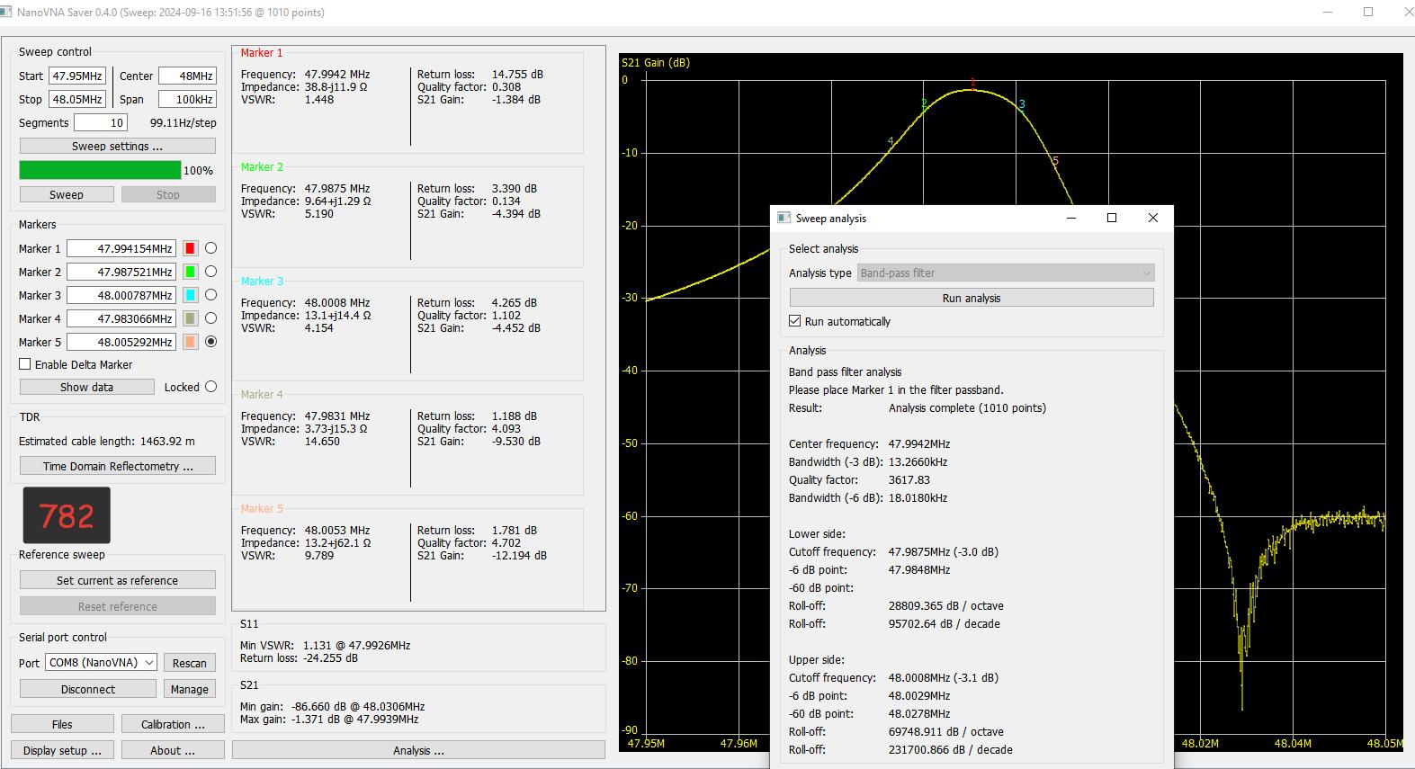
AFC/782-48M.jpg
