Fmulder007/Karat-3.5/AFC/783-13M.jpg

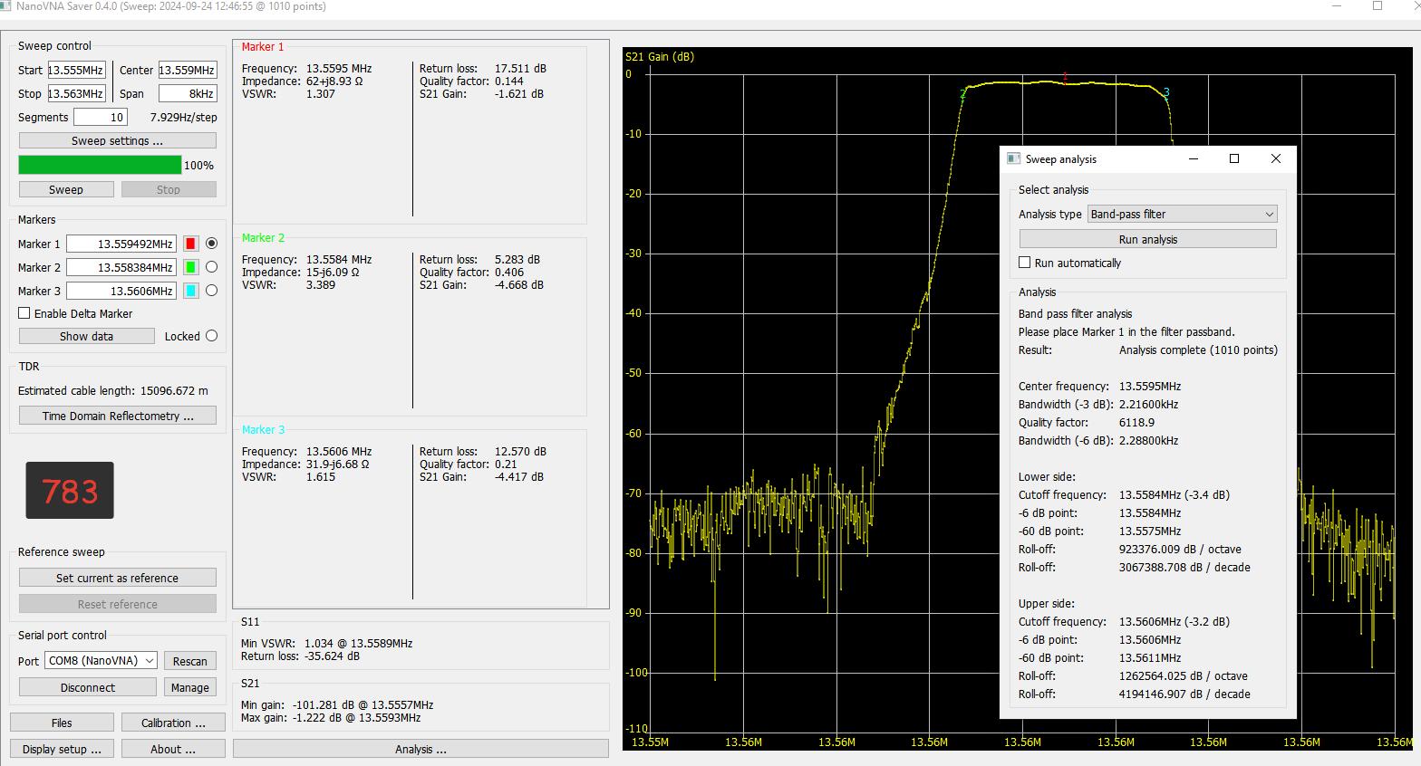
AFC/783-13M.jpg
