Fmulder007/Karat-3.5/AFC/783-LPF.jpg

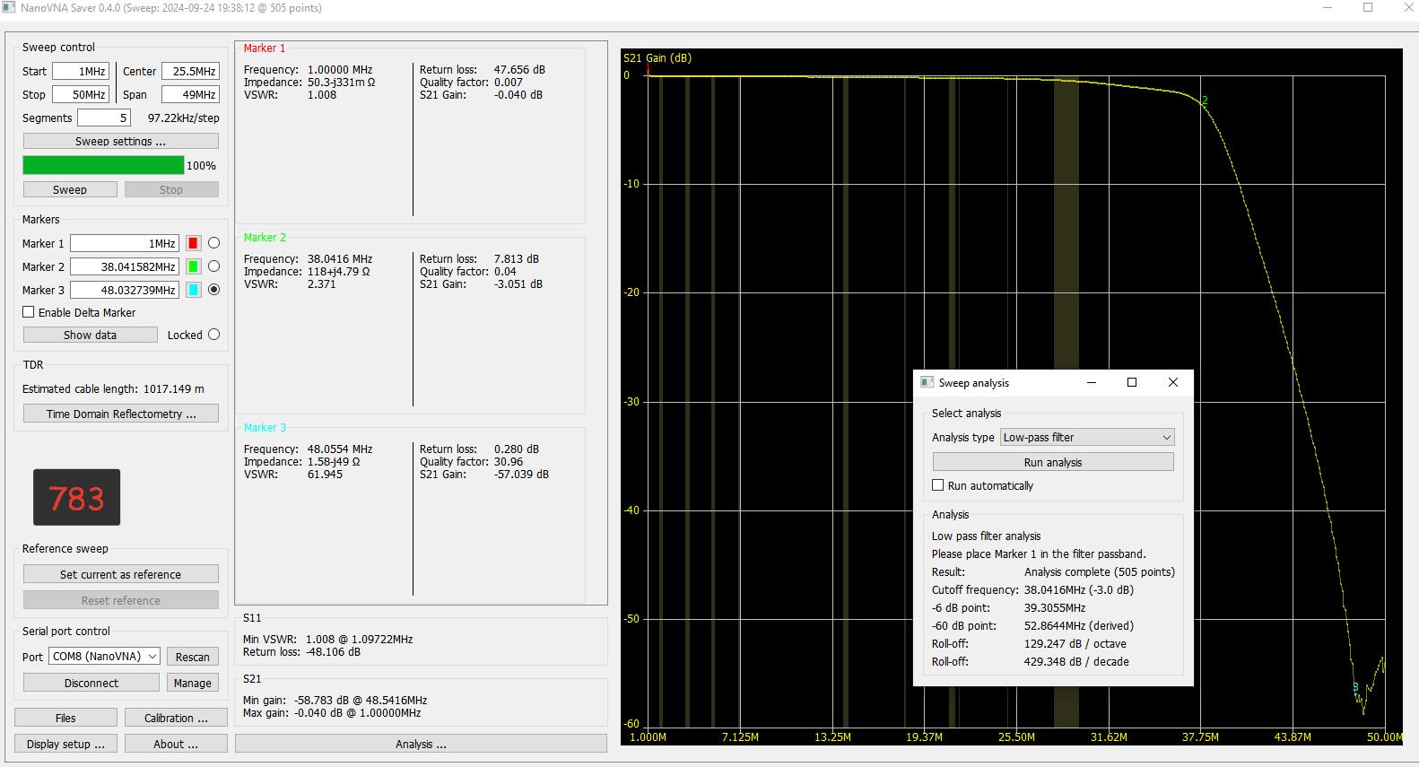
AFC/783-LPF.jpg
