Fmulder007/Karat-3.5/Code/160x03/Fuse_8MHz_Int.jpg

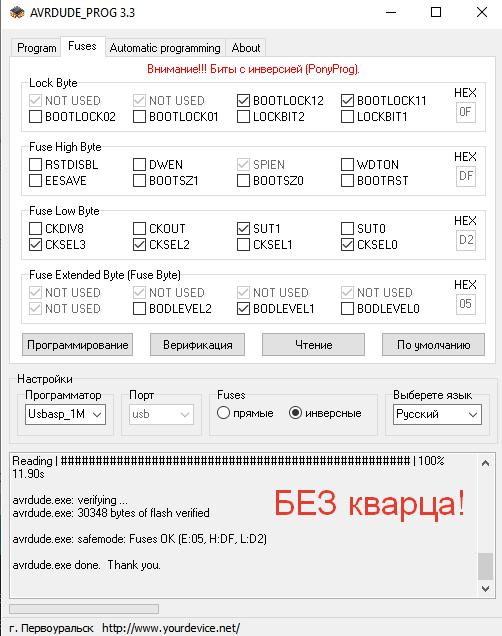
Code/160x03/Fuse_8MHz_Int.jpg
