Fmulder007/Karat-3.5/Code/160x08/8MHz_int.jpg

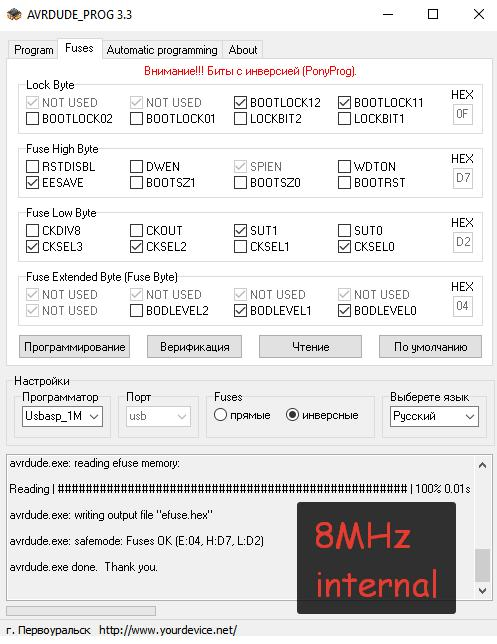
Code/160x08/8MHz_int.jpg
