Fmulder007/Karat-3.5/Code/160x10/Fuse_8MHz_Int.jpg

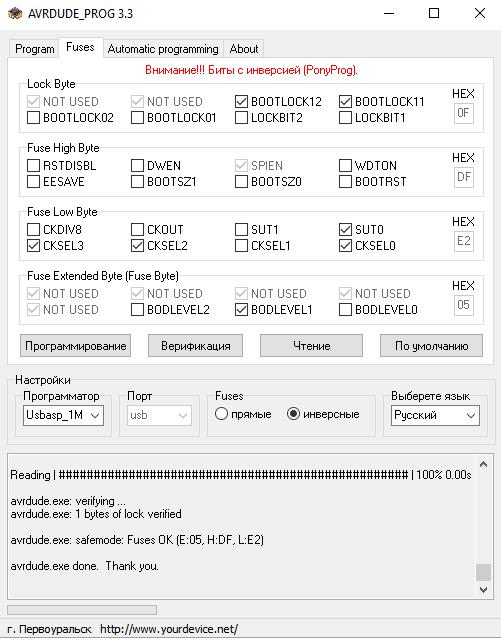
Code/160x10/Fuse_8MHz_Int.jpg
