Fmulder007/Karat-3.5/Code/160x12/16MHz_xtall.jpg

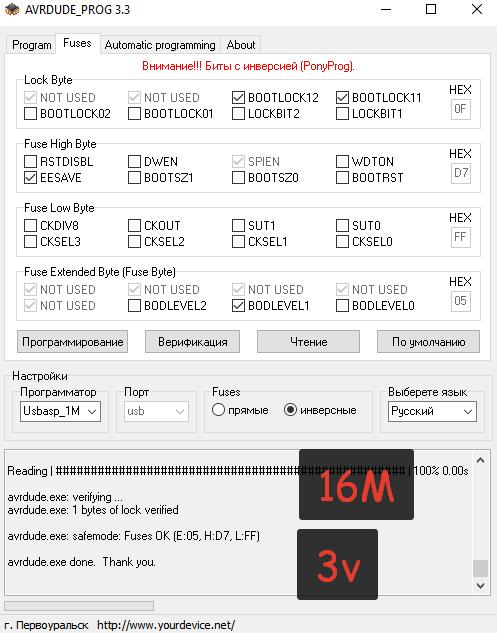
Code/160x12/16MHz_xtall.jpg
