Fmulder007/Karat-3.5/Code/160x14/FUSE_8M_int.jpg

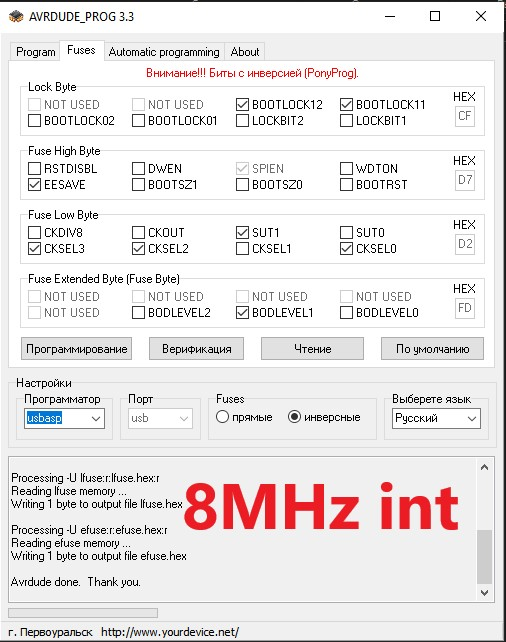
Code/160x14/FUSE_8M_int.jpg
