Fmulder007/Karat-3.5/Code/160x15/FUSE_16M_ext.jpg

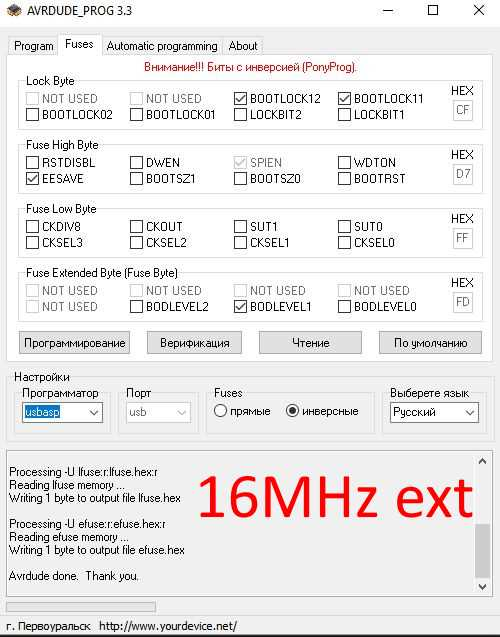
Code/160x15/FUSE_16M_ext.jpg
