Fmulder007/Karat-3.5/Man/2026-03-19_22-43-49.jpg

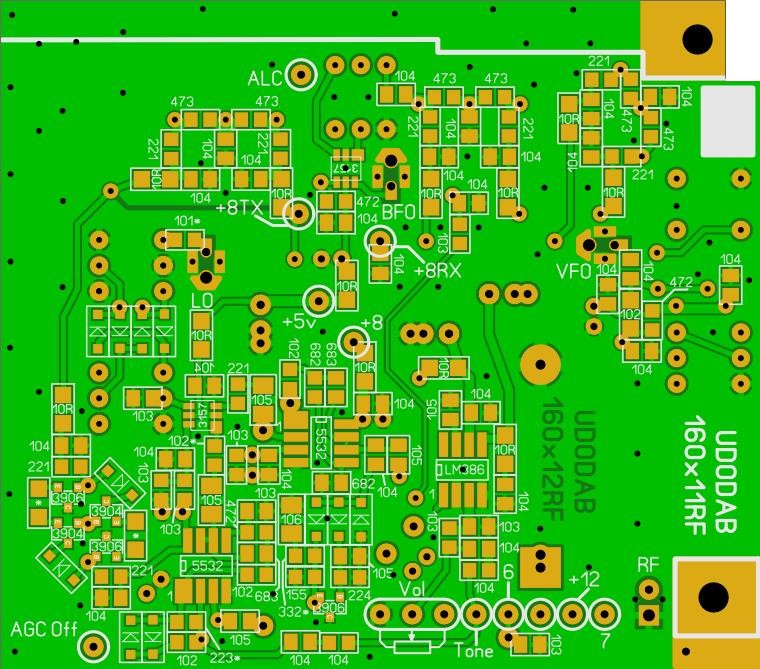
Man/2026-03-19_22-43-49.jpg
