Fmulder007/Karat-3.5/Man/Appendix1.GIF

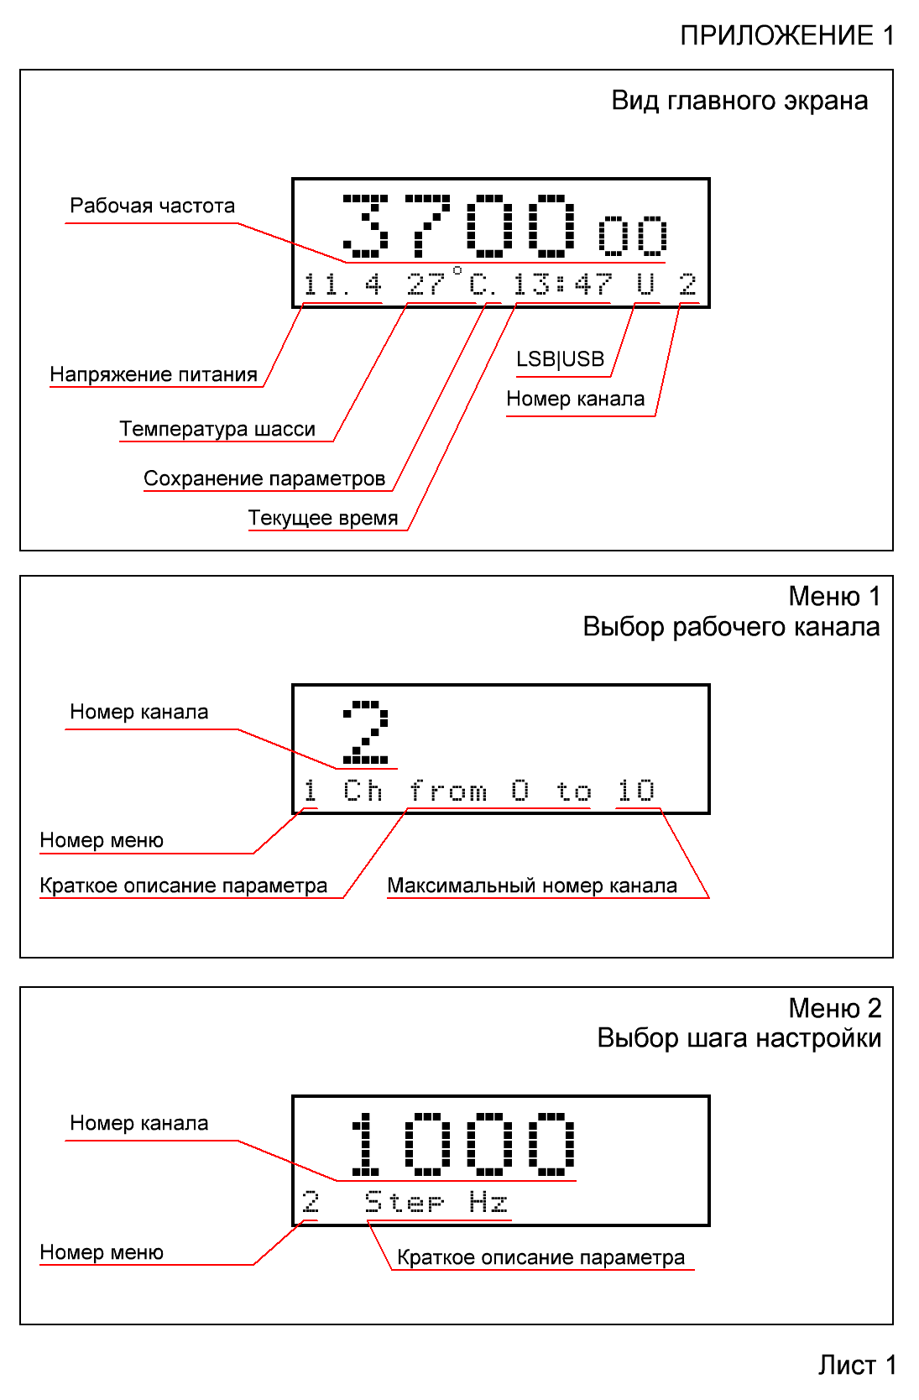
Man/Appendix1.GIF
