Fmulder007/Karat-3.5/Man/fast_menu_legend.GIF

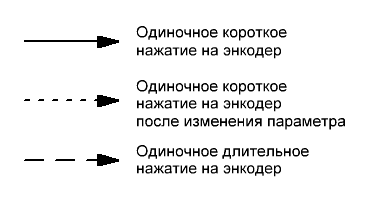
Man/fast_menu_legend.GIF
