Fmulder007/Karat-3.5/Man/NEW_LPF.GIF

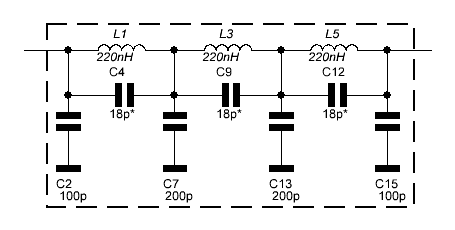
Man/NEW_LPF.GIF
