Fmulder007/Karat-3.5/Man/NEW_LPF.png

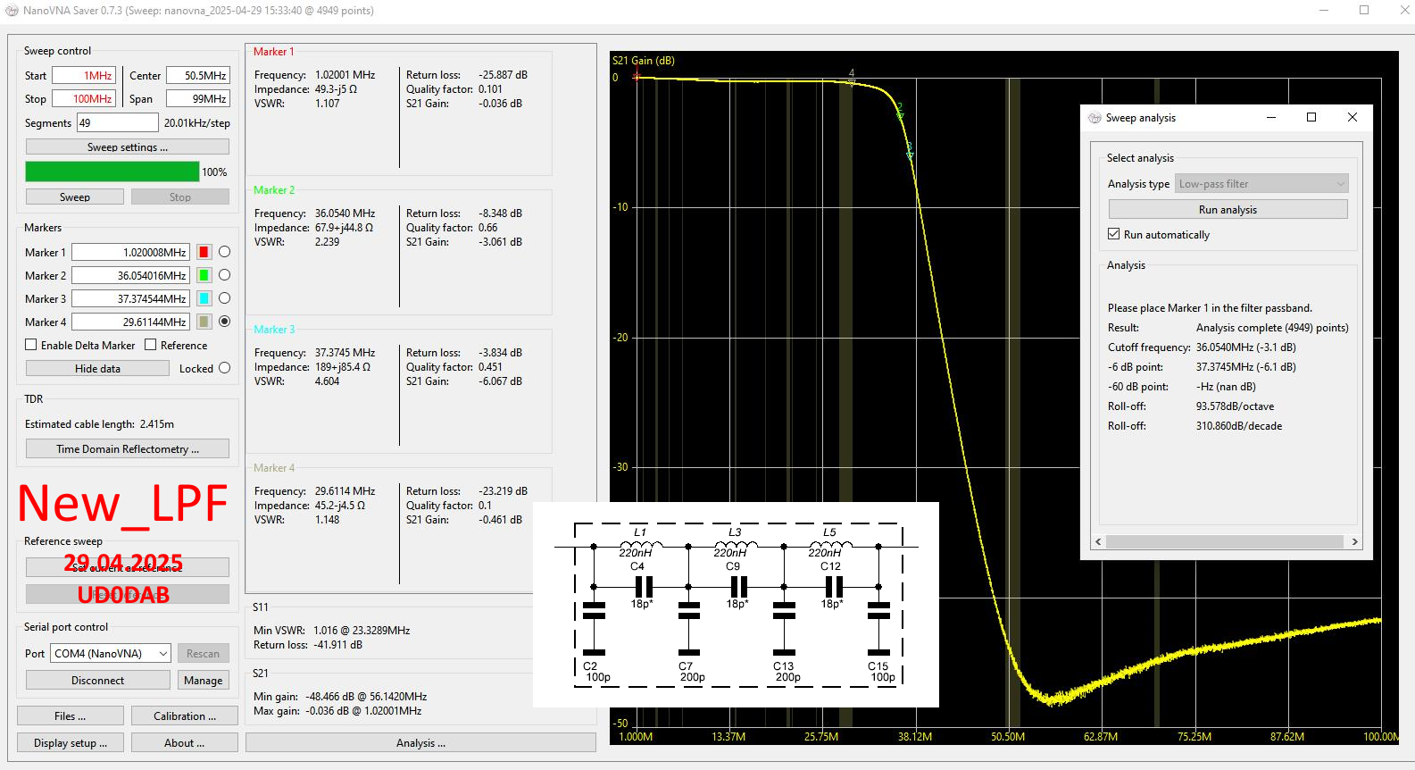
Man/NEW_LPF.png
