Fmulder007/Karat-3.5/Photo/0.15uV.jpg

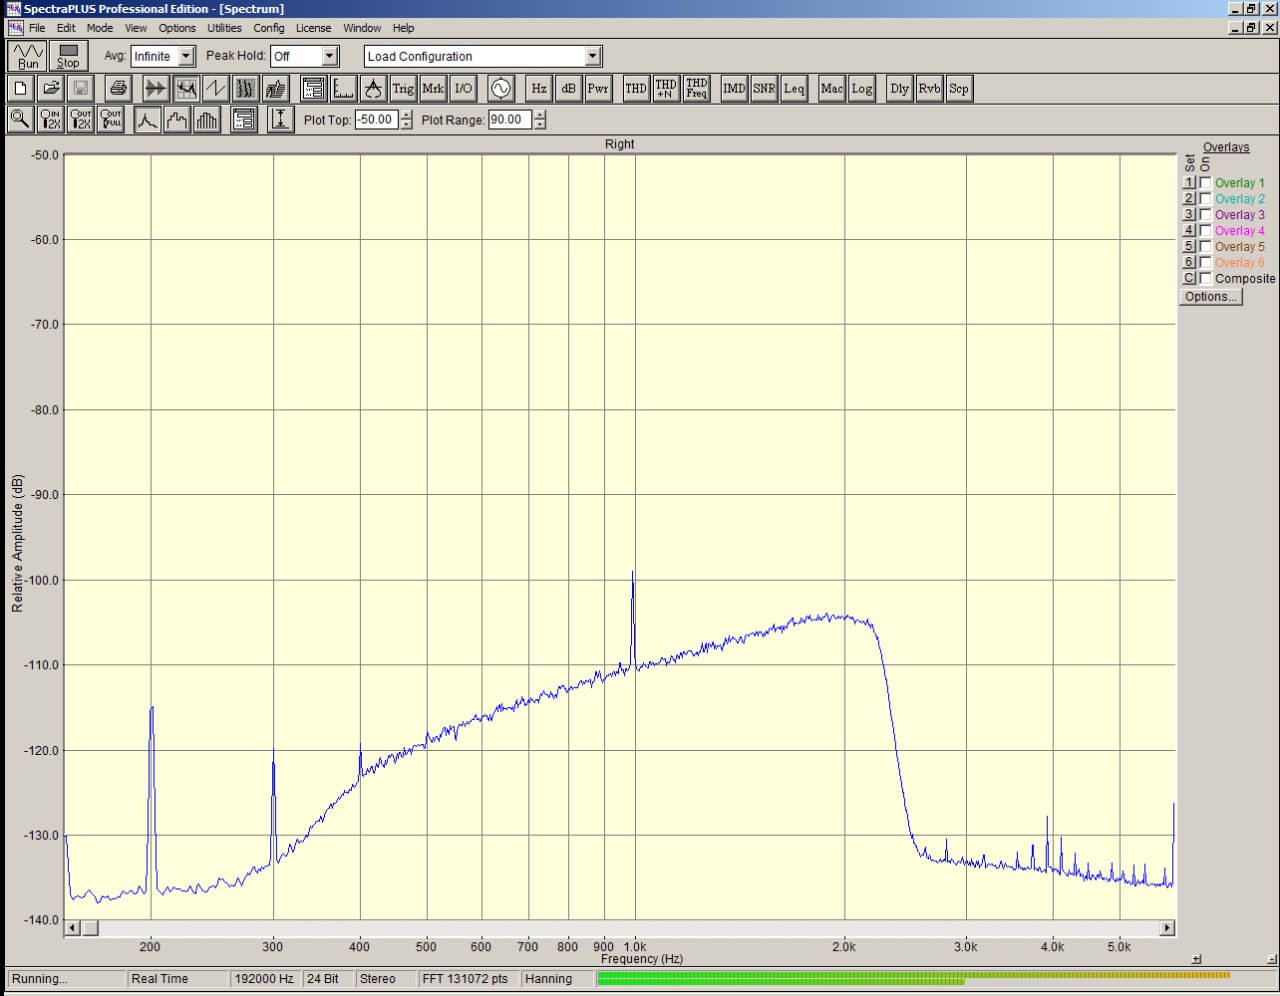
Photo/0.15uV.jpg
