Fmulder007/Karat-3.5/Photo/1.5uV.jpg

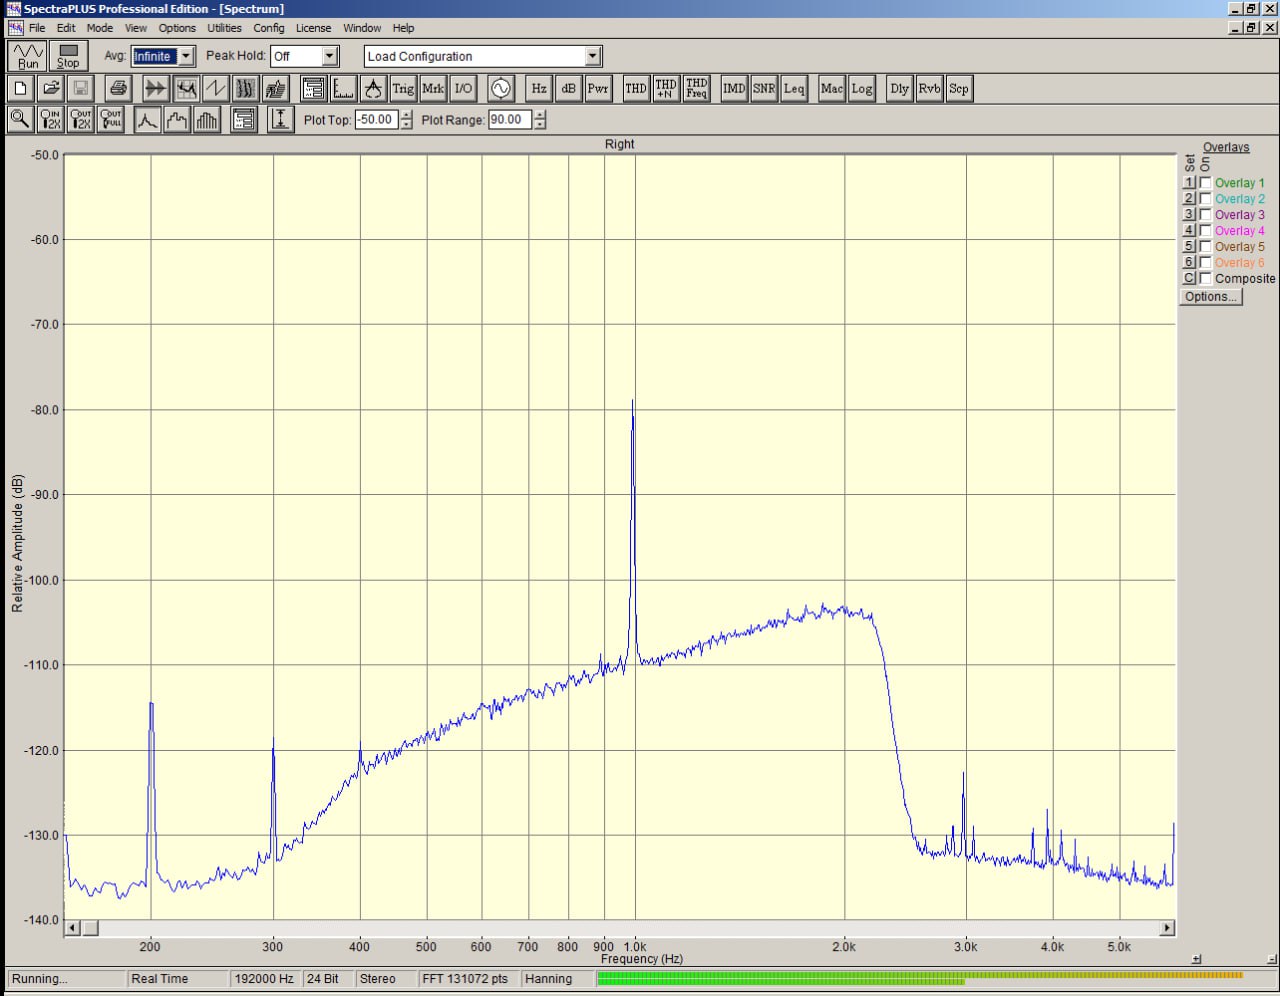
Photo/1.5uV.jpg
