Fmulder007/Karat-3.5/Photo/2025-08-26_15-30-18.jpg

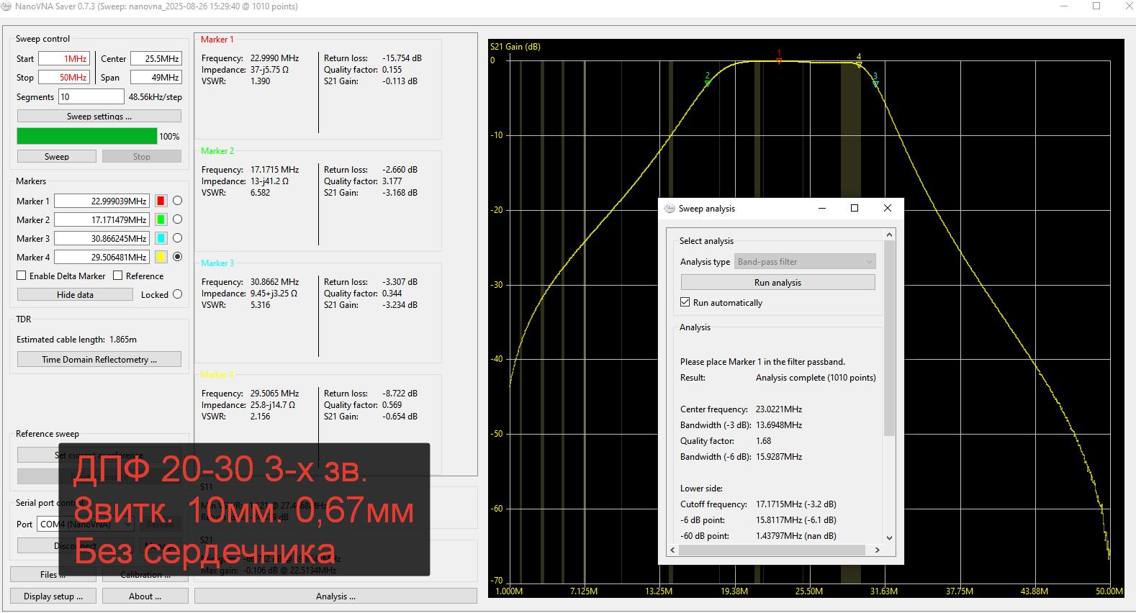
Photo/2025-08-26_15-30-18.jpg
