Fmulder007/Karat-3.5/Photo/2025-08-26_23-58-59.jpg

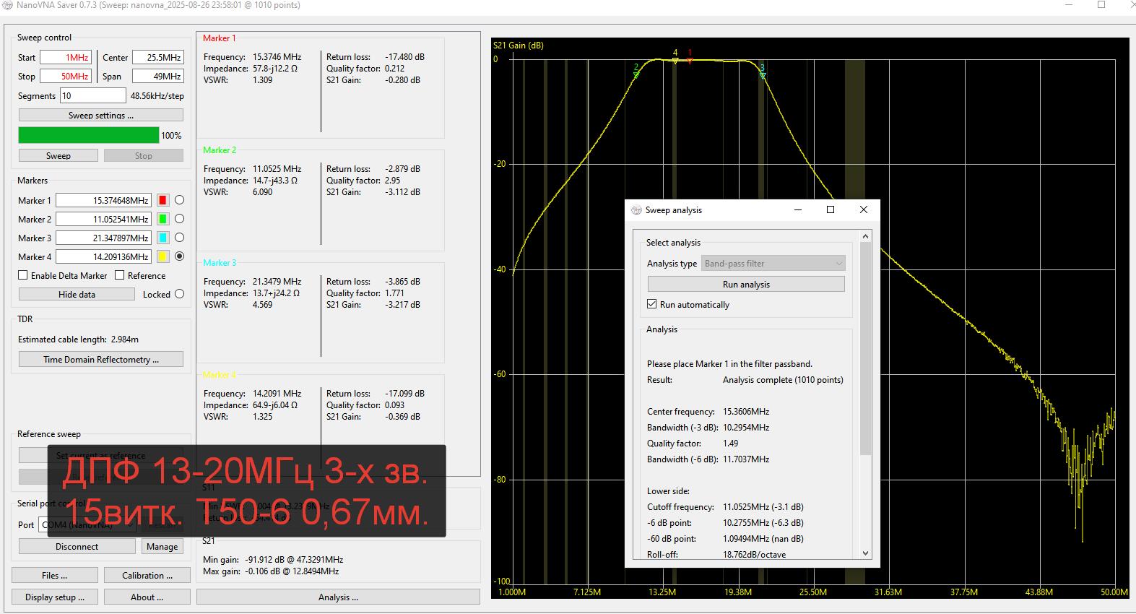
Photo/2025-08-26_23-58-59.jpg
