Fmulder007/Karat-3.5/Photo/2025-08-27_18-36-56.jpg

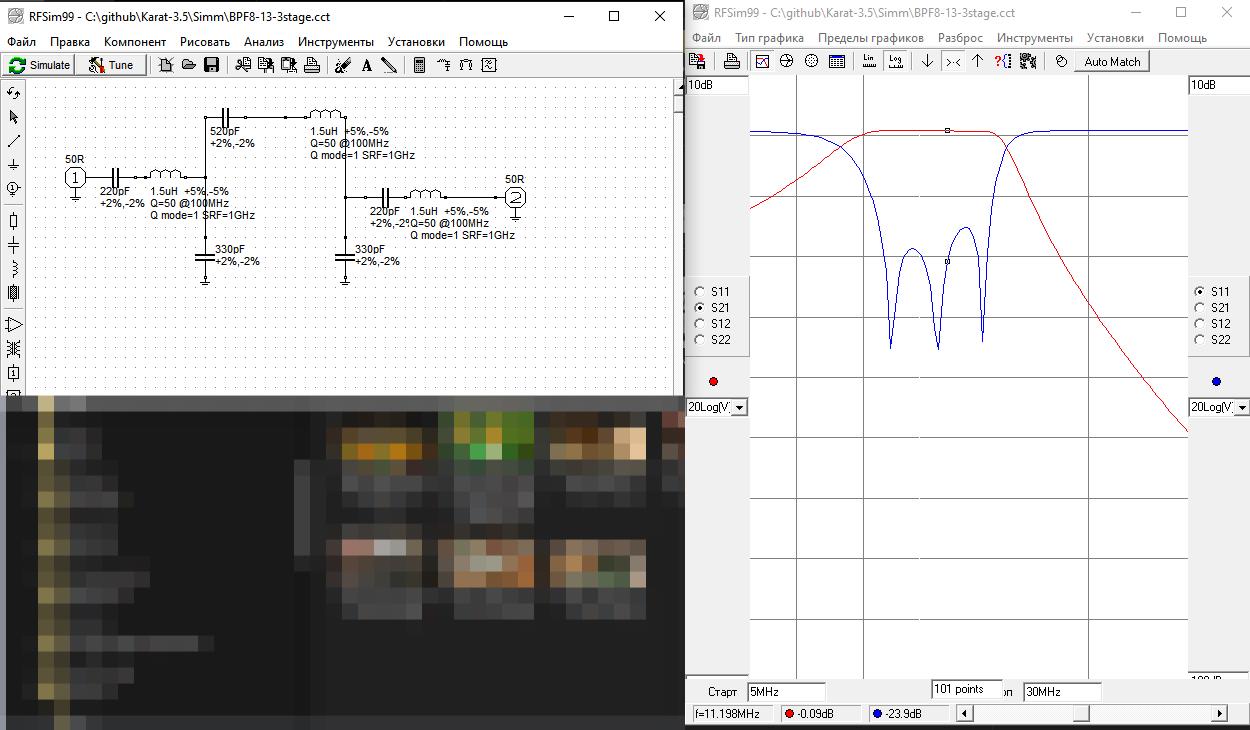
Photo/2025-08-27_18-36-56.jpg
