Fmulder007/Karat-3.5/Photo/2025-08-27_22-30-39.jpg

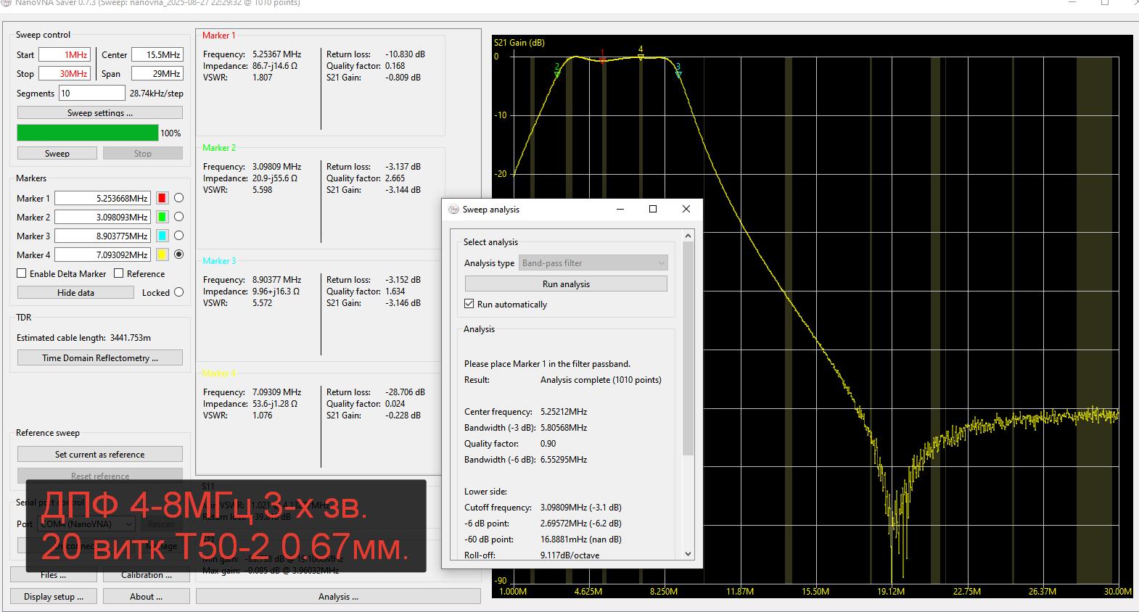
Photo/2025-08-27_22-30-39.jpg
