Fmulder007/Karat-3.5/Photo/2025-08-27_22-31-58.jpg

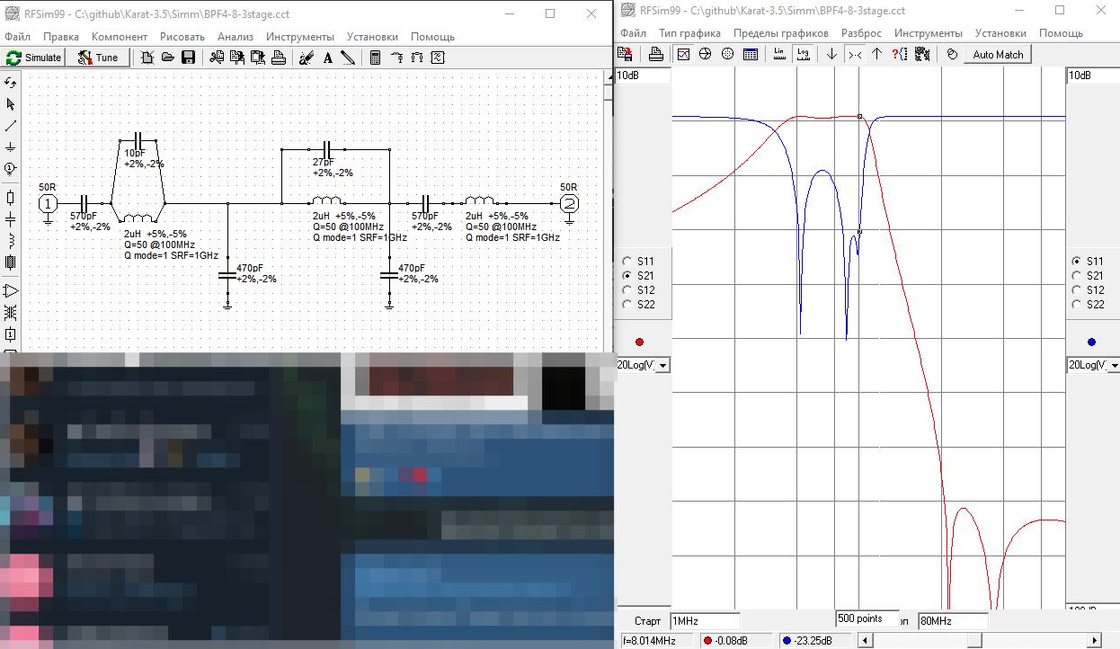
Photo/2025-08-27_22-31-58.jpg
