Fmulder007/Karat-3.5/Photo/2025-12-14_14-40-26.jpg

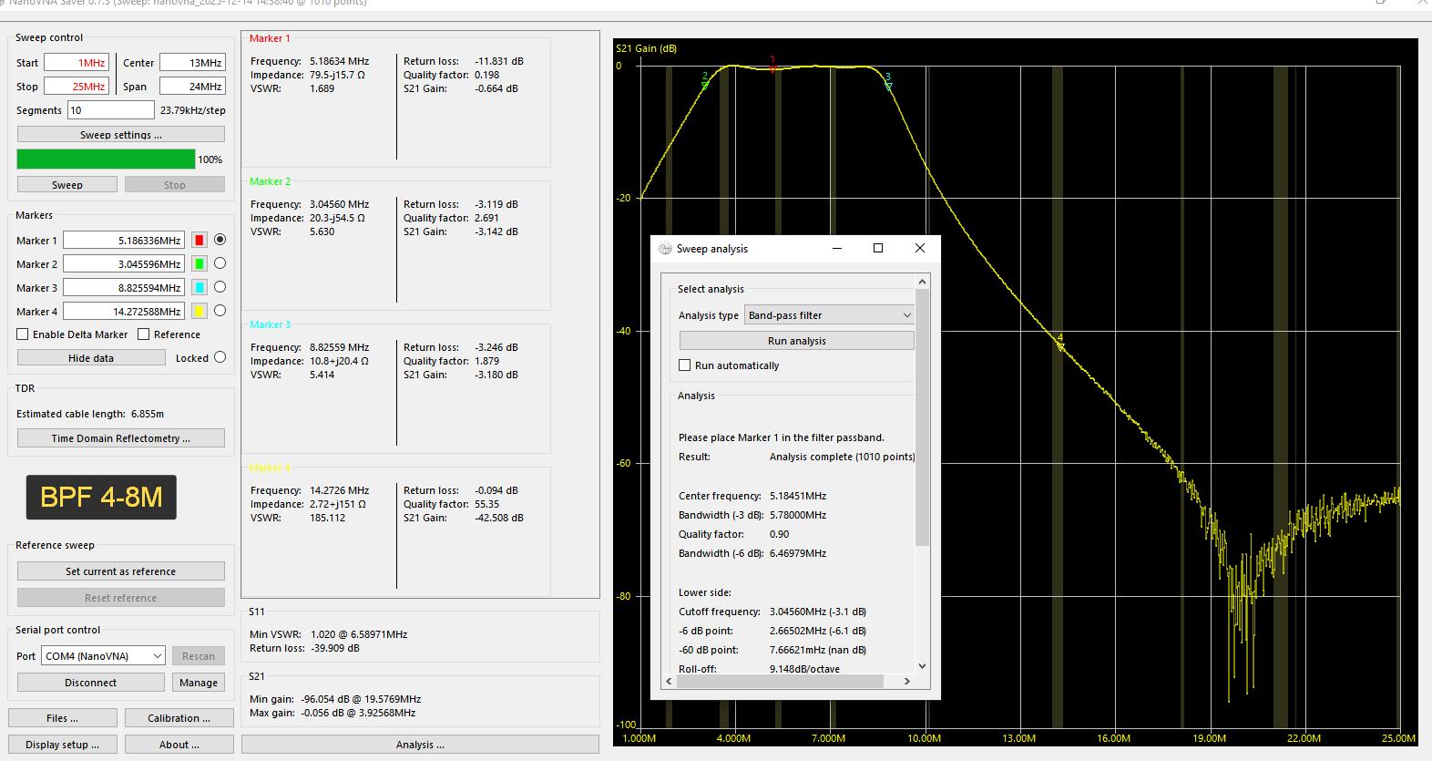
Photo/2025-12-14_14-40-26.jpg
