Fmulder007/Karat-3.5/Photo/Control.jpg

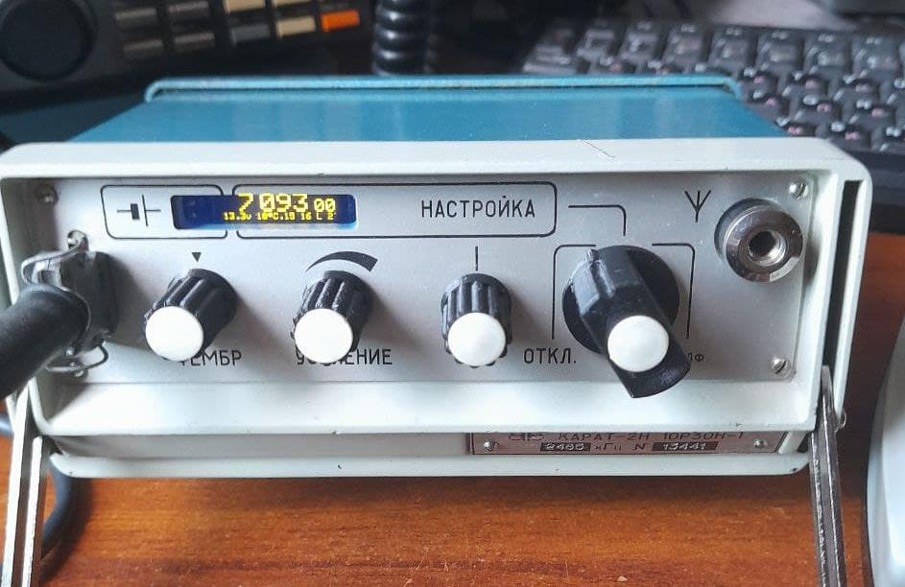
Photo/Control.jpg
