Fmulder007/Karat-3.5/Photo/Display.jpg

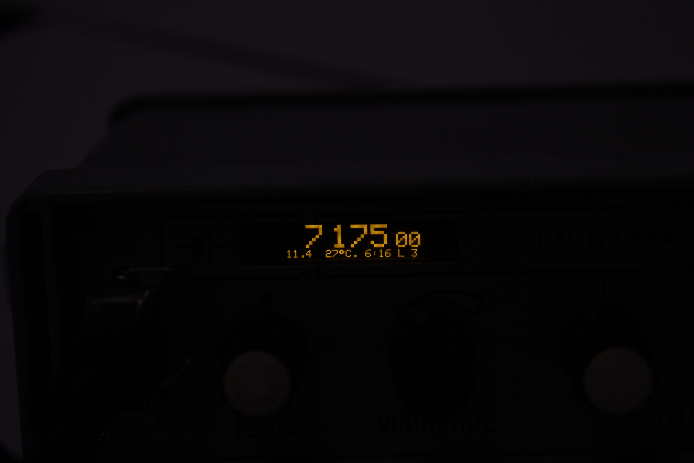
Photo/Display.jpg
