Fmulder007/Karat-3.5/Photo/ERROR 160x05.jpg

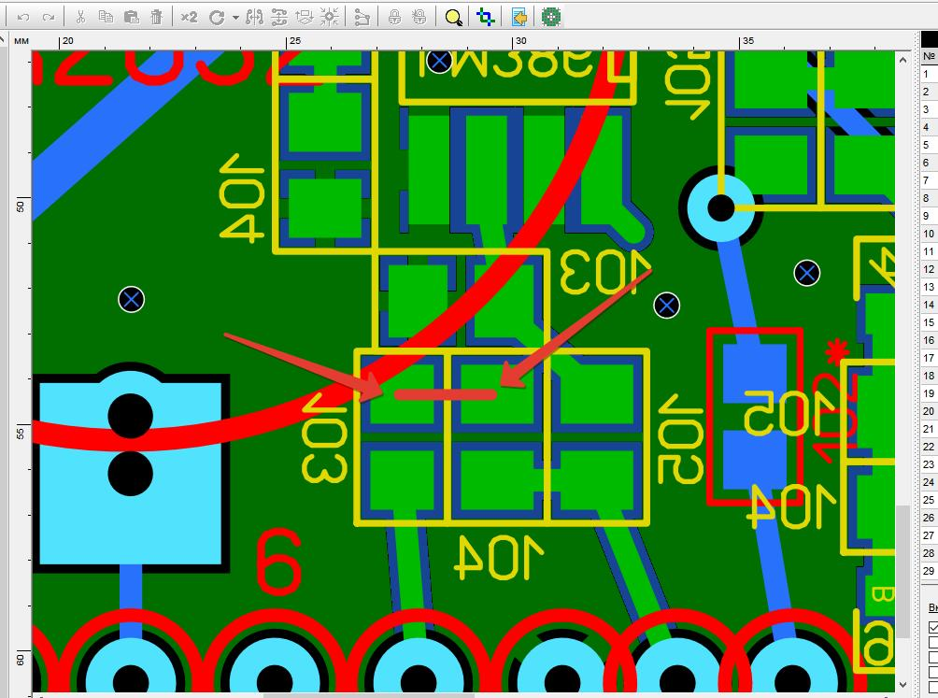
Photo/ERROR 160x05.jpg
