Fmulder007/Karat-3.5/Photo/image003.jpg

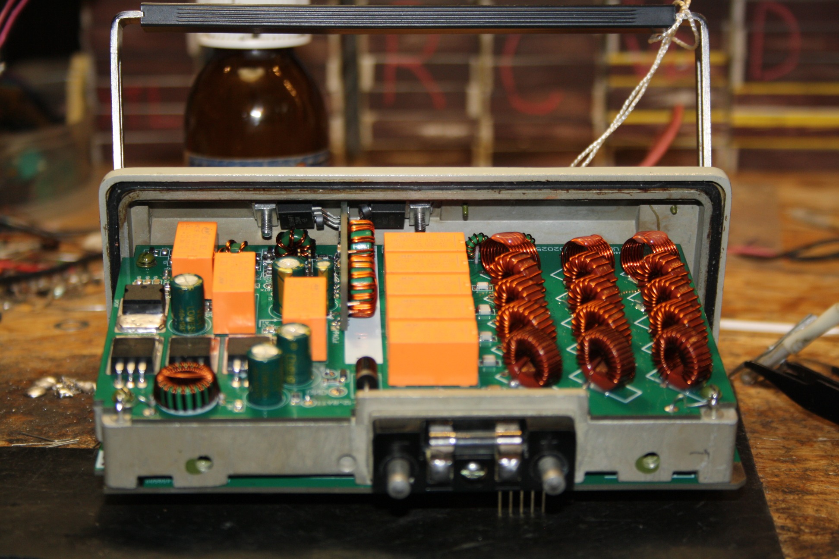
Photo/image003.jpg
