Fmulder007/Karat-3.5/Photo/image004.jpg

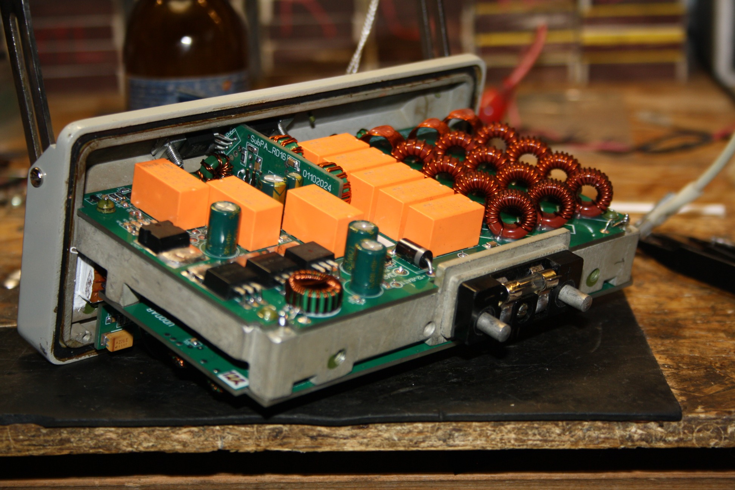
Photo/image004.jpg
