Fmulder007/Karat-3.5/Photo/image005.jpg

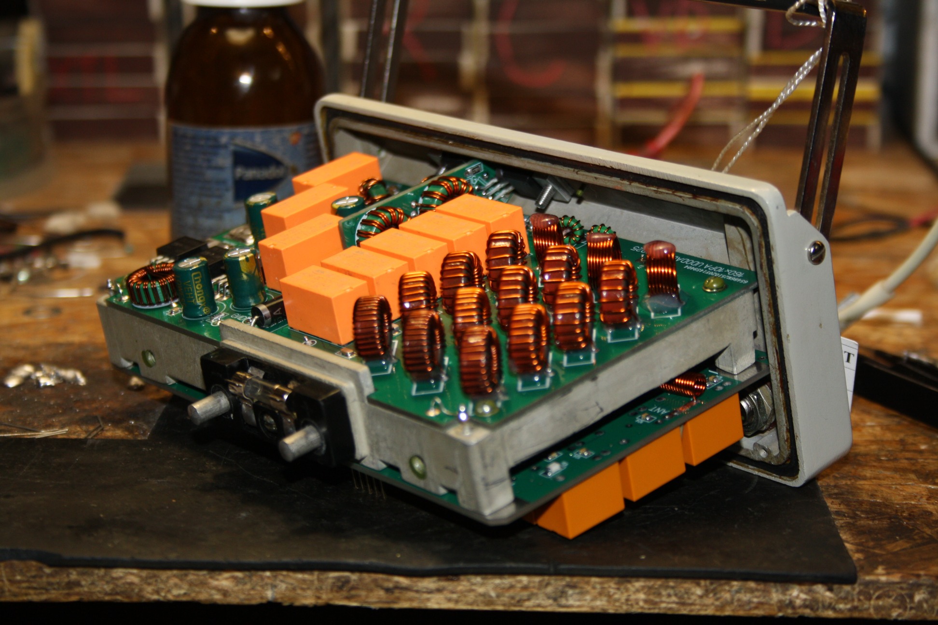
Photo/image005.jpg
