Fmulder007/Karat-3.5/Photo/image006.jpg

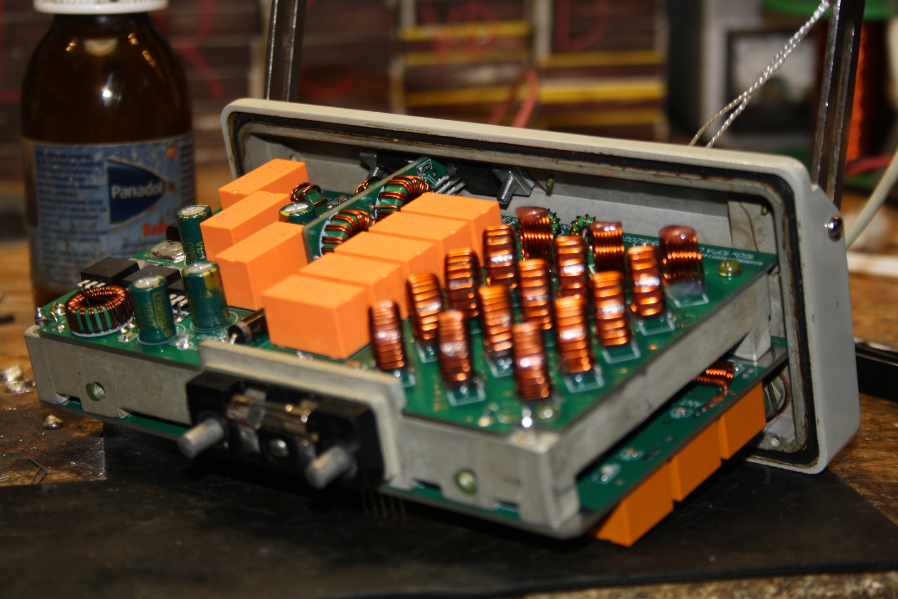
Photo/image006.jpg
