Fmulder007/Karat-3.5/Photo/IMG_6905.jpg

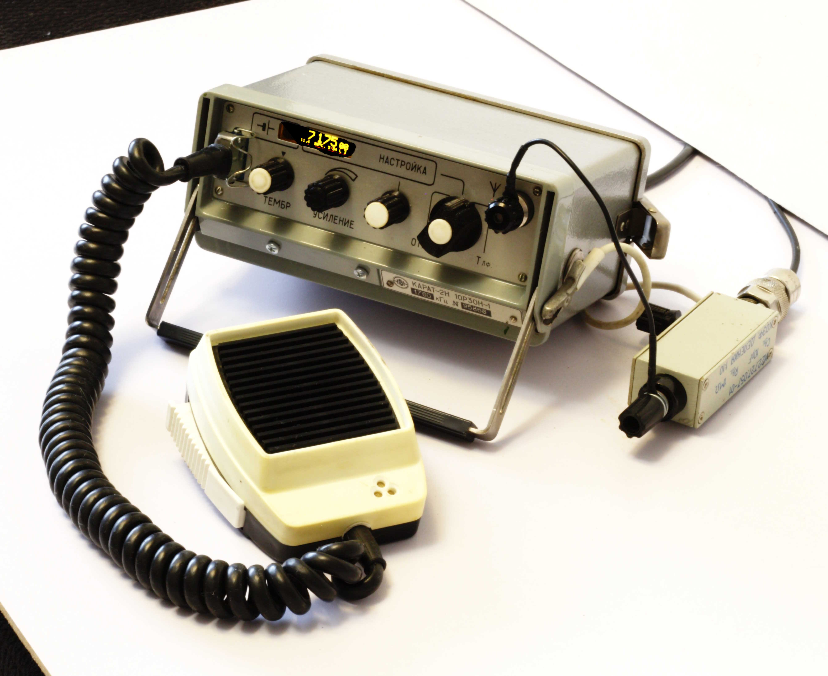
Photo/IMG_6905.jpg
