Fmulder007/Karat-3.5/Photo/IMG_20240807_115725_091-edited-1024x576.jpg

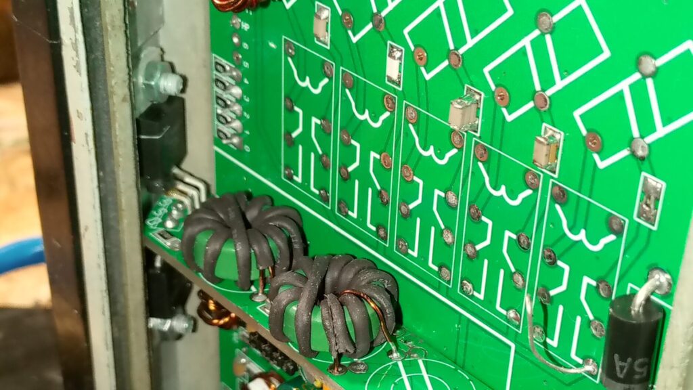
Photo/IMG_20240807_115725_091-edited-1024x576.jpg
