Fmulder007/Karat-3.5/Photo/IMG_20240814_131625_050-1024x461.jpg

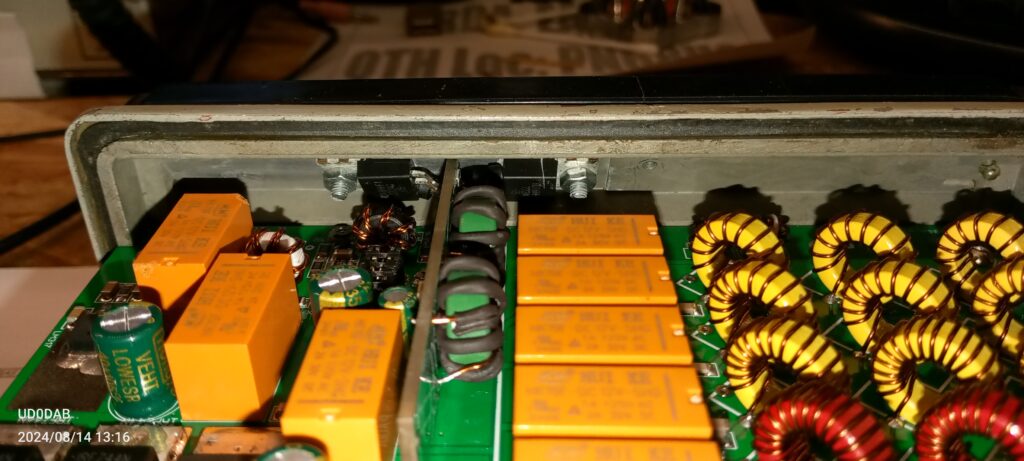
Photo/IMG_20240814_131625_050-1024x461.jpg
