Fmulder007/Karat-3.5/Photo/IMG_20240814_134434_076-scaled-e1723607211984-1024x623.jpg

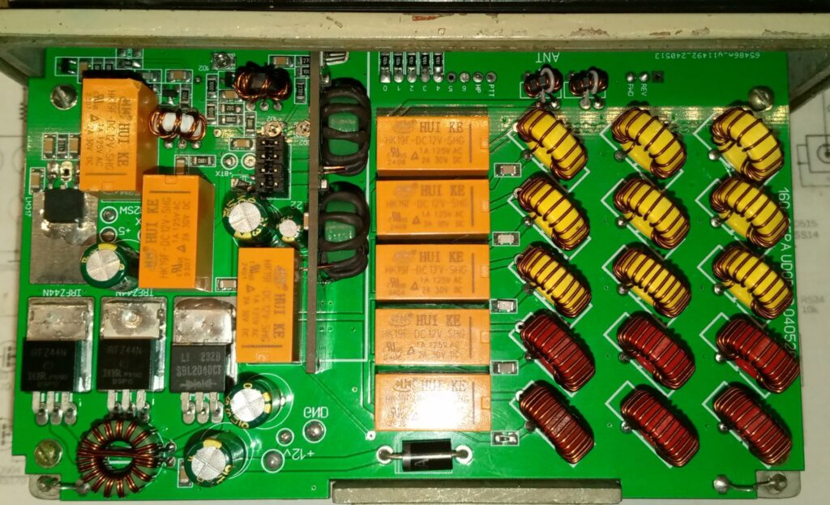
Photo/IMG_20240814_134434_076-scaled-e1723607211984-1024x623.jpg
