Fmulder007/Karat-3.5/Photo/IMG_20250325_190653_579.jpg

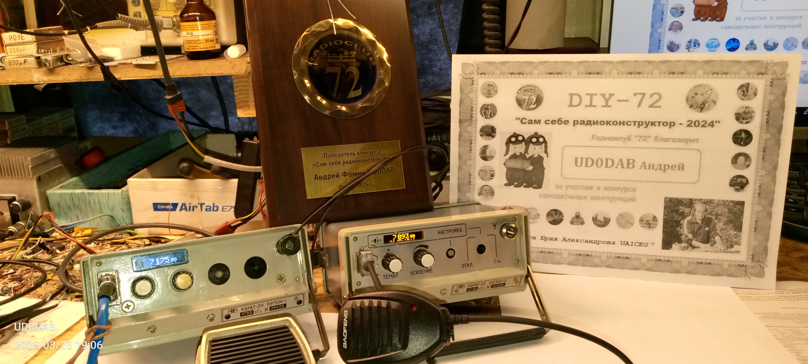
Photo/IMG_20250325_190653_579.jpg
