Fmulder007/Karat-3.5/Photo/IMG_20251114_115157_819.jpg

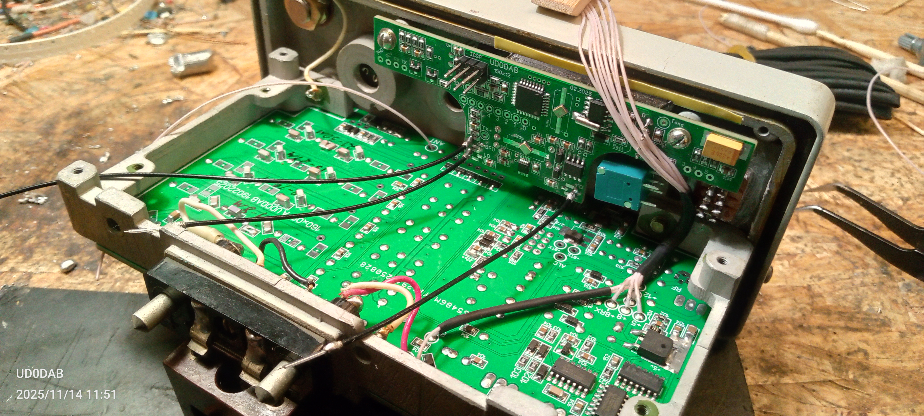
Photo/IMG_20251114_115157_819.jpg
