Fmulder007/Karat-3.5/Photo/IMG_20260109_175854_880.jpg

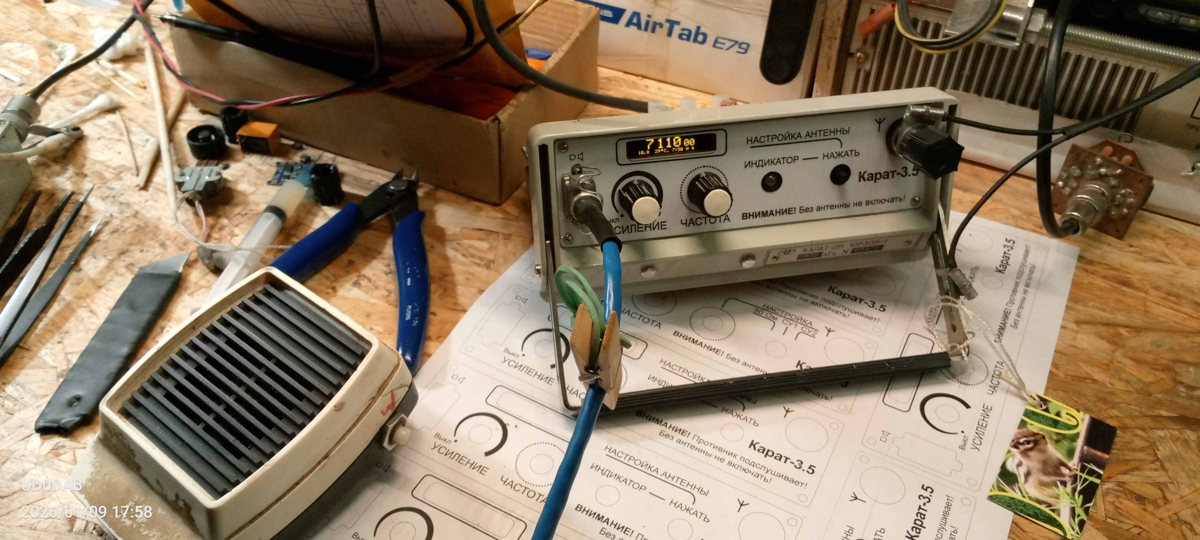
Photo/IMG_20260109_175854_880.jpg
