Fmulder007/Karat-3.5/Photo/photo_2024-07-09_22-55-04.jpg

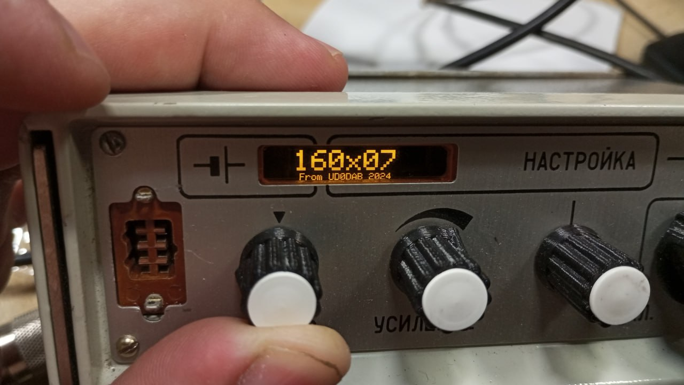
Photo/photo_2024-07-09_22-55-04.jpg
