Fmulder007/Karat-3.5/Photo/photo_2024-08-03_08-58-06.jpg

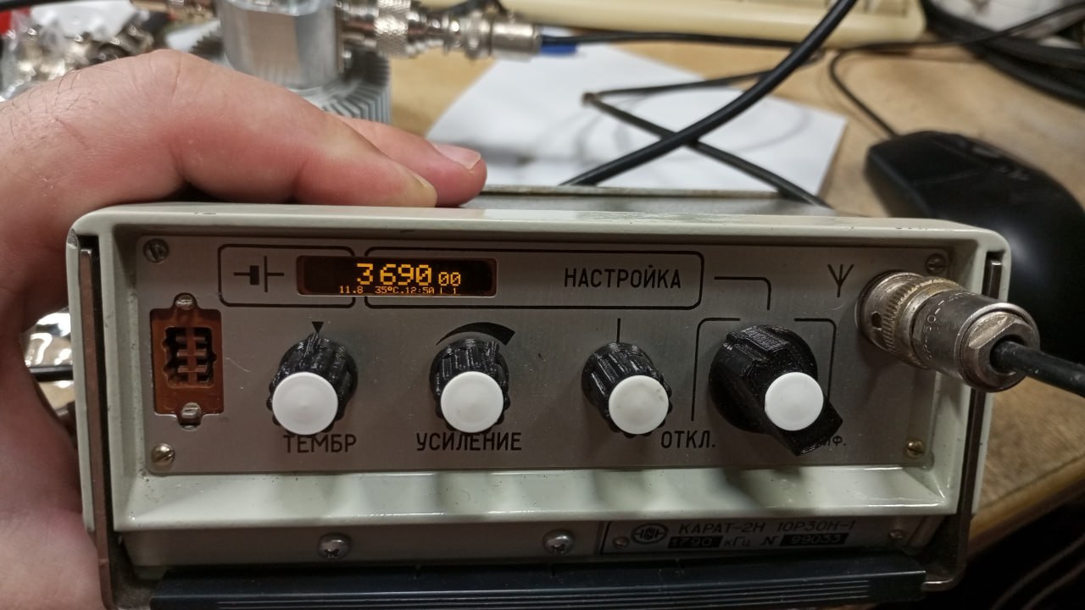
Photo/photo_2024-08-03_08-58-06.jpg
