Fmulder007/Karat-3.5/Photo/photo_2025-01-25_14-54-53.jpg

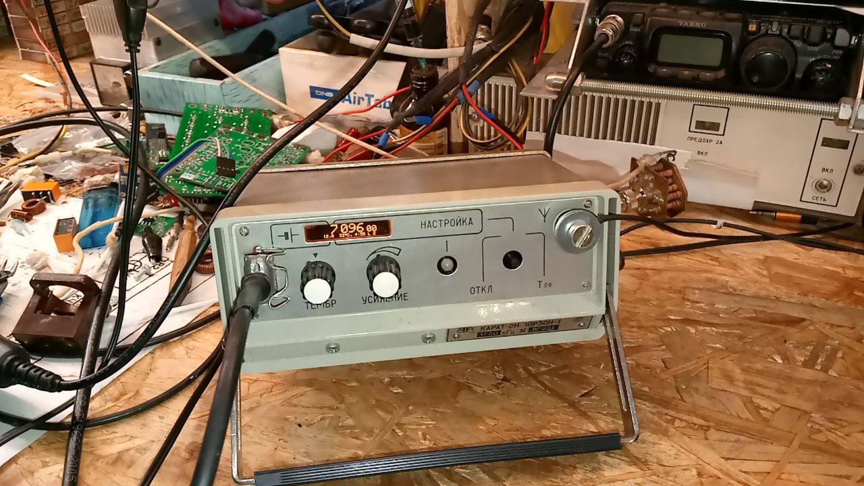
Photo/photo_2025-01-25_14-54-53.jpg
