Fmulder007/Karat-3.5/Photo/photo_2025-01-31_16-55-58.jpg

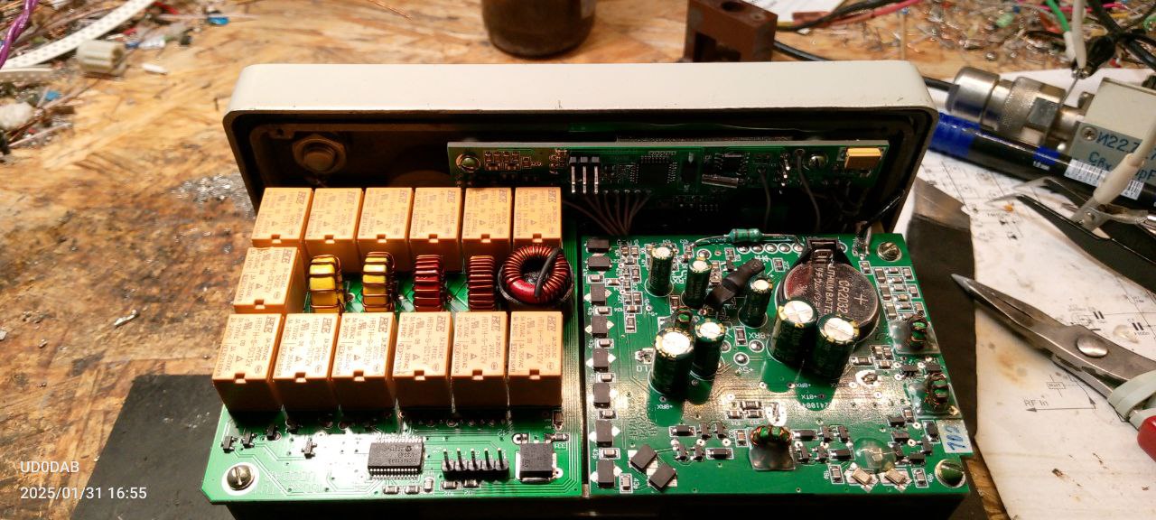
Photo/photo_2025-01-31_16-55-58.jpg
