Fmulder007/Karat-3.5/Photo/photo_2026-01-23_22-02-34.jpg

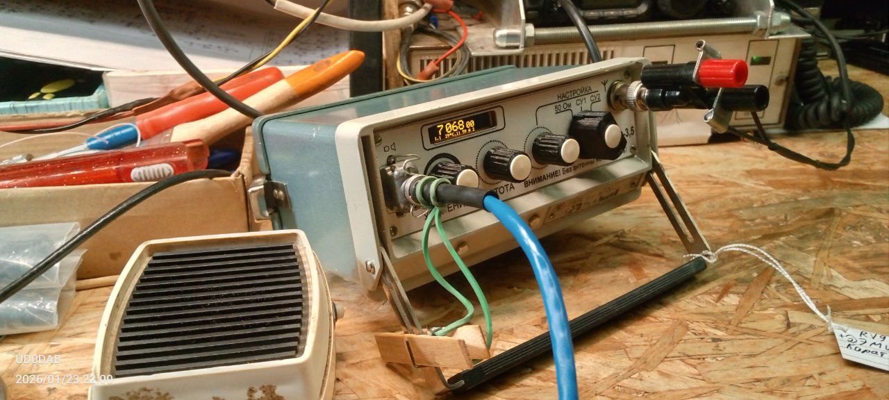
Photo/photo_2026-01-23_22-02-34.jpg
