Fmulder007/Karat-3.5/Photo/photo_2026-03-08_22-42-29.jpg

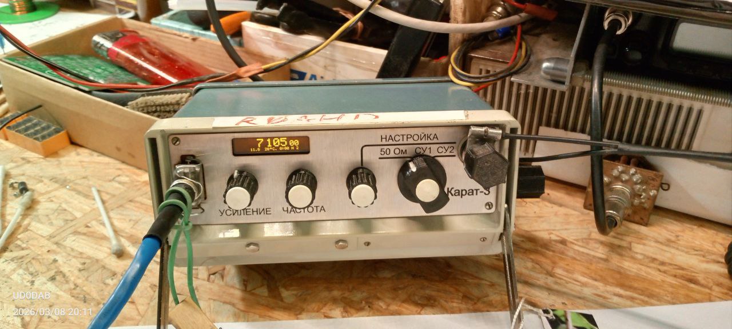
Photo/photo_2026-03-08_22-42-29.jpg
