Fmulder007/Karat-3.5/photo_2023-01-27_22-55-51 (2).jpg

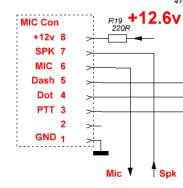
photo_2023-01-27_22-55-51 (2).jpg
