Fmulder007/Karat-3.5/Simm/160x05_3904_PA_S11.png

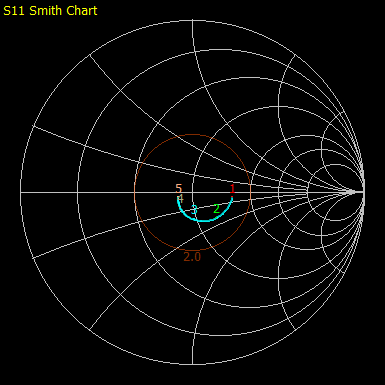
Simm/160x05_3904_PA_S11.png
