Fmulder007/Karat-3.5/Simm/BPF20-30.jpg

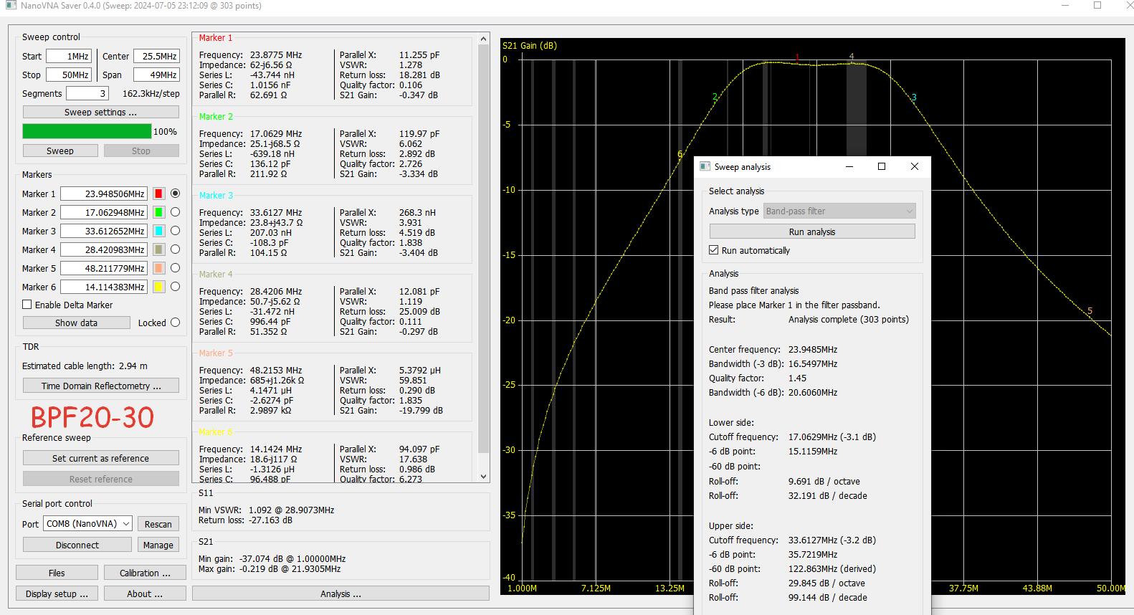
Simm/BPF20-30.jpg
