Fmulder007/Karat-3.5/Simm/FM_Detector.jpg

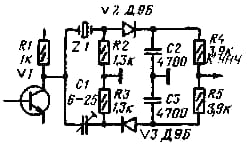
Simm/FM_Detector.jpg
