Fmulder007/Karat-3.5/Simm/photo_2024-11-14_02-17-44.jpg

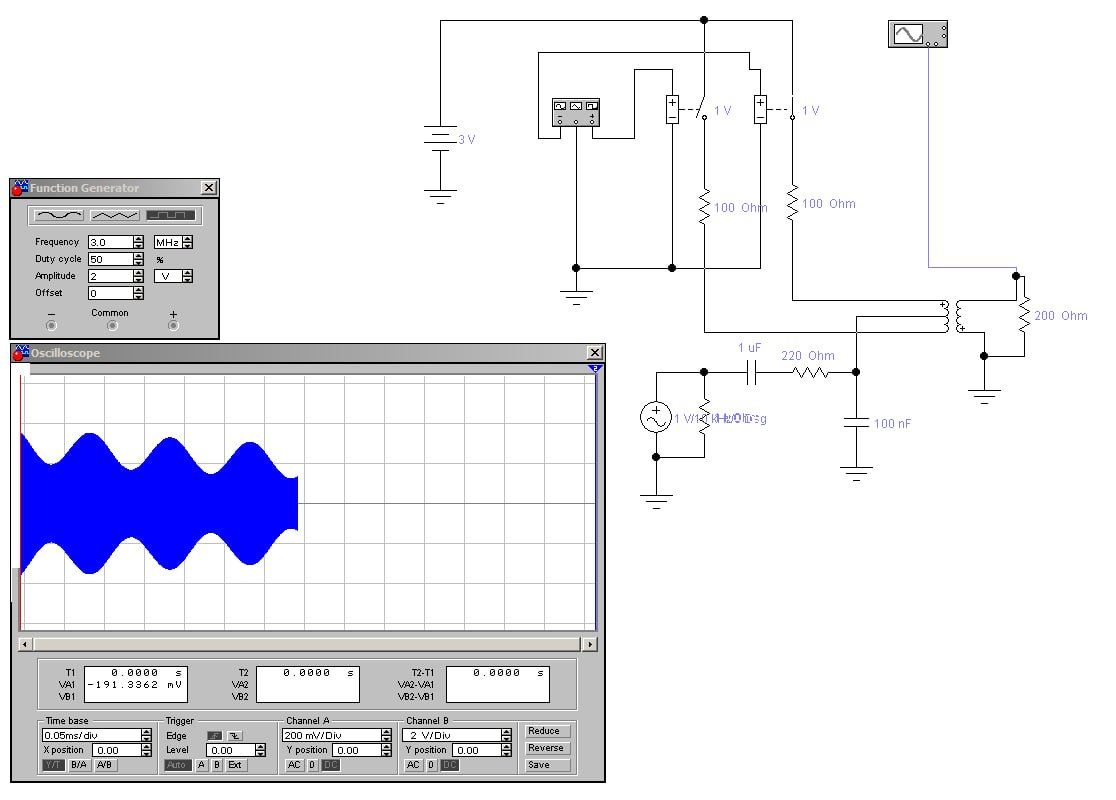
Simm/photo_2024-11-14_02-17-44.jpg
