Fmulder007/Karat-3.5/Simm/НЧ_CW_полосовик.JPG

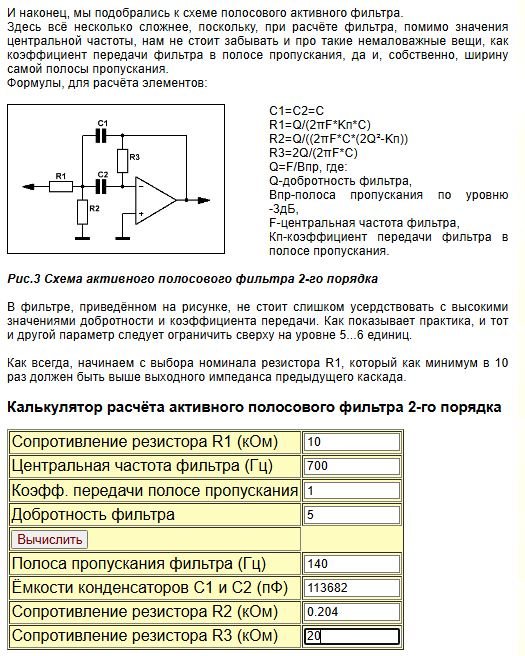
Simm/НЧ_CW_полосовик.JPG
