Fmulder007/Karat-3.5/Splan/160x05RF.GIF

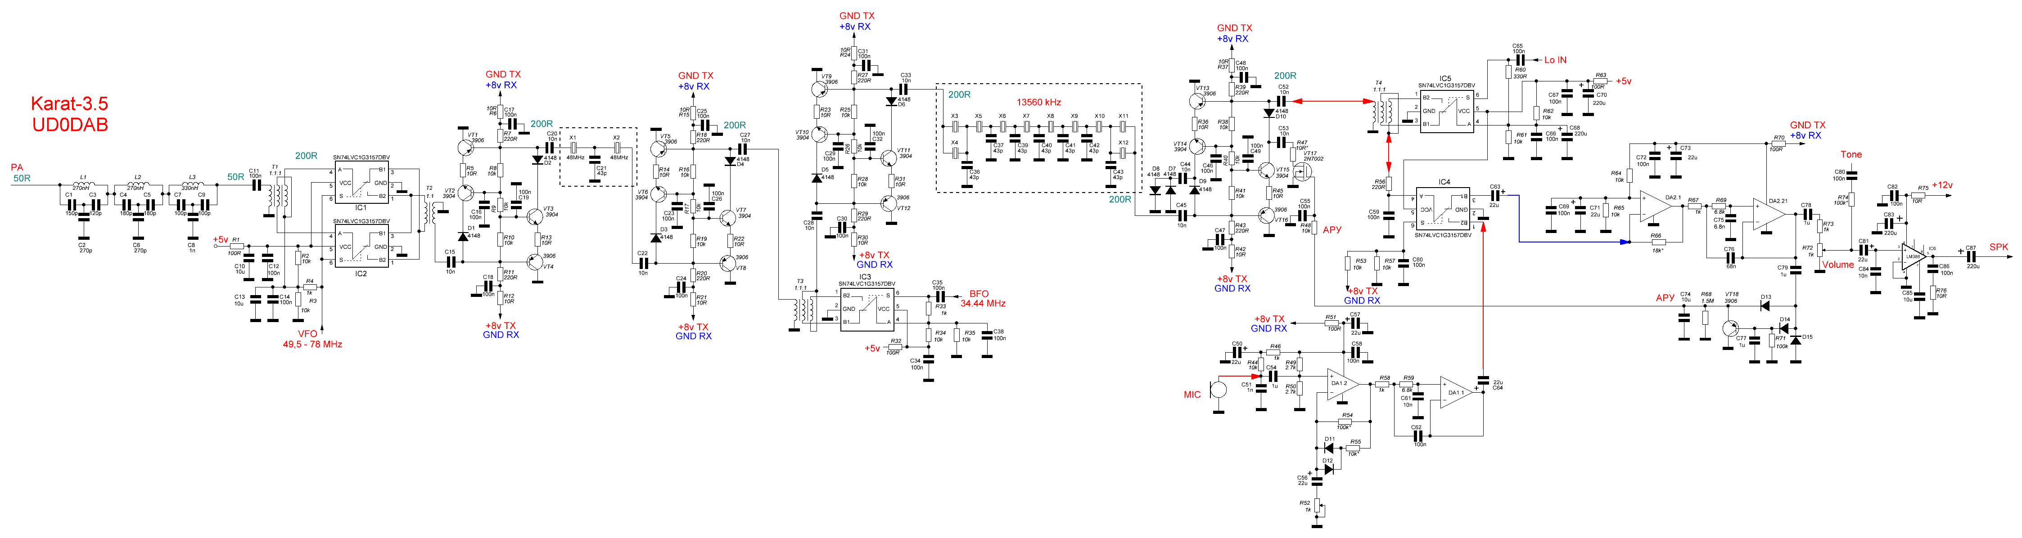
Splan/160x05RF.GIF
