Fmulder007/Karat-3.5/Splan/160x08PA.GIF

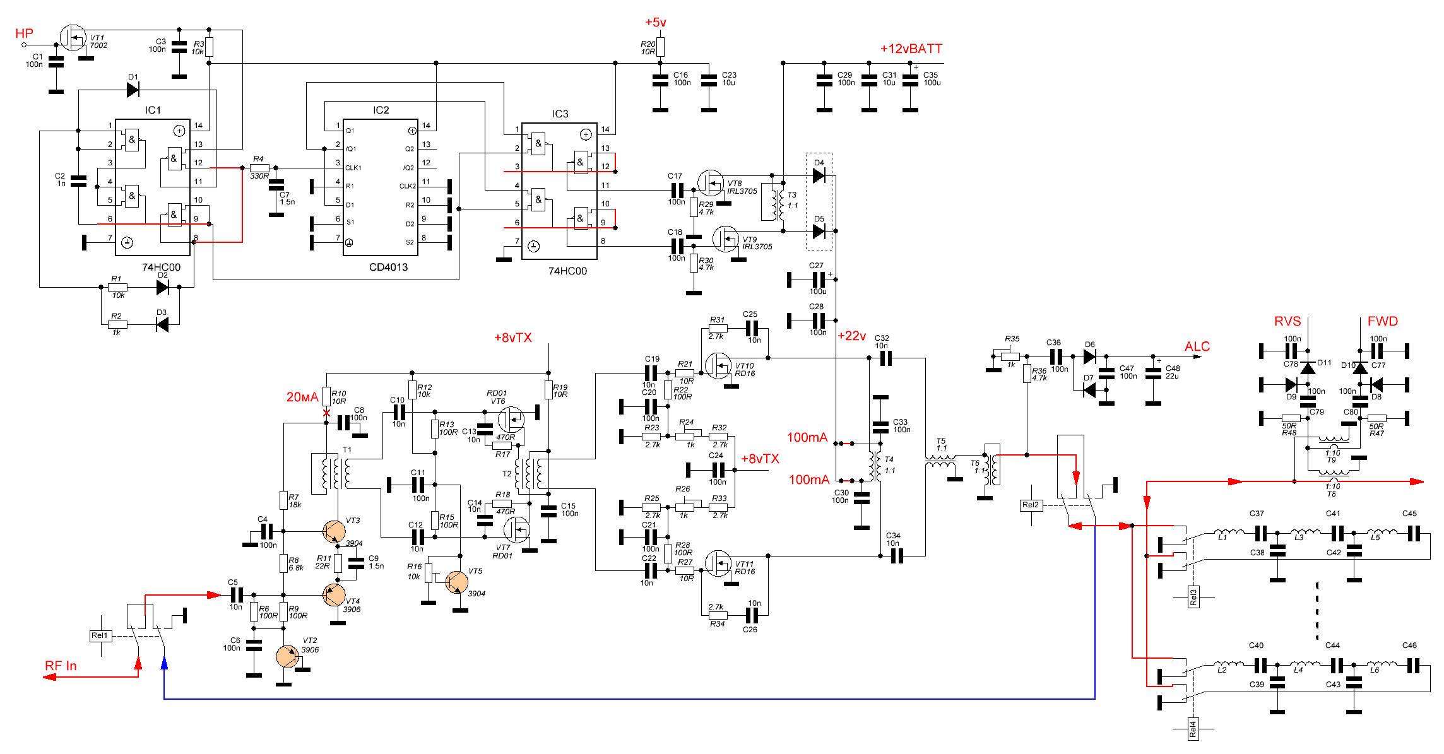
Splan/160x08PA.GIF
