Fmulder007/Karat-3.5/Splan/160x09RF_AF.GIF

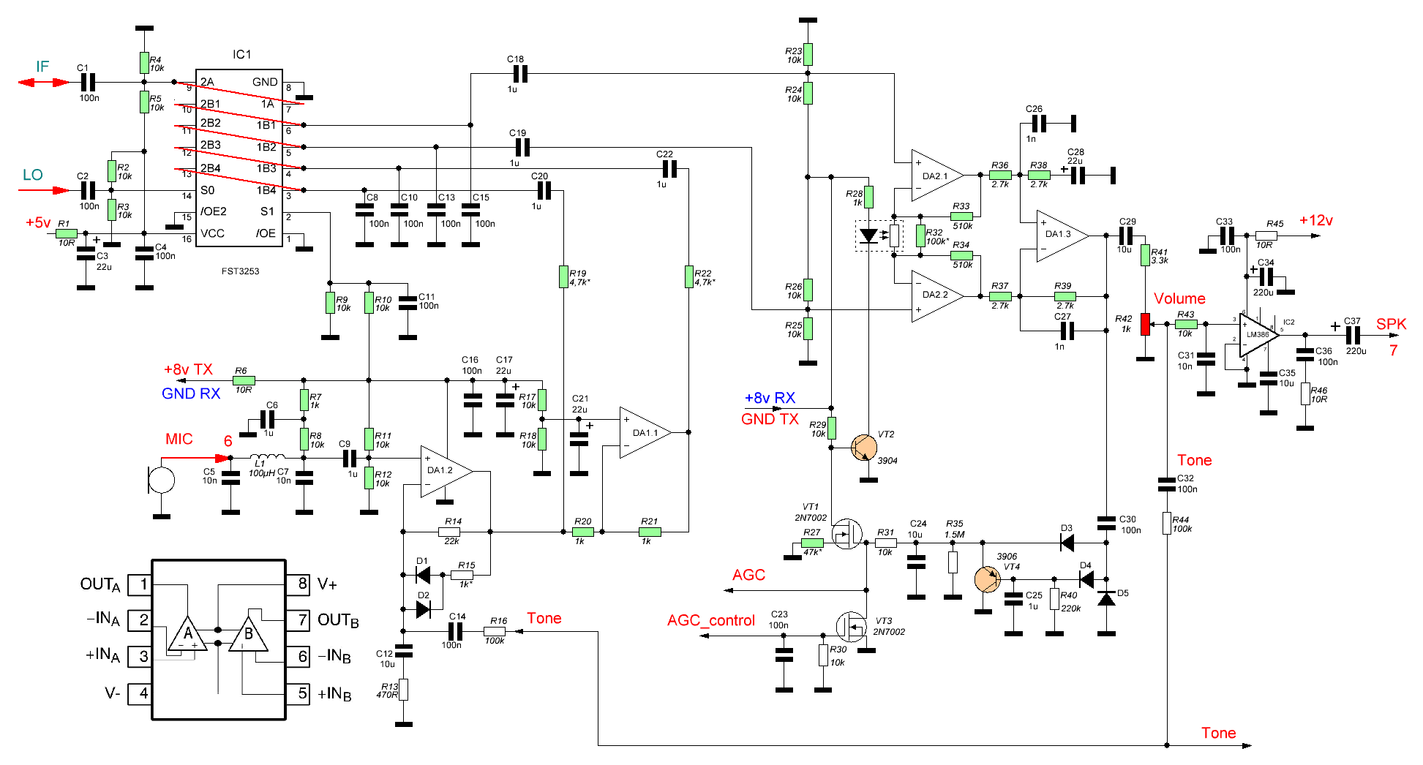
Splan/160x09RF_AF.GIF
