Fmulder007/Karat-3.5/Splan/170x09RF_AF_TX.JPG

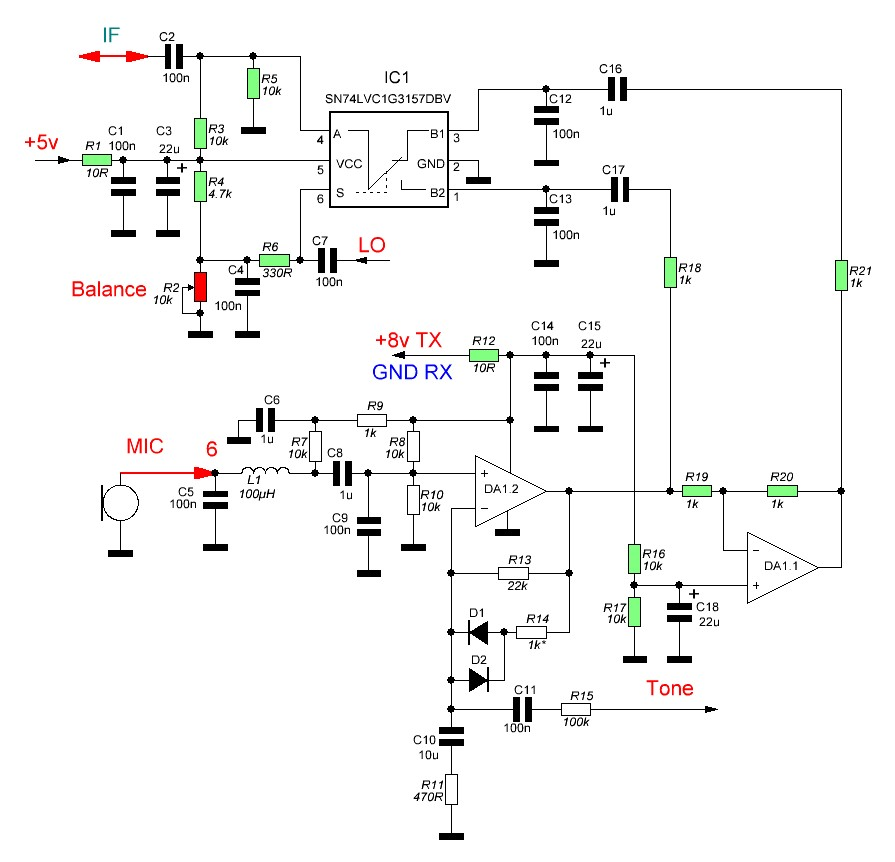
Splan/170x09RF_AF_TX.JPG
