Fmulder007/Karat-3.5/Splan/170x15RF.GIF

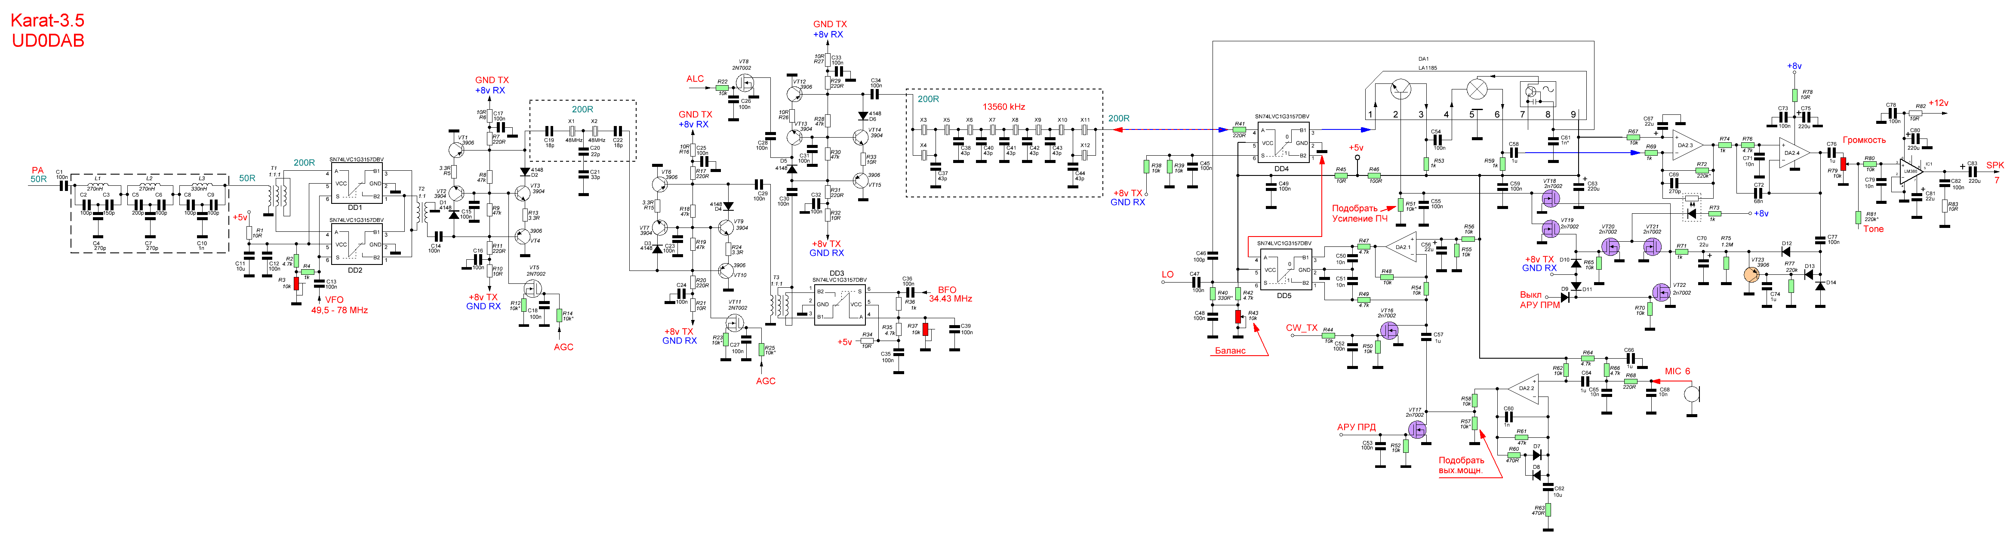
Splan/170x15RF.GIF
