Fmulder007/Karat-3.5/Splan/170x15RF_AF-IF_Section.GIF

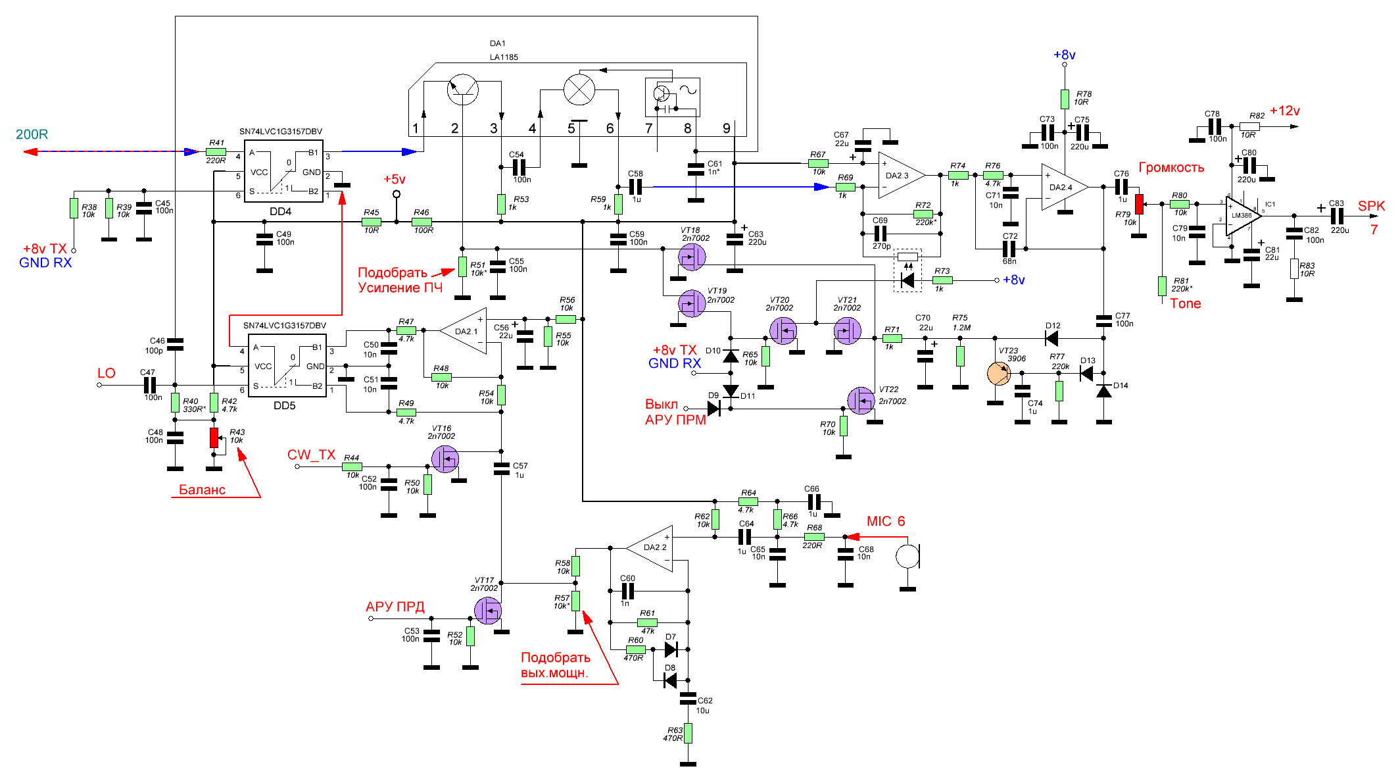
Splan/170x15RF_AF-IF_Section.GIF
