Fmulder007/Karat-3.5/Splan/AF.GIF

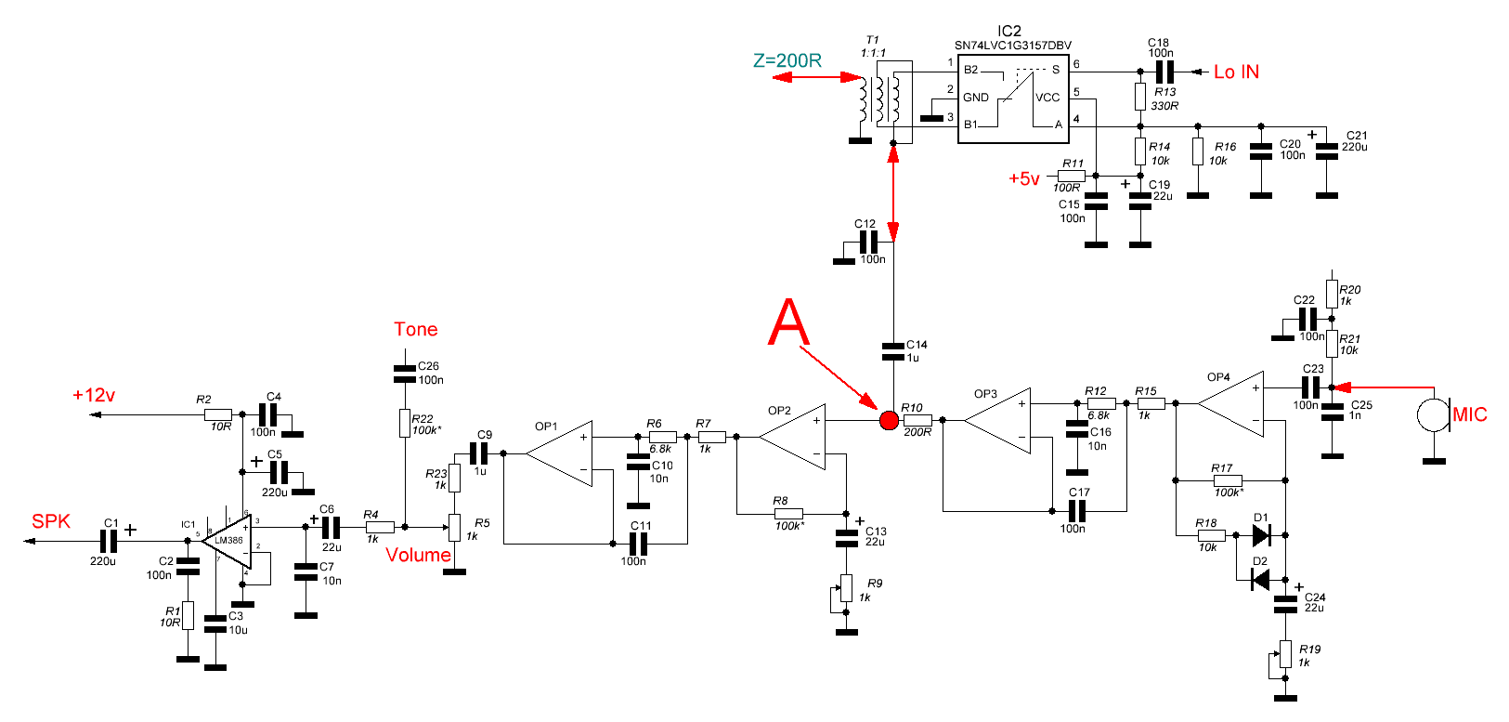
Splan/AF.GIF
