Fmulder007/Karat-3.5/Splan/Karat-3,5.GIF

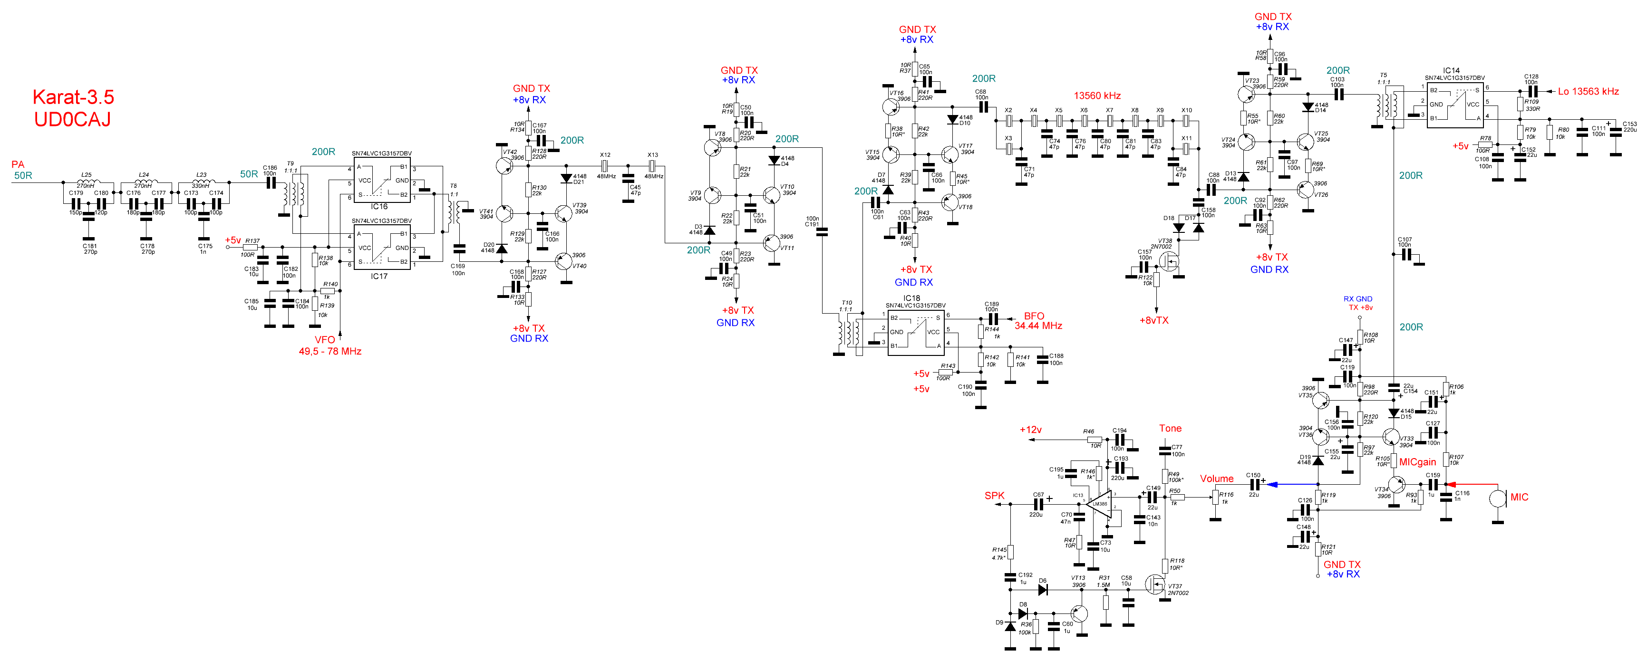
Splan/Karat-3,5.GIF
