Fmulder007/Karat-3.5/Splan/kf.GIF

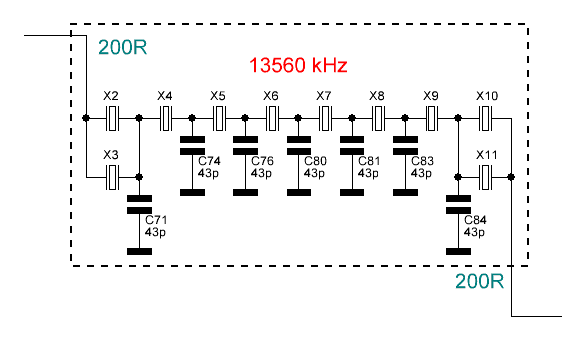
Splan/kf.GIF
