Fmulder007/Karat-3.5/Splan/MIC_AMP.GIF

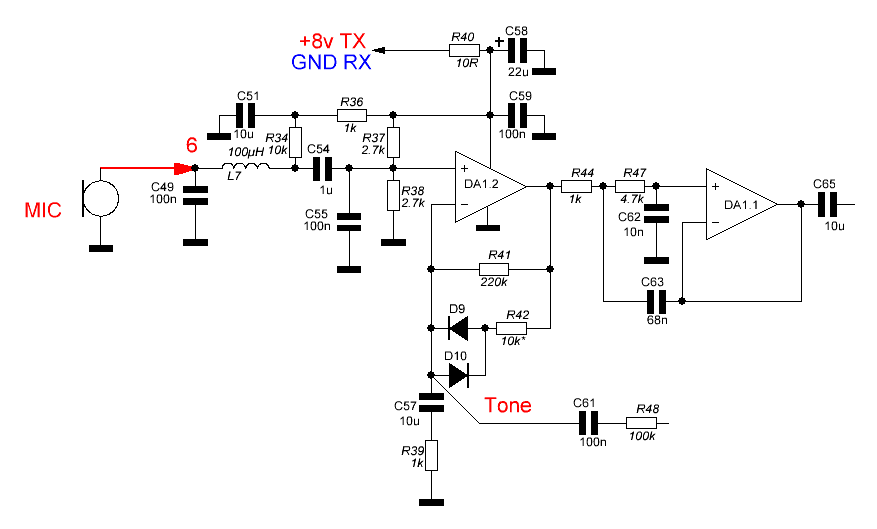
Splan/MIC_AMP.GIF
