Fmulder007/Karat-3.5/Splan/NewMIX.GIF

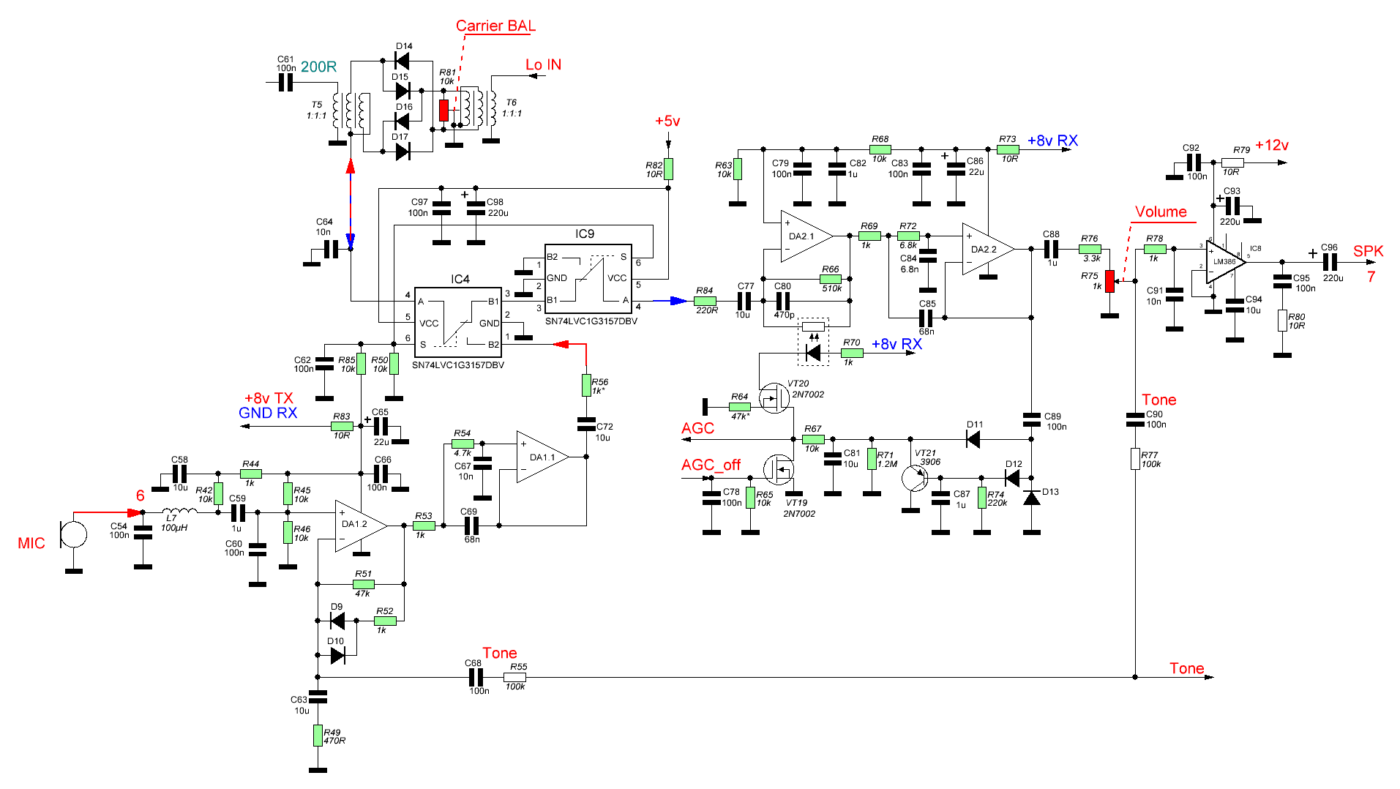
Splan/NewMIX.GIF
