Fmulder007/Karat-3.5/Splan/PowerX2.GIF

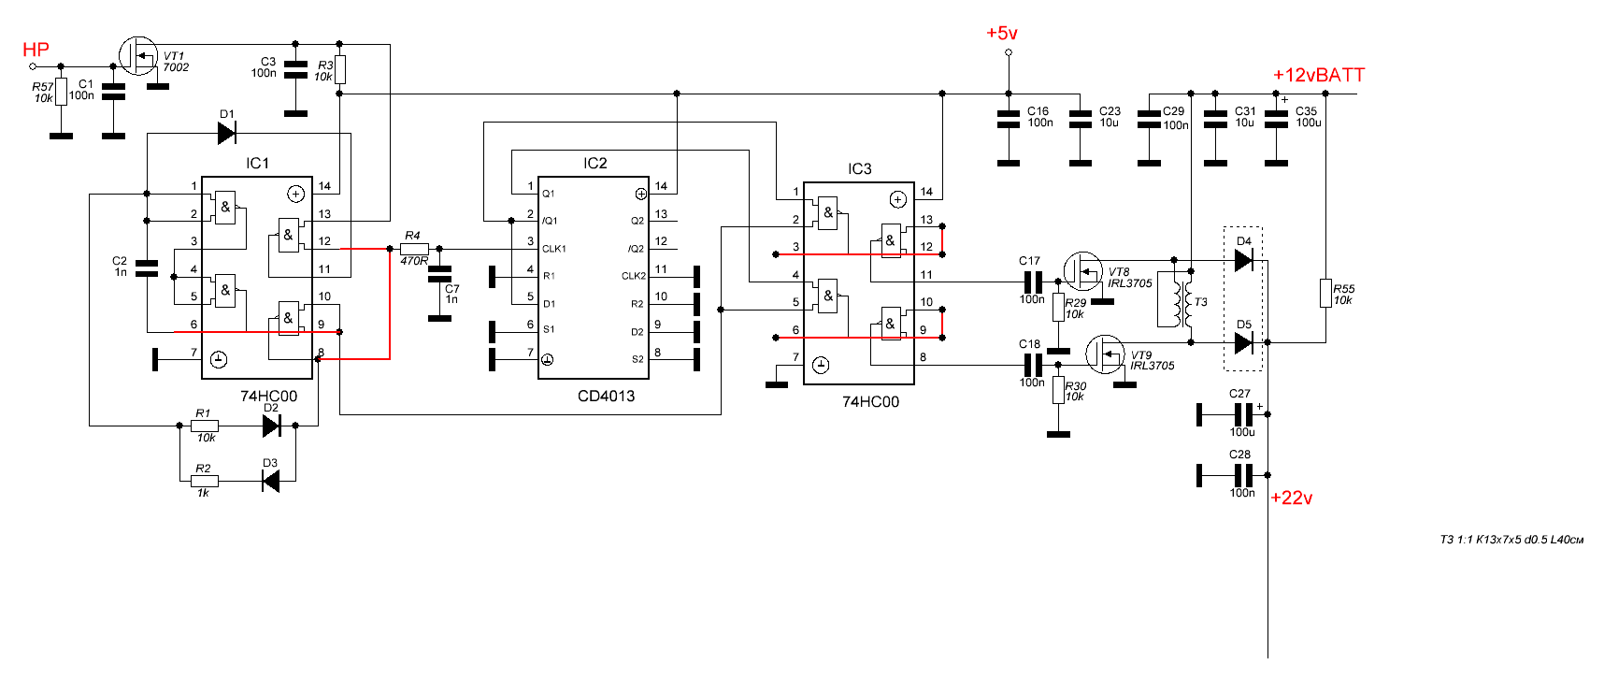
Splan/PowerX2.GIF
