Fmulder007/Karat-3.5/Tangenta_Connector.jpg

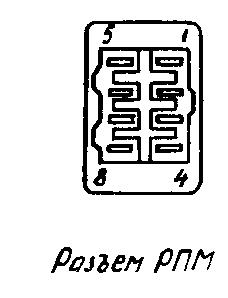
Tangenta_Connector.jpg
