Fmulder007/Karat-3.5/3D/ANT_INSULATOR.stl

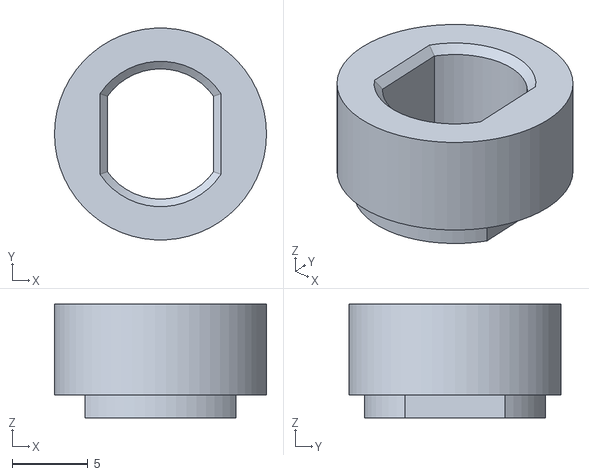
[picture p158: CAD file, 2026-10-05]
3D/ANT_INSULATOR.stl
14.0 x 14.0 x 7.50
