Fmulder007/Karat-3.5/3D/Karat_DEMSH_Support.stl

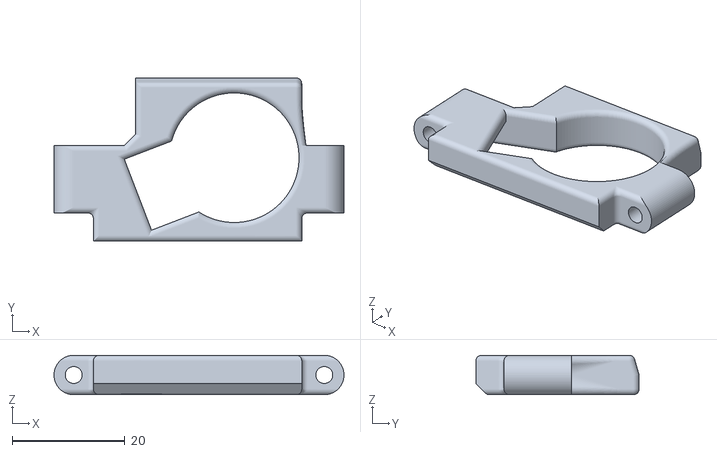
[picture p159: CAD file, 2026-09-02]
3D/Karat_DEMSH_Support.stl
51.5 x 29.0 x 7.00
