Fmulder007/Karat-3.5/3D/El_Cap_Support.stl

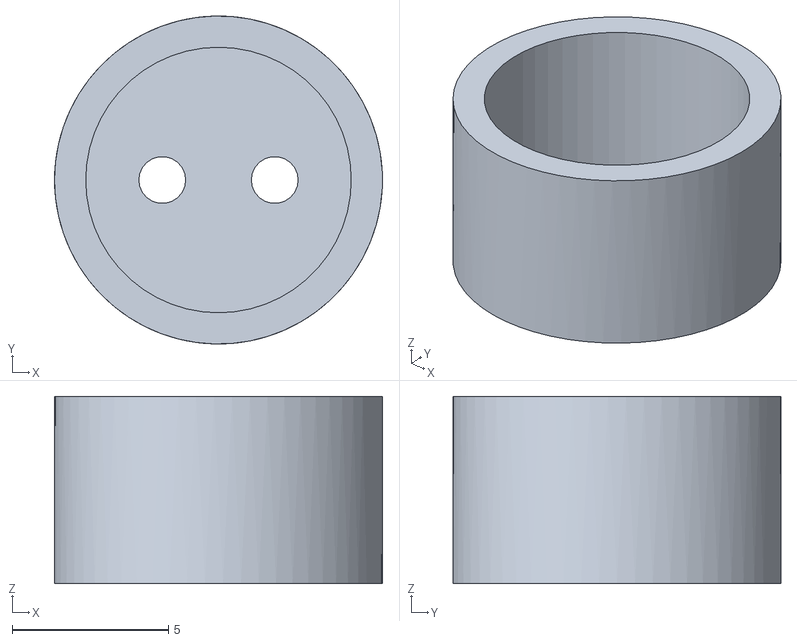
[picture p160: CAD file, 2026-07-06]
3D/El_Cap_Support.stl
10.5 x 10.5 x 6.00
