Fmulder007/Karat-3.5/3D/Volume.stl

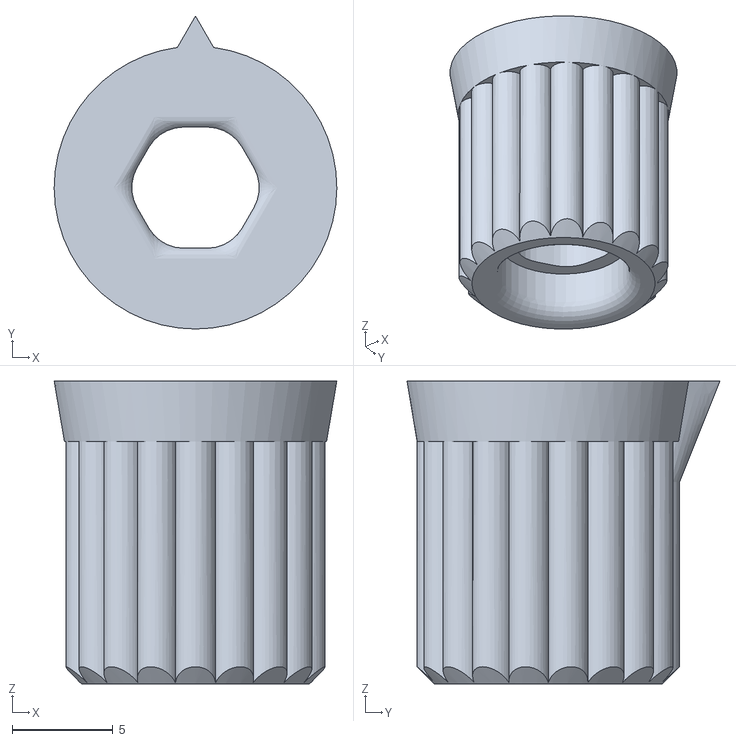
[picture p161: CAD file, 2026-05-31]
3D/Volume.stl
14.0 x 15.5 x 15.0
