Fmulder007/Karat-3.5/3D/Encoder.stl

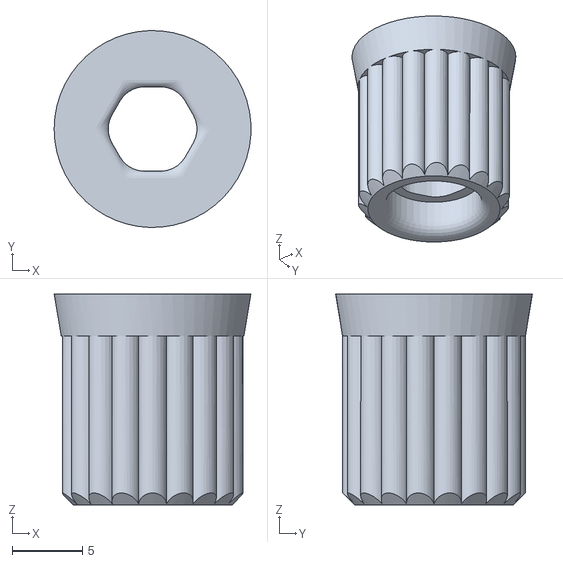
[picture p162: CAD file, 2026-05-31]
3D/Encoder.stl
14.0 x 14.0 x 15.0
