Fmulder007/Karat-3.5/3D/ANT_SPACER.stl

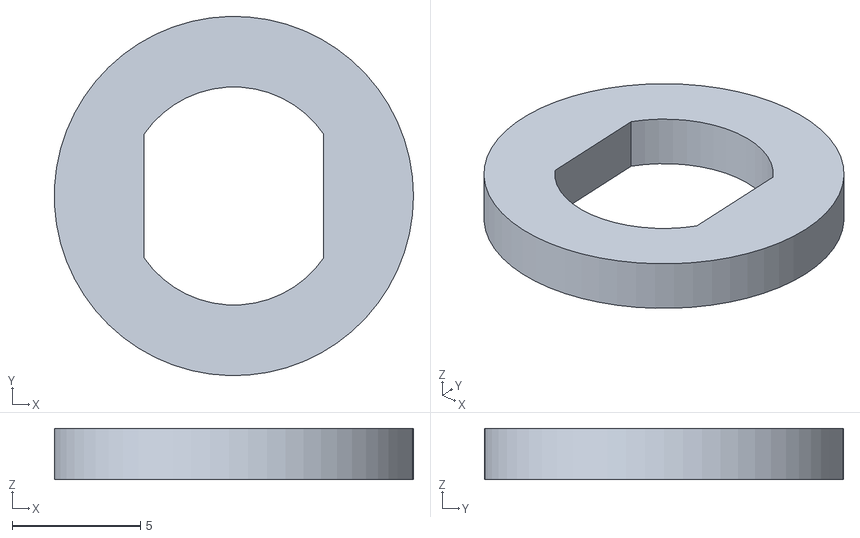
[picture p163: CAD file, 2026-02-21]
3D/ANT_SPACER.stl
14.0 x 14.0 x 2.00
