Fmulder007/Karat-3.5/3D/ATU_BUTN_TOP.stl

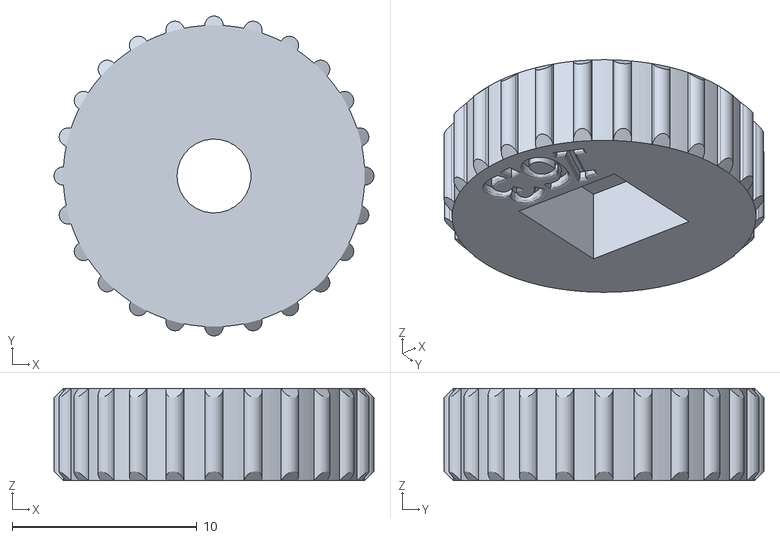
[picture p164: CAD file, 2026-02-15]
3D/ATU_BUTN_TOP.stl
17.3 x 17.3 x 5.00
