Fmulder007/Karat-3.5/3D/OptoPai1r.stl

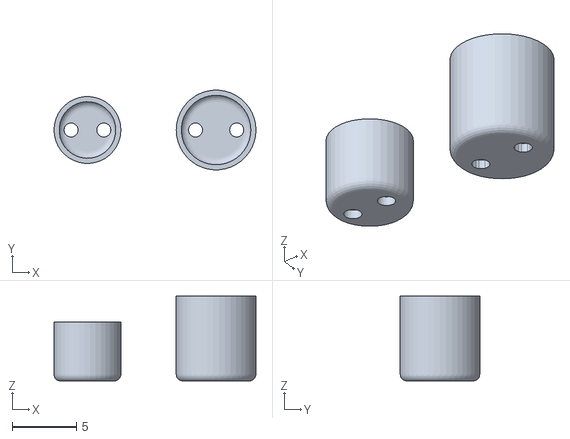
[picture p165: CAD file, 2025-12-09]
3D/OptoPai1r.stl
15.7 x 6.18 x 6.60
