Fmulder007/Karat-3.5/3D/OptoPair.stl

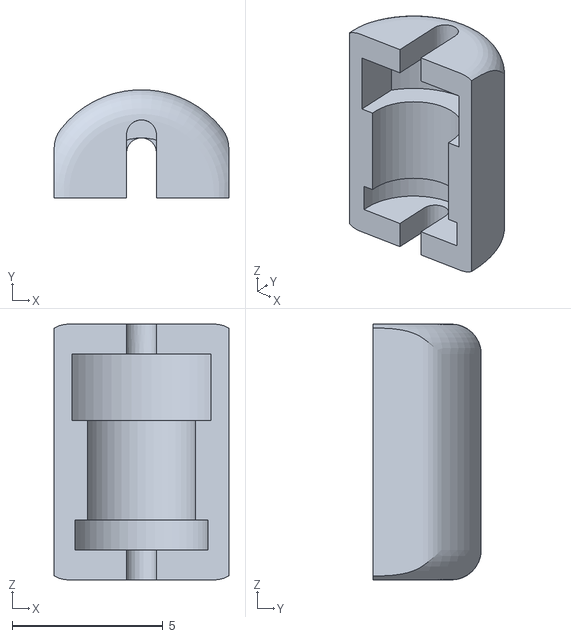
[picture p166: CAD file, 2025-10-28]
3D/OptoPair.stl
5.80 x 3.60 x 8.50
