Fmulder007/Karat-3.5/3D/Switch4.stl

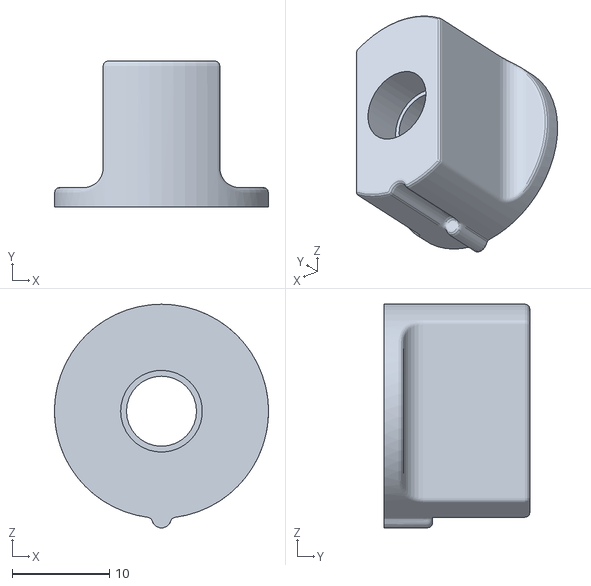
[picture p167: CAD file, 2025-10-04]
3D/Switch4.stl
22.0 x 15.0 x 23.0
