Fmulder007/Karat-3.5/3D/Front_Panel_1.dxf

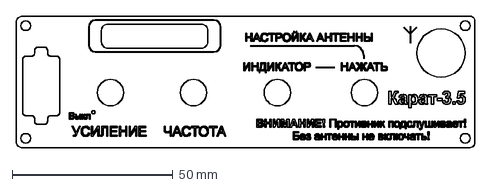
[picture p168: CAD file, 2025-07-15]
3D/Front_Panel_1.dxf
142.5 x 41.0 mm
