Fmulder007/Karat-3.5/3D/Front_Panel_CUT_LAY.dxf

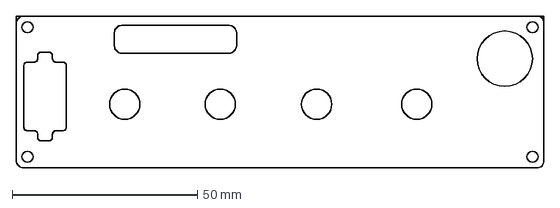
[picture p169: CAD file, 2025-07-15]
3D/Front_Panel_CUT_LAY.dxf
142.5 x 41.0 mm
