Fmulder007/Karat-3.5/3D/ATU_BUTN_BTM.stl

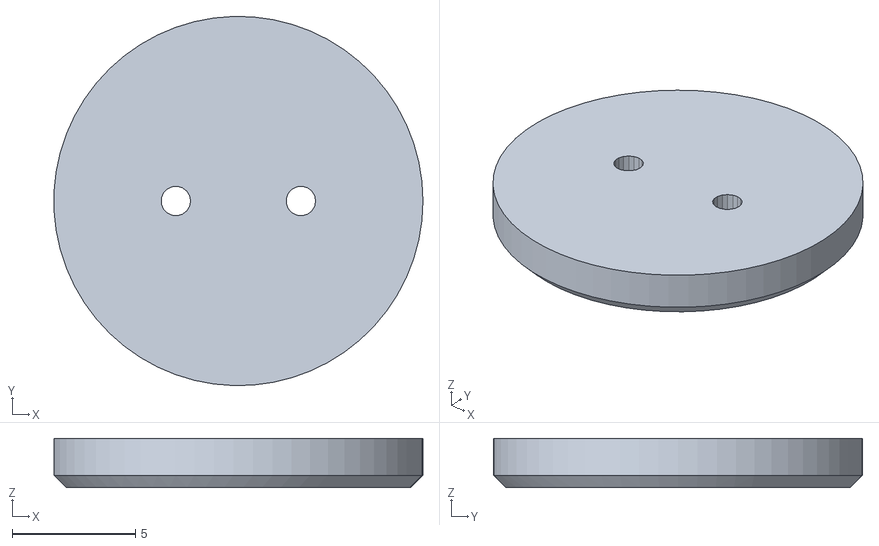
[picture p170: CAD file, 2025-05-03]
3D/ATU_BUTN_BTM.stl
15.0 x 15.0 x 2.00
