Fmulder007/Karat-3.5/3D/Volume1.stl

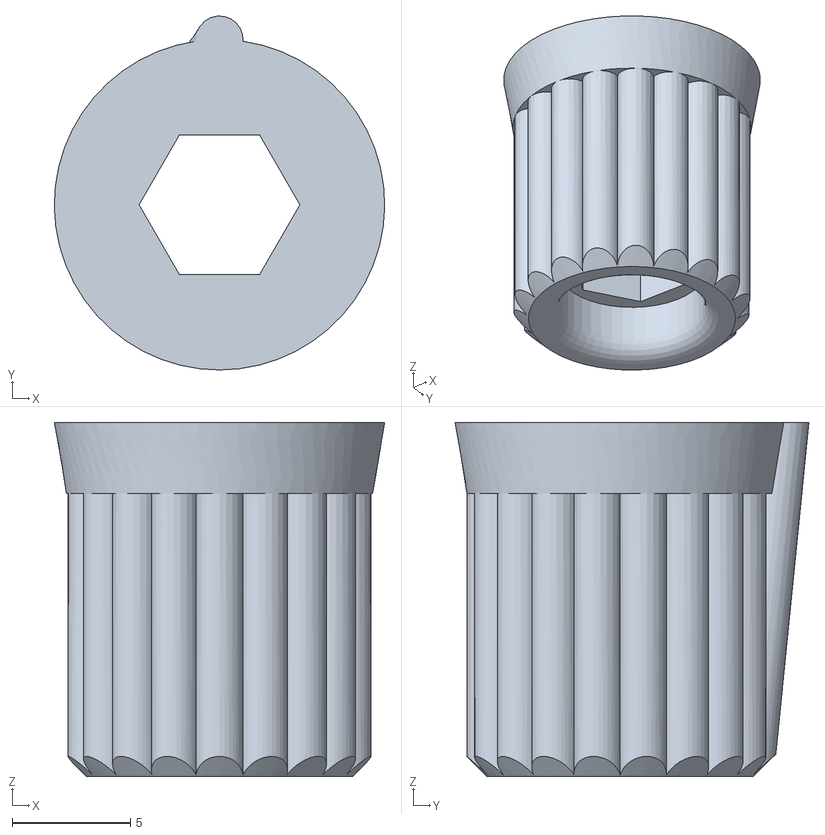
[picture p171: CAD file, 2025-04-27]
3D/Volume1.stl
14.0 x 15.0 x 15.0
