Fmulder007/Karat-3.5/3D/Antenna_Cnob1.stl

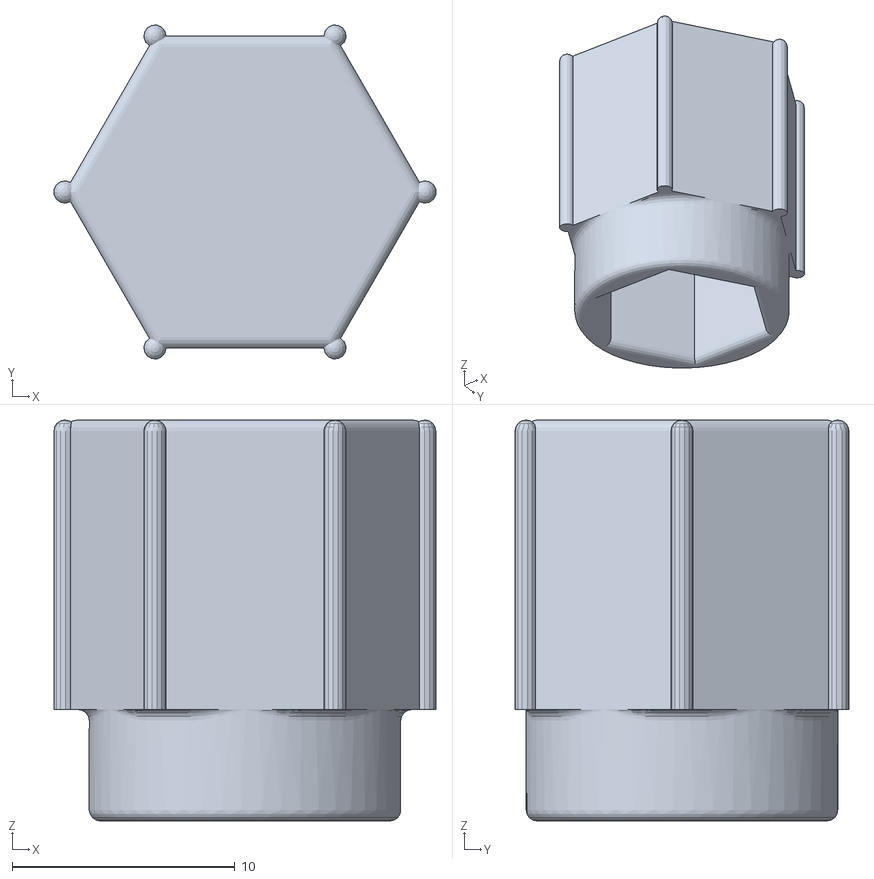
[picture p172: CAD file, 2025-03-15]
3D/Antenna_Cnob1.stl
17.1 x 15.0 x 18.0
