Fmulder007/Karat-3.5/3D/ATT_LED.stl

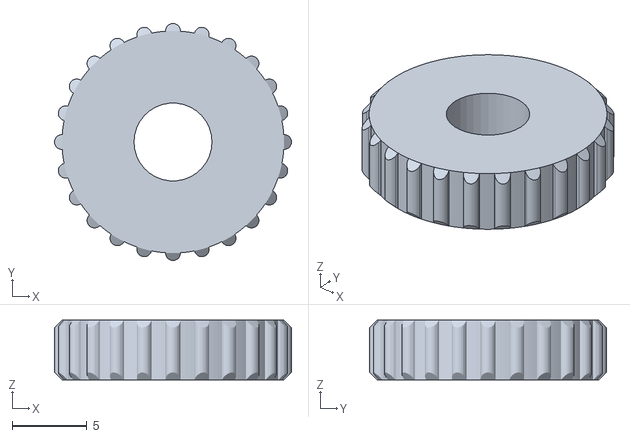
[picture p173: CAD file, 2025-02-27]
3D/ATT_LED.stl
15.8 x 15.8 x 4.00
