Fmulder007/Karat-3.5/3D/K13_SUPPORT.stl

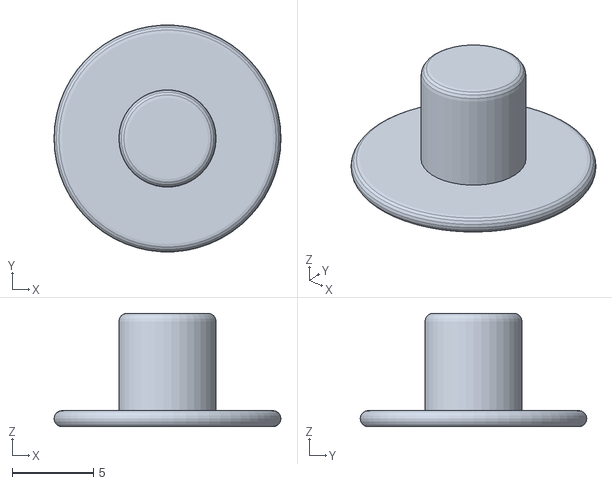
[picture p174: CAD file, 2025-02-27]
3D/K13_SUPPORT.stl
14.0 x 14.0 x 7.00
