Fmulder007/Karat-3.5/3D/ATU_T50_SUPPORT.stl

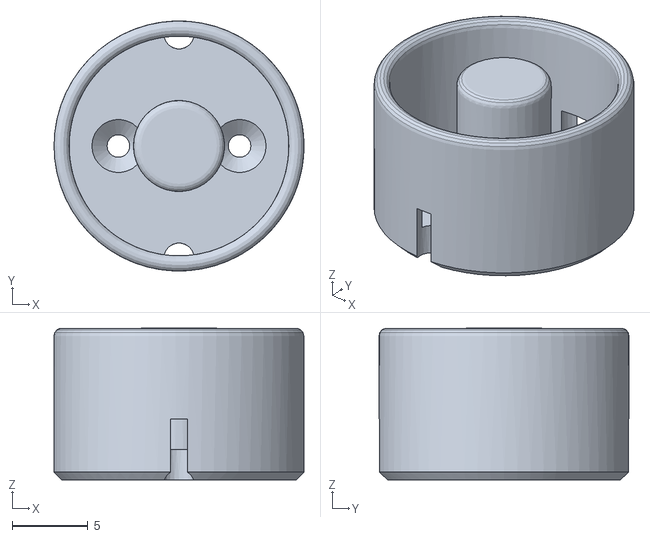
[picture p175: CAD file, 2025-02-02]
3D/ATU_T50_SUPPORT.stl
16.5 x 16.5 x 10.0
