Fmulder007/Karat-3.5/3D/Conductor_RD16.stl

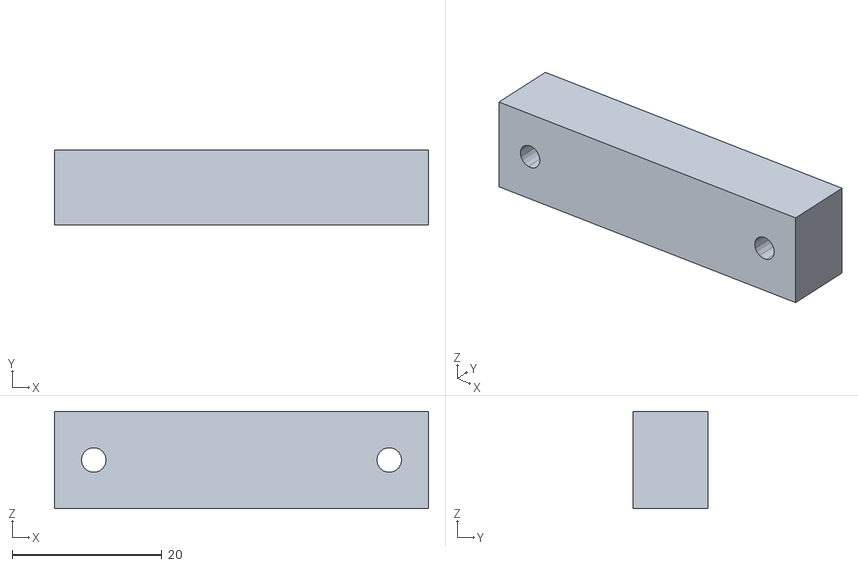
[picture p176: CAD file, 2024-12-03]
3D/Conductor_RD16.stl
50.0 x 10.0 x 13.0
