Fmulder007/Karat-3.5/3D/4P_Switch_Spacer.stl

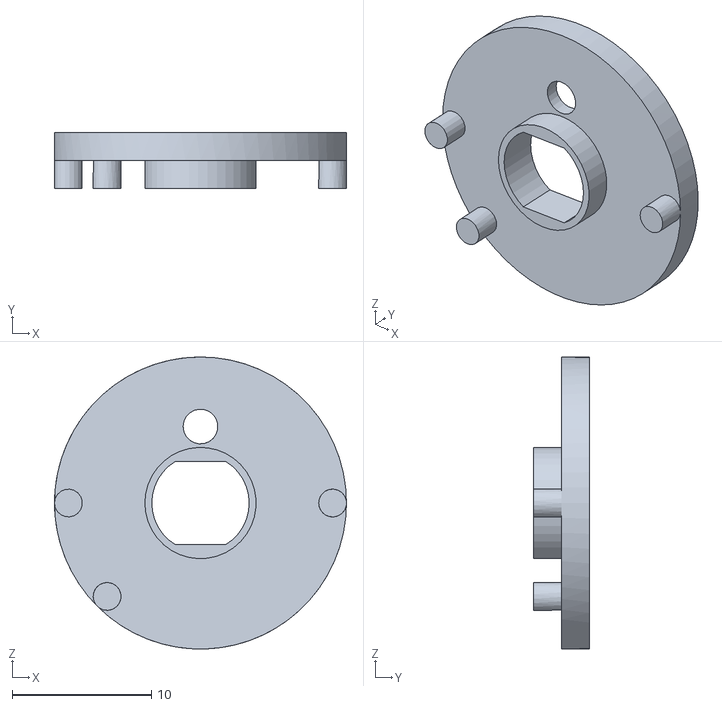
[picture p177: CAD file, 2024-08-27]
3D/4P_Switch_Spacer.stl
21.0 x 4.00 x 21.0
