Fmulder007/Karat-3.5/3D/4P_Switch_Cnob.stl

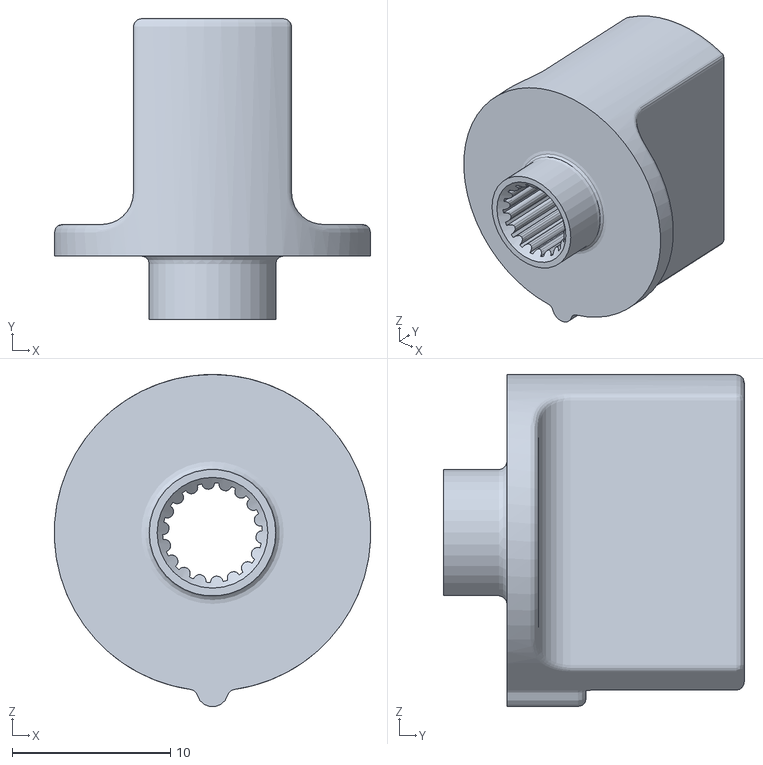
[picture p178: CAD file, 2024-08-27]
3D/4P_Switch_Cnob.stl
20.0 x 19.0 x 21.0
