Fmulder007/Karat-3.5/(list of files, cad)

Other CAD files:
3D/VarioCnob.stl
3D/Front_Panel.dwg
3D/Volume_Cnob4.stl
3D/4P_Switch_Cnob.ipt
3D/4P_Switch_Spacer.ipt
3D/ANT_INSULATOR.ipt
3D/ANT_SPACER.ipt
3D/ATT_BUTN.ipt
3D/ATT_LED_BTM.ipt
3D/ATU_BUTN.ipt
3D/ATU_T50_SUPPORT.ipt
3D/Antenna_Cnob1.ipt
3D/Conductor_RD16.ipt
3D/Conductor_Volume_Encoder.ipt
3D/El_Cap_Support.ipt
3D/Encoder.ipt
3D/Front_Panel.ipt
3D/Front_Panel_1.dwg
3D/OldVersions/ANT_INSULATOR.0001.ipt
3D/OldVersions/ATT_BUTN.0006.ipt
3D/OldVersions/ATT_LED_BTM.0013.ipt
3D/OldVersions/ATU_BUTN.0010.ipt
3D/OldVersions/ATU_T50_SUPPORT.0002.ipt
3D/OldVersions/Antenna_Cnob1.0001.ipt
3D/OldVersions/El_Cap_Support.0001.ipt
3D/OldVersions/Encoder.0003.ipt
3D/OldVersions/Front_Panel.0002.ipt
3D/OldVersions/OptoPai1r.0002.ipt
3D/OldVersions/OptoPair.0007.ipt
3D/OldVersions/VarioCnob.0002.ipt
3D/OldVersions/Volume.0003.ipt
3D/OldVersions/Volume1.0002.ipt
3D/OptoPai1r.ipt
3D/OptoPair.ipt
3D/Switch4.ipt
3D/VarioCnob.ipt
3D/Volume.ipt
3D/Volume1.ipt
