Fmulder007/Karat-3.5/Splan/Board Wiring.GIF

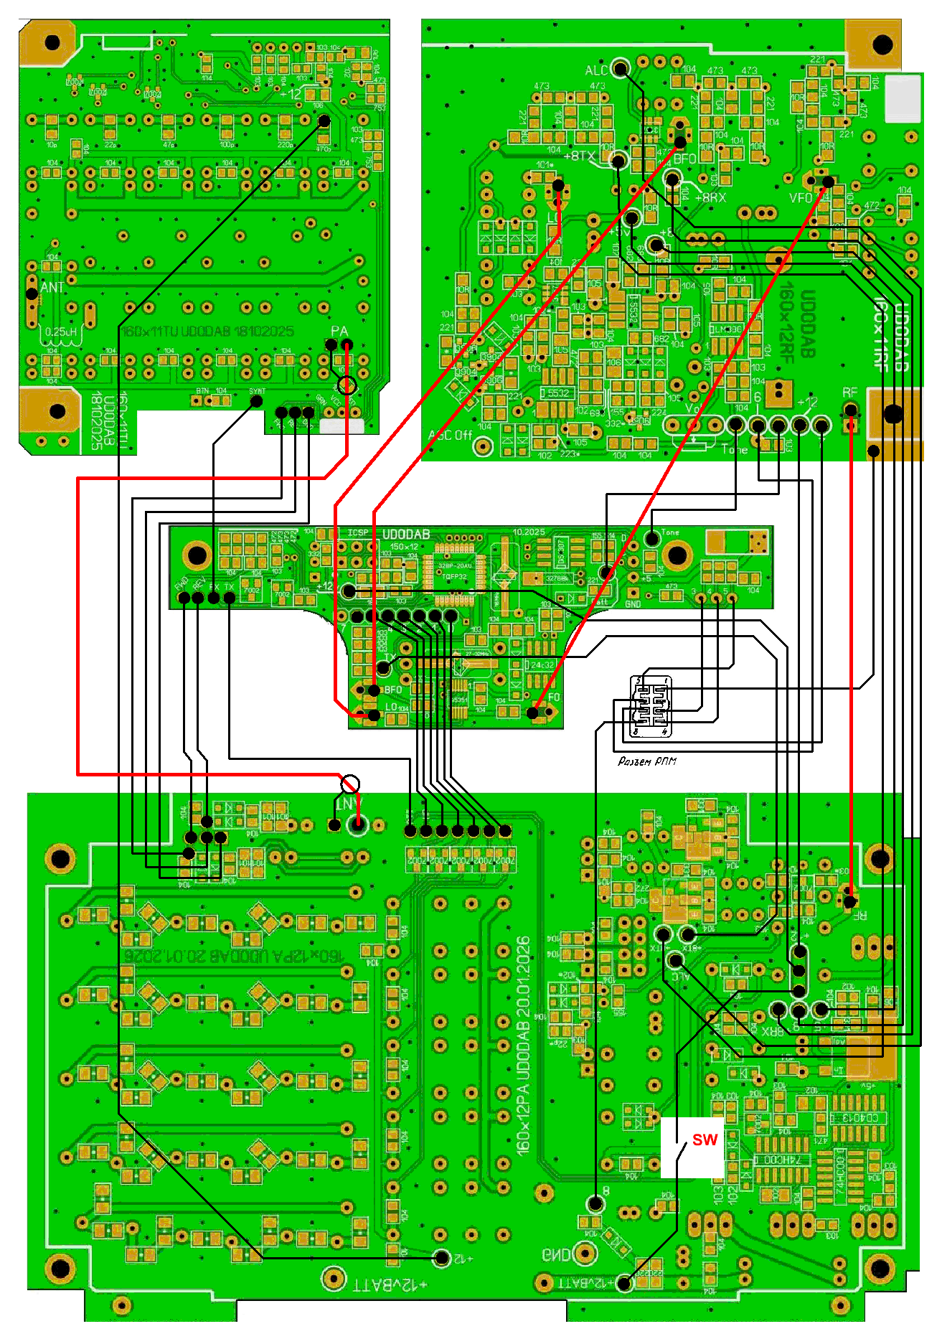
Splan/Board Wiring.GIF
