Fmulder007/Karat-3.5/Man/Wiring_Board.pdf

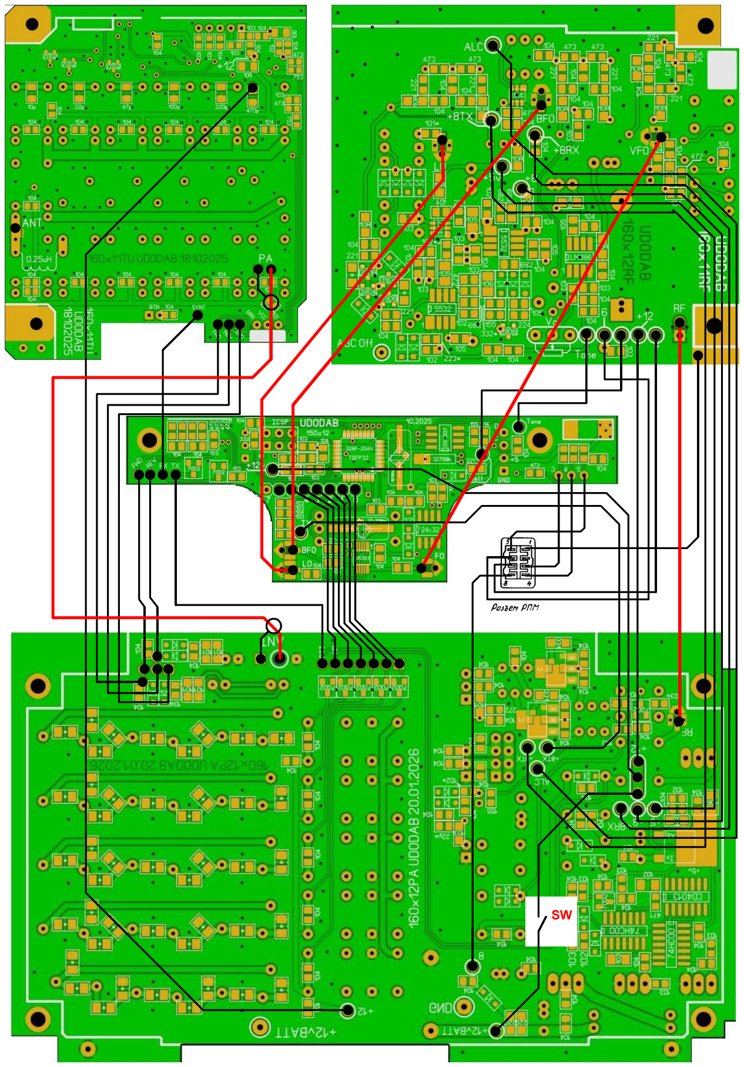
[picture p180: page 1]
