Fmulder007/Karat-3.5/3D/Front_Panel_3.pdf

## Карат-3

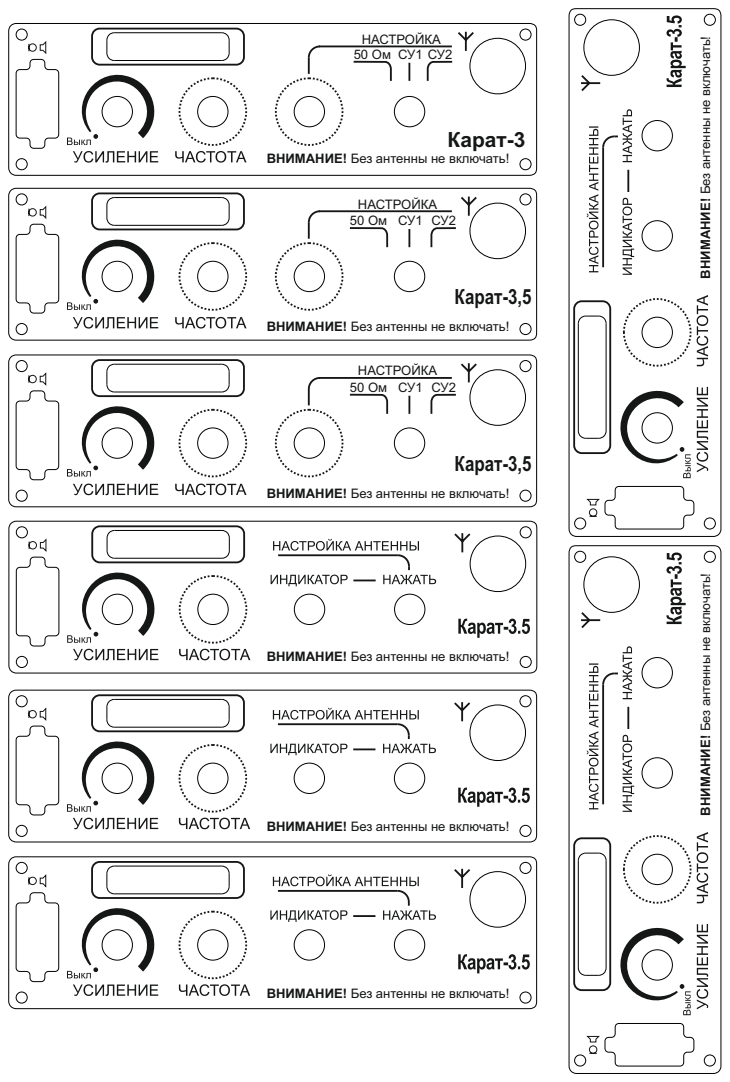
[picture p181: page 1]
НАСТРОЙКА 50 Ом СУ1 СУ2; Карат-3,5; НАСТРОЙКА

ВНИМАНИЕ! Без антенны не включать!
