Fmulder007/Karat-3.5/(list of files, drawings)

Other design files:
LAY/160x05TU1.lay6
LAY/160x06TU1.lay6
LAY/160x07AT.lay6
LAY/160x07PA.lay6
LAY/160x07RF.lay6
LAY/160x08AT.lay6
LAY/160x08RF.lay6
LAY/160x09PA.lay6
LAY/160x10PA.lay6
LAY/160x10RF.lay6
LAY/160x10TU.lay6
LAY/160x11TB.lay6
LAY/160x11TU.lay6
LAY/160x12.lay6
LAY/160x12PA.lay6
LAY/160x13RF.lay6
LAY/old/150x12.lay6
LAY/old/160x01.lay6
LAY/old/160x01LPF.lay6
LAY/old/160x02PA.lay6
LAY/old/160x03PA.lay6
LAY/old/160x03RF.lay6
LAY/old/160x03RF_betta1.lay6
LAY/old/160x03RF_betta.lay6
LAY/old/160x03SubPA.lay6
LAY/old/160x05PA.lay6
LAY/old/160x05RF.lay6
LAY/old/160x05TU1.lay6
LAY/old/160x05TU.lay6
LAY/old/160x06RF.lay6
LAY/old/160x06TU1.lay6
LAY/old/160x06TU.lay6
LAY/old/160x07AT.lay6
LAY/old/160x07PA.lay6
LAY/old/160x07RF.lay6
LAY/old/160x08AT.lay6
LAY/old/160x08PA.lay6
LAY/old/160x08RF.lay6
LAY/old/160x09PA.lay6
LAY/old/160x09RF1.lay6
LAY/old/160x09RF.lay6
LAY/old/160x09TU.lay6
LAY/old/160x10PA.lay6
LAY/old/160x10RF.lay6
LAY/old/160x10TU.lay6
LAY/old/160x11RF.lay6
LAY/old/160x11TB.lay6
LAY/old/160x12RF.lay6
LAY/old/160x13RF.lay6
LAY/old/maket_trakt.lay6
LAY/old/PA.lay6
LAY/Sub_CW1.lay6
LAY/SubPA_RD16.lay6
LAY/SubPA_RD16_2.lay6
Man/Appendix0.spl7
Man/Appendix1.spl7
Man/Appendix2.spl7
Man/Appendix3.spl7
Man/Board Wiring.spl7
Simm/07.ewb
Simm/AGC2.ms14
Simm/ALC_det_0.ms14
Simm/bidamp2.ms14
Simm/bidamp3.ms14
Simm/bidamp5.ms14
Simm/bidamp6.ms14
Simm/bidamp.ms14
Simm/bidampAF.ms14
Simm/cascode17.ms14
Simm/cascode_test.pdsprj
Simm/Current_Sensor.ms14
Simm/CW_Gen.ms14
Simm/FEET_BIDAmp.ms14
Simm/MIC_AMPk35.ms14
Simm/MIC_AMPv1.ms14
Simm/Mixer2.ms14
Simm/new_bidamp.ms14
Simm/PApreamp.ms14
Simm/RF_PRE.ms14
Simm/singen1.ms14
Simm/singen2.ms14
Simm/Voltage_Control_Circut2.ms14
Simm/Voltage_Control_Circut.ms14
Splan/150x12.spl7
Splan/160x03PA.spl7
Splan/160x03T.spl7
Splan/160x05PA.spl7
Splan/160x05RF.spl7
Splan/160x05TU.spl7
Splan/160x07PA.spl7
Splan/160x07RF.spl7
Splan/160x08PA.spl7
Splan/160x08RF.spl7
Splan/160x09PA.spl7
Splan/160x09RF.spl7
Splan/160x10PA.spl7
Splan/160x10RF.spl7
Splan/160x11RF.spl7
Splan/160x12RF.spl7
Splan/160x13RF.spl7
Splan/170x01.spl7
Splan/170x09RF.spl7
Splan/170x15RF.spl7
Splan/bidaamptest.spl7
Splan/Karat3_5.spl7
Splan/Karat-3,5.spl7
Splan/New_tuner3.spl7
Splan/NewATU.spl7
Splan/newmix.spl7
Splan/old/160x03PA.spl7
Splan/old/160x03T.spl7
Splan/old/160x05PA.spl7
Splan/old/160x05RF.spl7
Splan/old/160x05TU.spl7
Splan/old/160x07PA.spl7
Splan/old/160x07RF.spl7
Splan/old/160x08PA.spl7
Splan/old/160x08RF.spl7
Splan/old/160x09PA.spl7
Splan/old/160x13RF.spl7
Splan/old/170x01.spl7
Splan/old/170x09RF.spl7
Splan/old/bidaamptest.spl7
Splan/old/Karat3_5.spl7
Splan/old/Karat-3,5.spl7
Splan/old/newmix.spl7
Splan/old/var_mix1.spl7
Splan/SWITCH.spl7
Splan/syngen1.spl7
Splan/var_mix1.spl7
