Fmulder007/Karat-3.5/(commit log)

2025-04-16 upd man
    [Appendix1.spl7]
2025-07-15 Update Техническое описание и инструкция по эксплуатации.pdf
2025-08-12 Update Рассчёт частот синтеза.ods
    [Рассчёт частот синтеза.ods]
2025-09-02 upd
    Обновлены чертежи ручек энкодера и громкости
    Обновлена прошивка.
    [Encoder.0002.ipt, Encoder.ipt, Encoder.stl, Volume.0001.ipt, Volume.ipt, Volume.stl]
2025-09-24 upd 160x11 firmware
    Добавлена автонастройка АТУ при подачи тона с PTT. Задействован неиспользуемый RX ключ синтезатора для срабатывания кнопки АТУ
2025-11-10 Create Рыба мануала от RU0AOG.txt
2026-07-06 upd 170x15RF sch
    170x15RF - Новая схема узла НЧ-ПЧ, с формированием CW посылок разбалансировкой смесителя 3157
    [160x13RF.spl7, 170x13RF.spl7, 170x15RF.spl7, El_Cap_Support.0001.ipt, El_Cap_Support.ipt, El_Cap_Support.stl, Sub_CW1.lay6, singen1.ms14]
2026-07-23 upd
    Correcting error 160x13RF
    [160x13RF.lay6, Рассчёт частот синтеза.ods]
2026-11-11 docs: add asymmetric FWD REV filter plan
2026-11-11 Добавлен план полного Backup/Restore для 160x15
2026-11-11 Реализован полный Backup/Restore с двумя ручными слотами
2026-11-11 Добавлены проверки карты памяти Backup
2026-11-11 Русифицированы сообщения Backup/Restore
2026-11-12 Добавить план оптимизации EEPROM-записей
2026-11-12 Унифицировать формирование и проверку EEPROM-записей
2026-11-12 Отметить выполненные пункты оптимизации EEPROM-записей
2026-11-12 Добавить план консольной индикации Backup и Restore
2026-11-12 Добавить четырёхстрочный журнал Backup и Restore
2026-11-12 Выровнять отступ сообщения об ошибке Backup
2026-11-12 Отметить реализацию консольной индикации Backup и Restore
