Fmulder007/Karat-3.5/(notices)

Notices in the files:
Code/160x14/Eeprom24C32_64.cpp:
This library is free software: you can redistribute it and/or modify it under
the terms of the GNU Lesser General Public License as published by the Free
